juan-LARRAYA/TPP/firmware/demos/TPP STM/arduino VARIOS/demos/DuinoSTM32/BQ comands.png

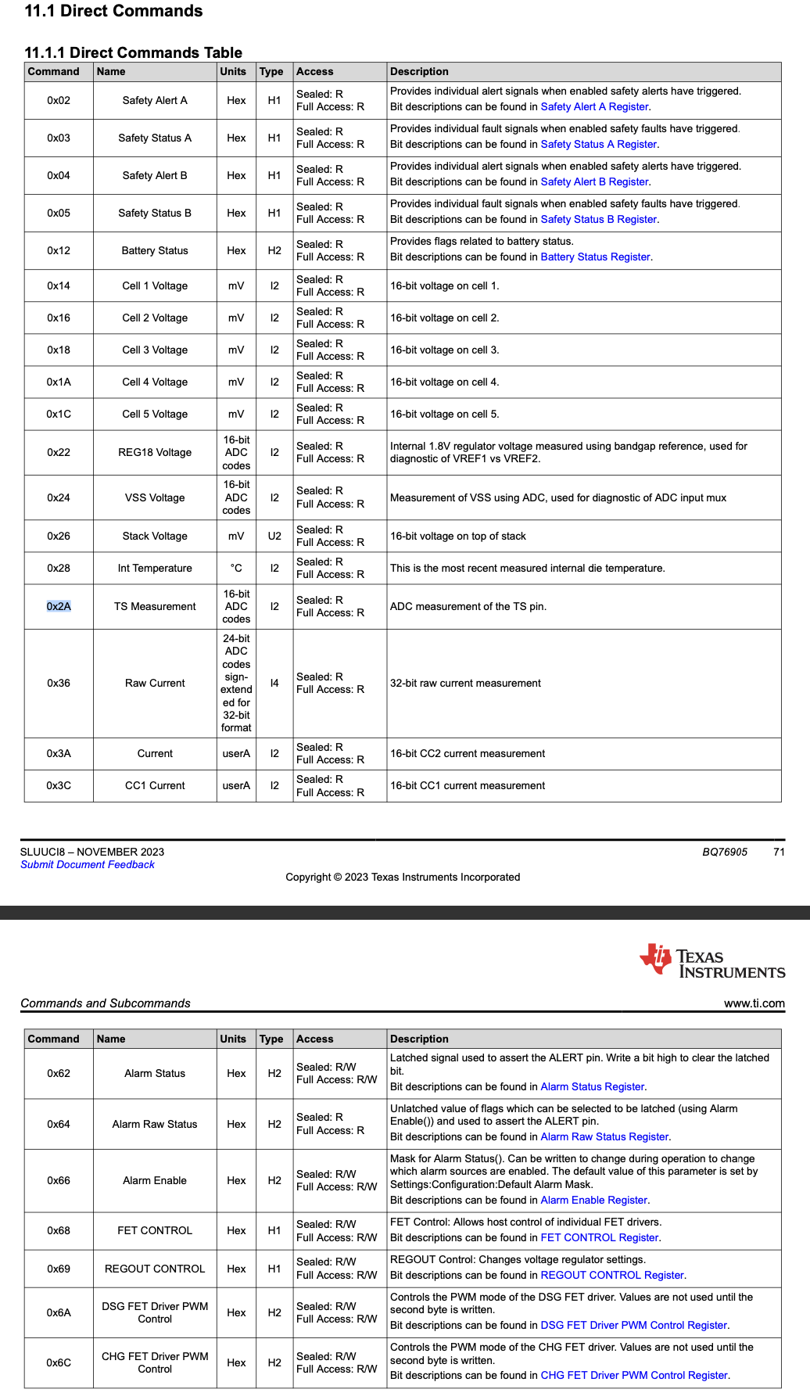
firmware/demos/TPP STM/arduino VARIOS/demos/DuinoSTM32/BQ comands.png
