juan-LARRAYA/TPP/firmware/demos/TPP STM/arduino VARIOS/demos/DuinoSTM32/la buena config.png

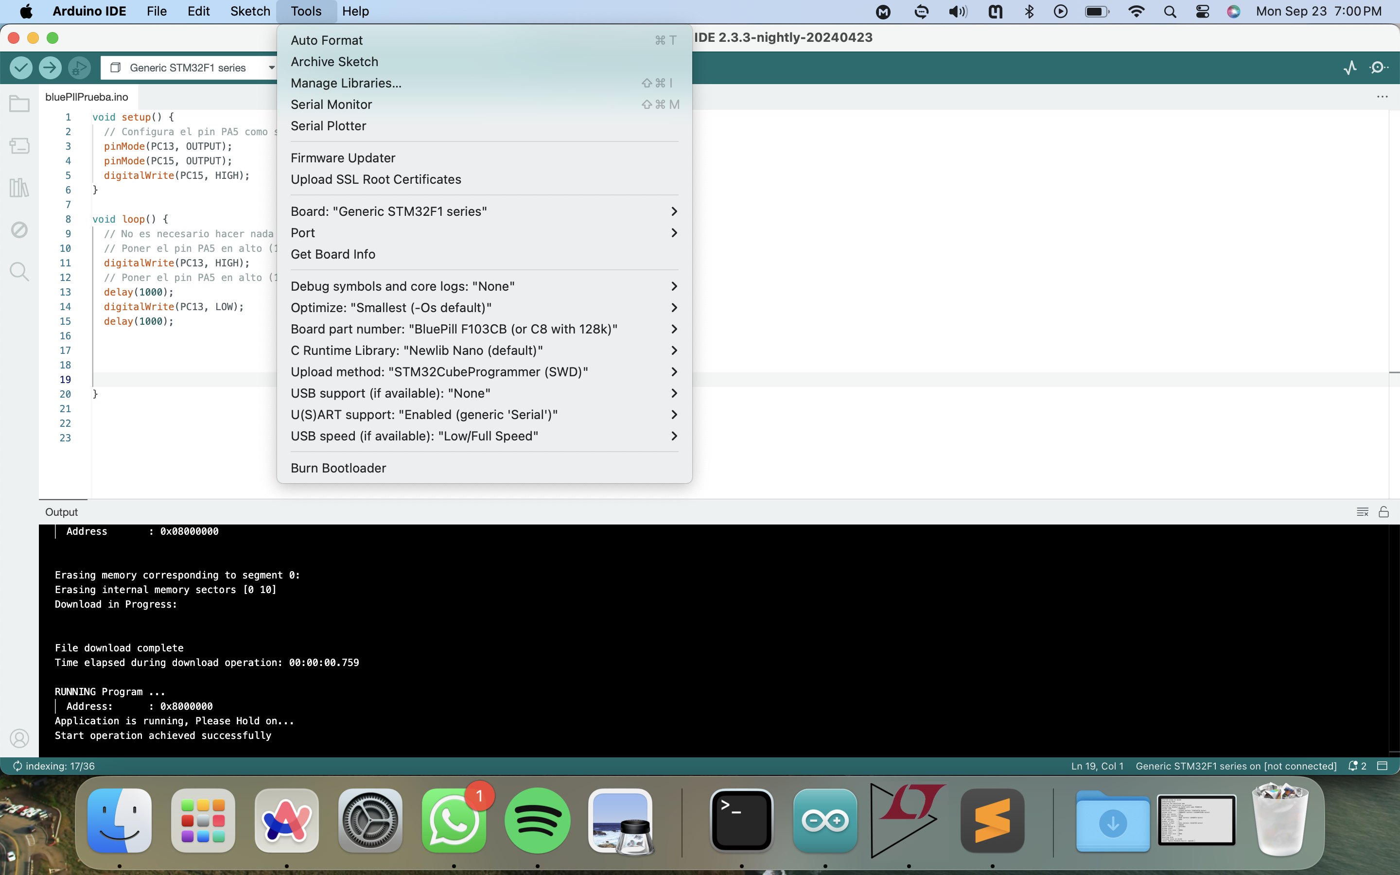
firmware/demos/TPP STM/arduino VARIOS/demos/DuinoSTM32/la buena config.png
