juan-LARRAYA/TPP/firmware/demos/TPP STM/arduino VARIOS/demos/DuinoSTM32/STM32 PINOUT.png

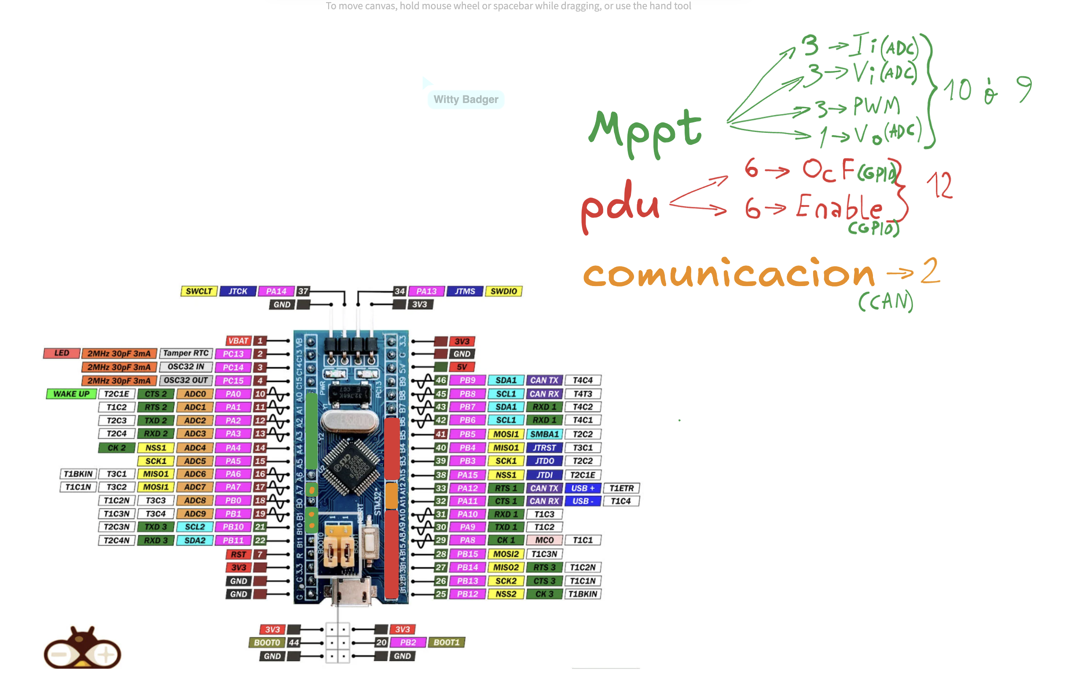
firmware/demos/TPP STM/arduino VARIOS/demos/DuinoSTM32/STM32 PINOUT.png
