juan-LARRAYA/TPP/firmware/demos/TPP STM/arduino VARIOS/demos/stm32 clocktree.jpg

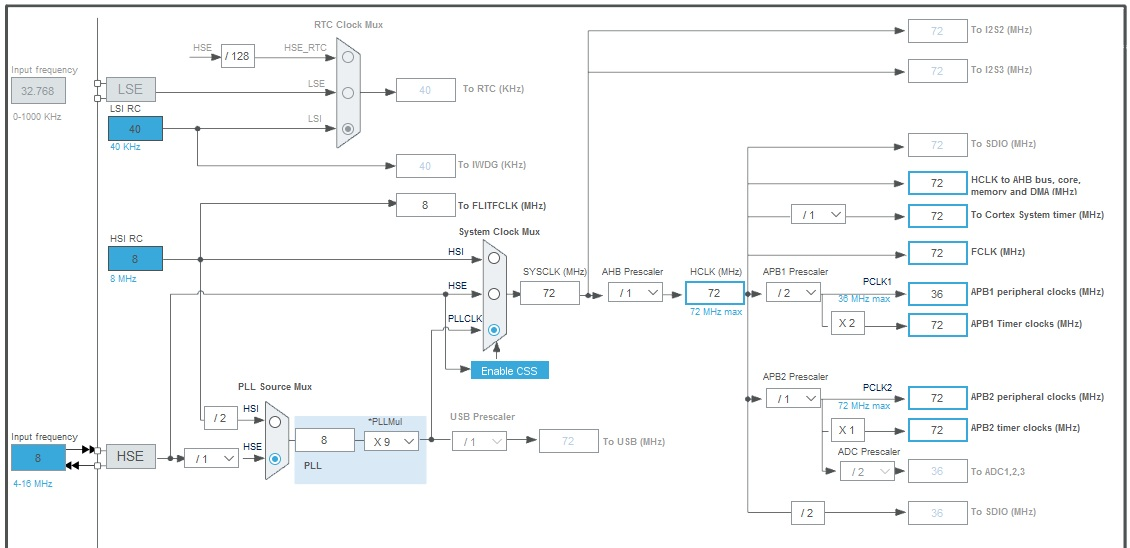
firmware/demos/TPP STM/arduino VARIOS/demos/stm32 clocktree.jpg
