juan-LARRAYA/TPP/firmware/demos/TPP STM/arduino VARIOS/piserial/graficos/carga 0,5 con errores/corrienteCarga0-5C.png

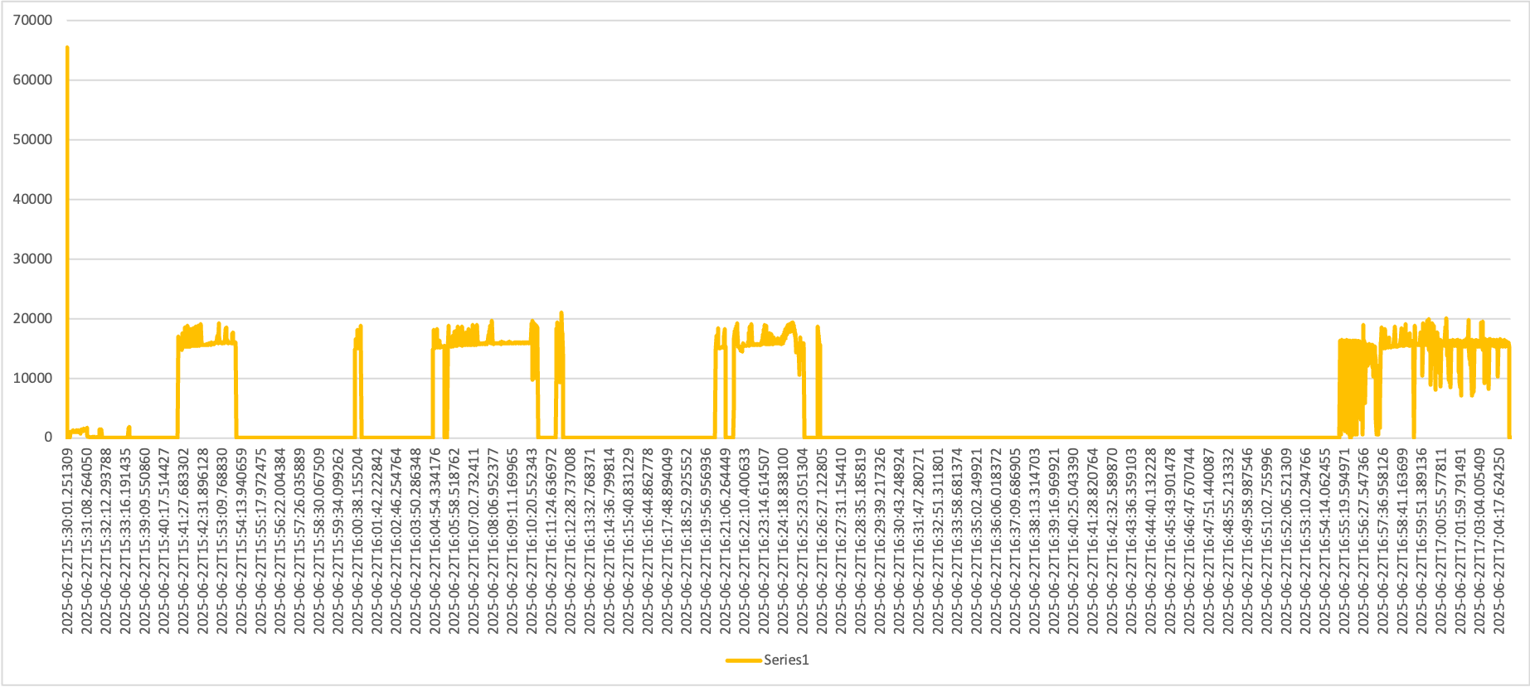
firmware/demos/TPP STM/arduino VARIOS/piserial/graficos/carga 0,5 con errores/corrienteCarga0-5C.png
