juan-LARRAYA/TPP/firmware/demos/TPP STM/arduino VARIOS/piserial/graficos/descarga 0,2 megalite/tension.png

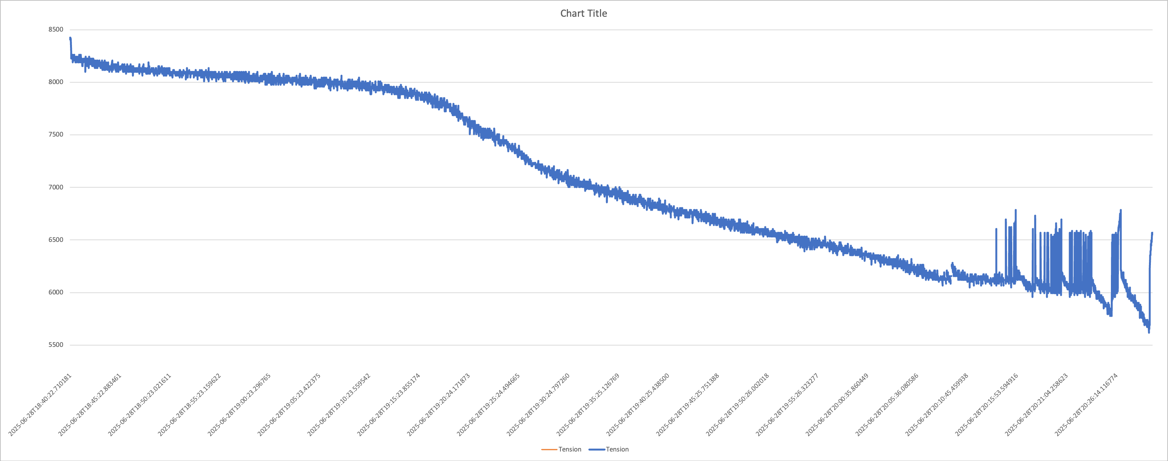
firmware/demos/TPP STM/arduino VARIOS/piserial/graficos/descarga 0,2 megalite/tension.png
