juan-LARRAYA/TPP/firmware/demos/TPP STM/STM/config ide.png

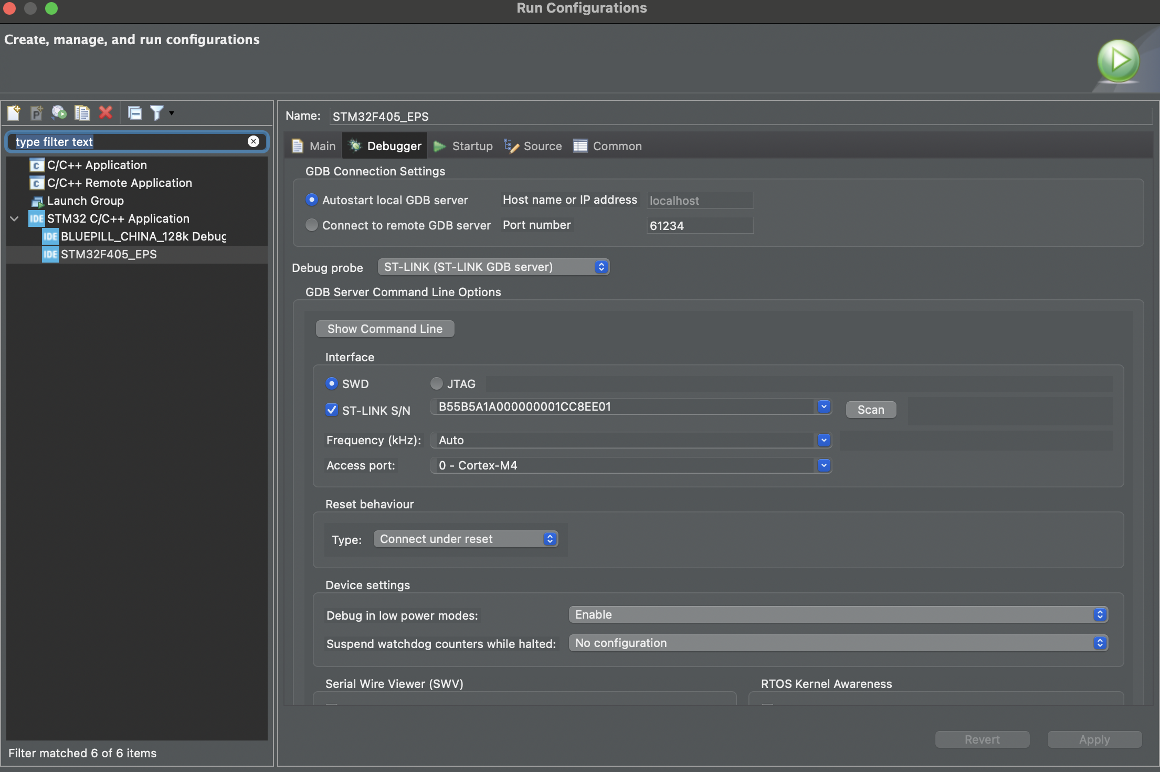
firmware/demos/TPP STM/STM/config ide.png
