juan-LARRAYA/TPP/utilidades/fotos/4.png

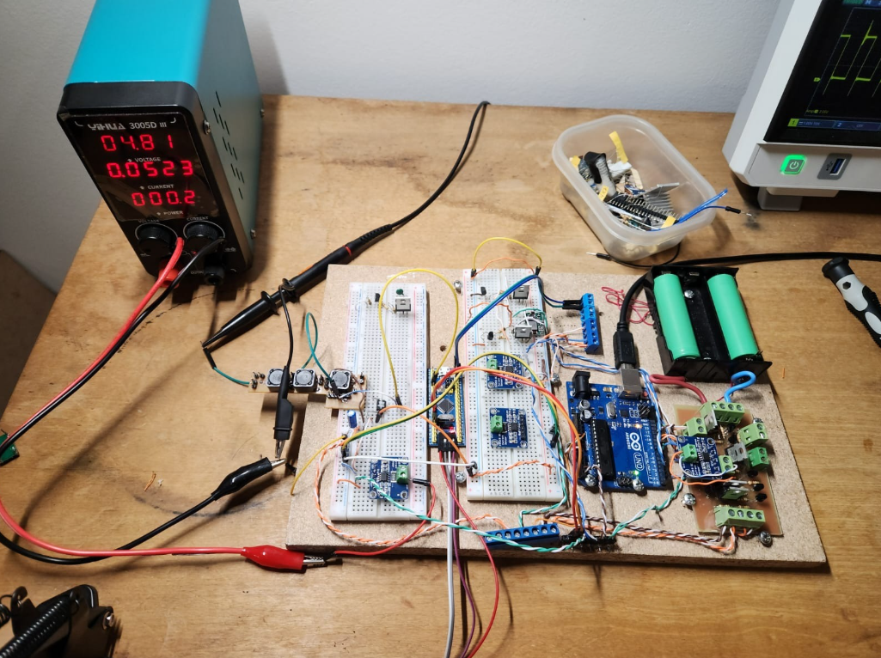
utilidades/fotos/4.png
