juan-LARRAYA/TPP/hardware/power sistem/superados/PowerSis-V4.4/Librerias/DW01A--3DModel-STEP-56544.STEP

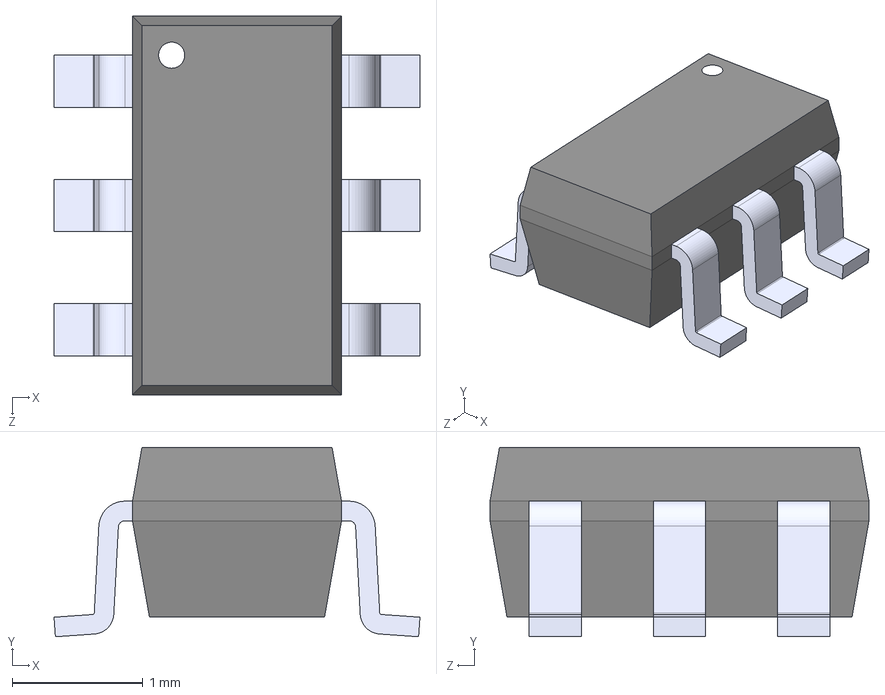
[picture p136: CAD file, 2024-11-17]
hardware/power sistem/superados/PowerSis-V4.4/Librerias/DW01A--3DModel-STEP-56544.STEP
2.80 x 1.45 x 2.90 mm
