juan-LARRAYA/TPP/hardware/power sistem/superados/PowerSis-V4.4/Librerias/BH24DW.step

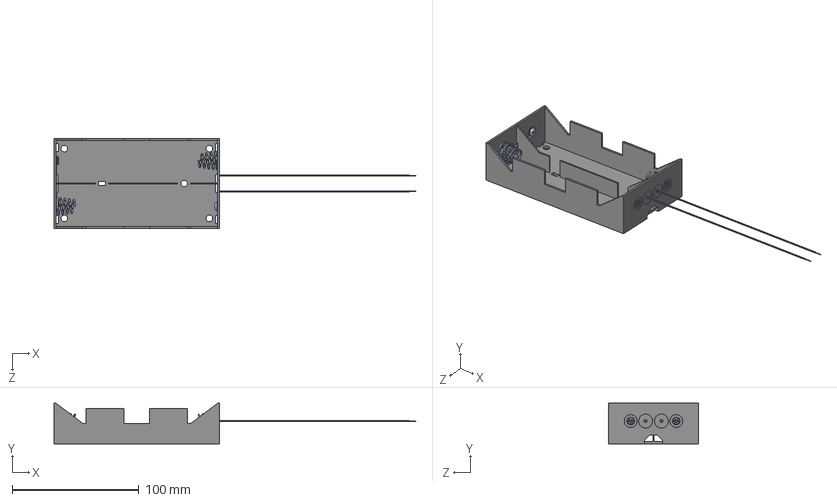
[picture p137: CAD file, 2024-11-17]
hardware/power sistem/superados/PowerSis-V4.4/Librerias/BH24DW.step
285.8 x 32.1 x 71.1 mm
