juan-LARRAYA/TPP/firmware/demos/TPP STM/final/Pruebas enrique.md

Pruebas enrique

- probar balanceos

- probar protecciones de tension, corriente y temperatura

- probar comunicaicones y plantear interfaz correctamentes.

- traer las celdas descargadas asi podemos probarlas ambas
