juan-LARRAYA/TPP/hardware/power sistem/superados/PowerSis-V4.4/TPP.pdf

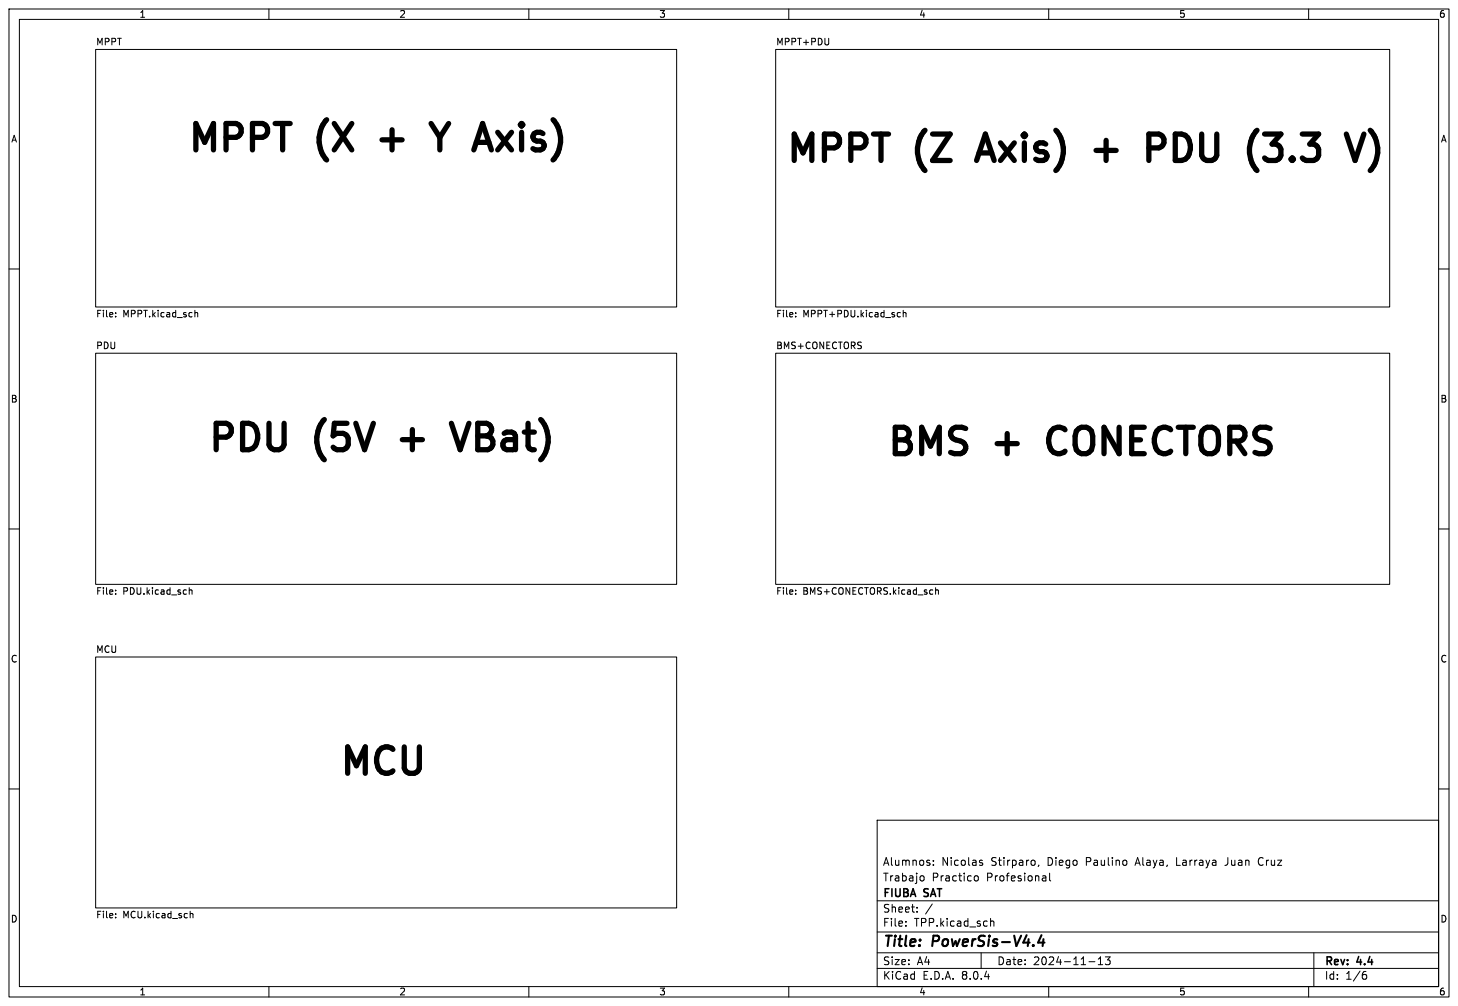
[picture p138: page 1]

File: MPPT+PDU.kicad_sch MPPT

File: TPP.kicad_sch Sheet: / FIUBA SAT

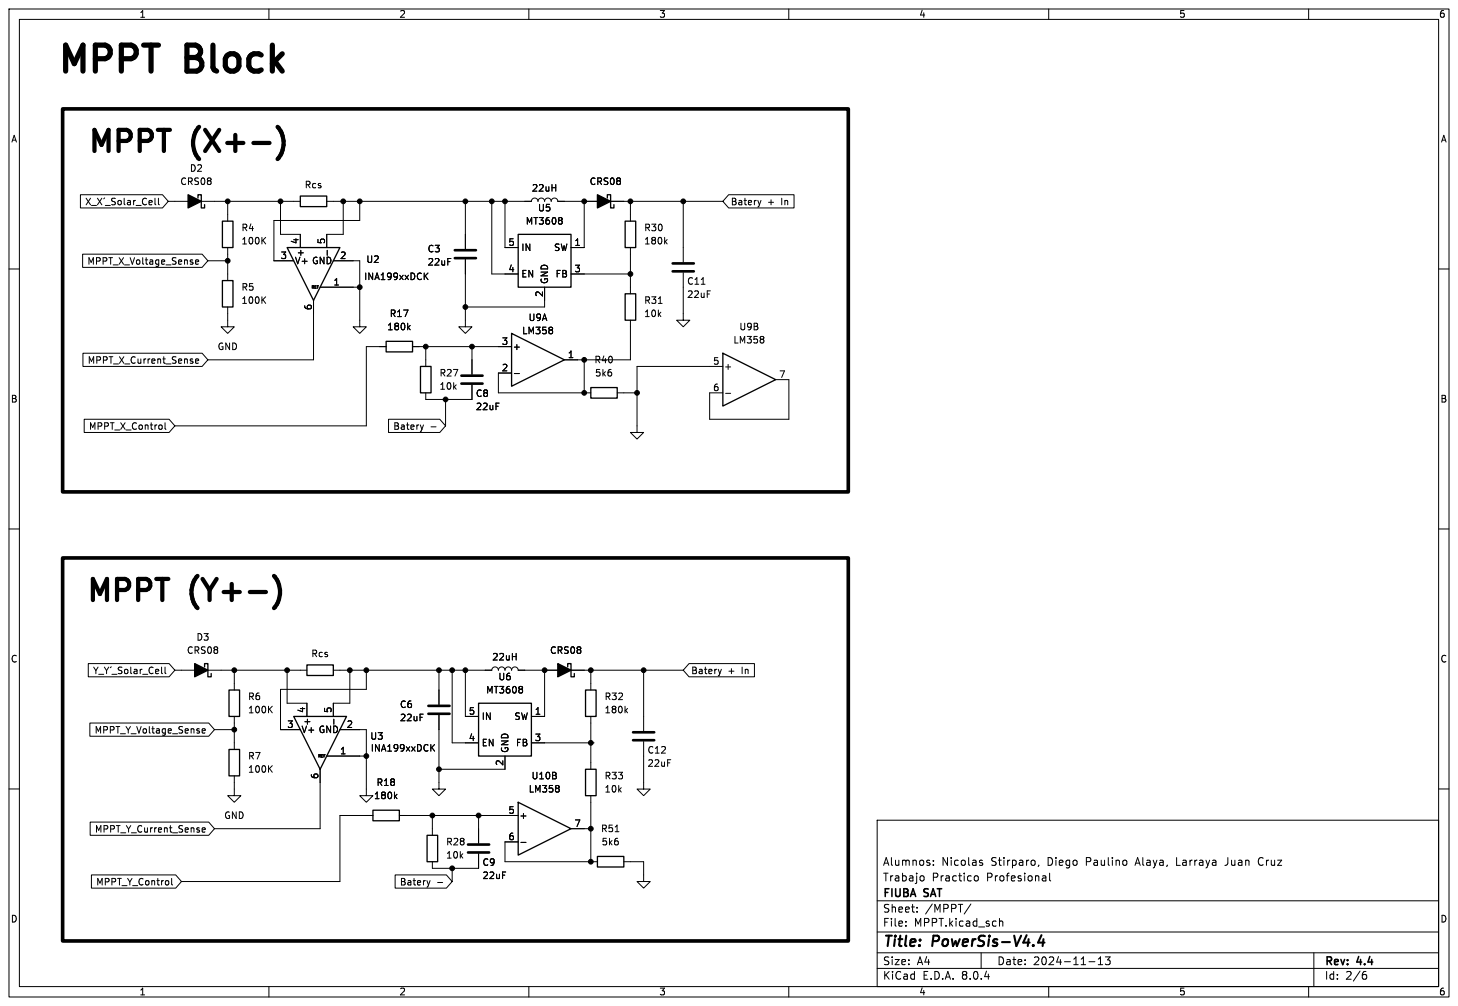
[picture p139: page 2]

File: MPPT.kicad_sch Sheet: /MPPT/ FIUBA SAT

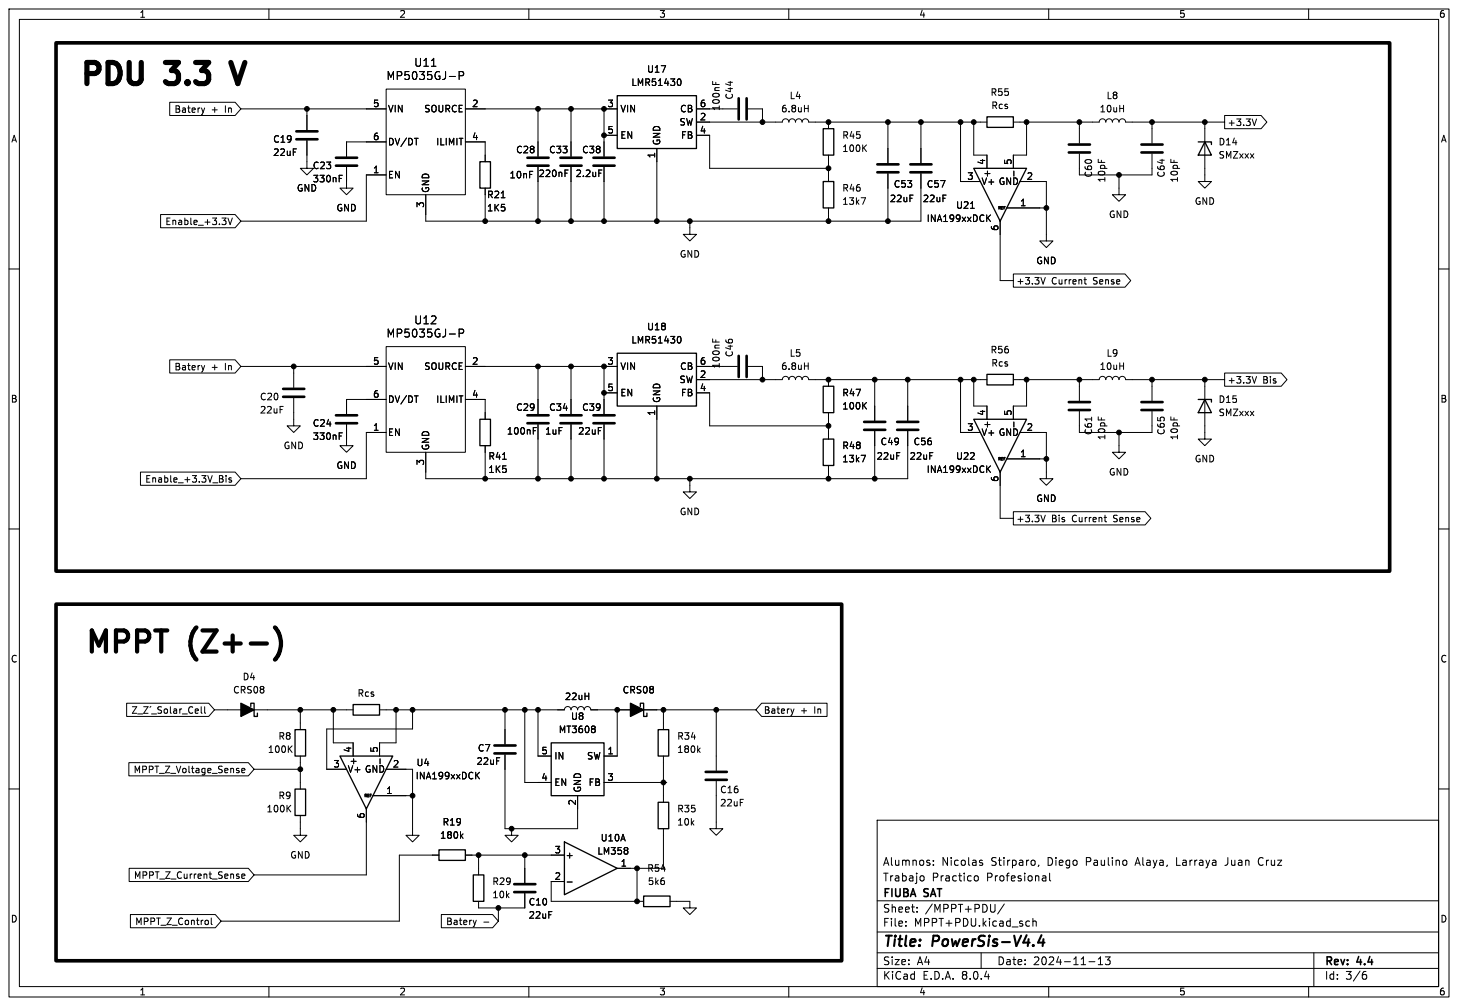
[picture p140: page 3]

Batery + In Batery + In MPPT (Z+-)

1 SW 2 VIN 3 FB 4 EN 5 CB 6 U17
LMR51430

1 SW 2 VIN 3 FB 4 EN 5 CB 6 U22

ILIMIT 4 VIN 5 DV/DT 6 C19
22uF GND

1 SW 2 VIN 3 FB 4 EN 5 CB 6 C28

1 SW 2 VIN 3 FB 4 EN 5 CB 6 U18
LMR51430 GND

File: MPPT+PDU.kicad_sch Sheet: /MPPT+PDU/ FIUBA SAT

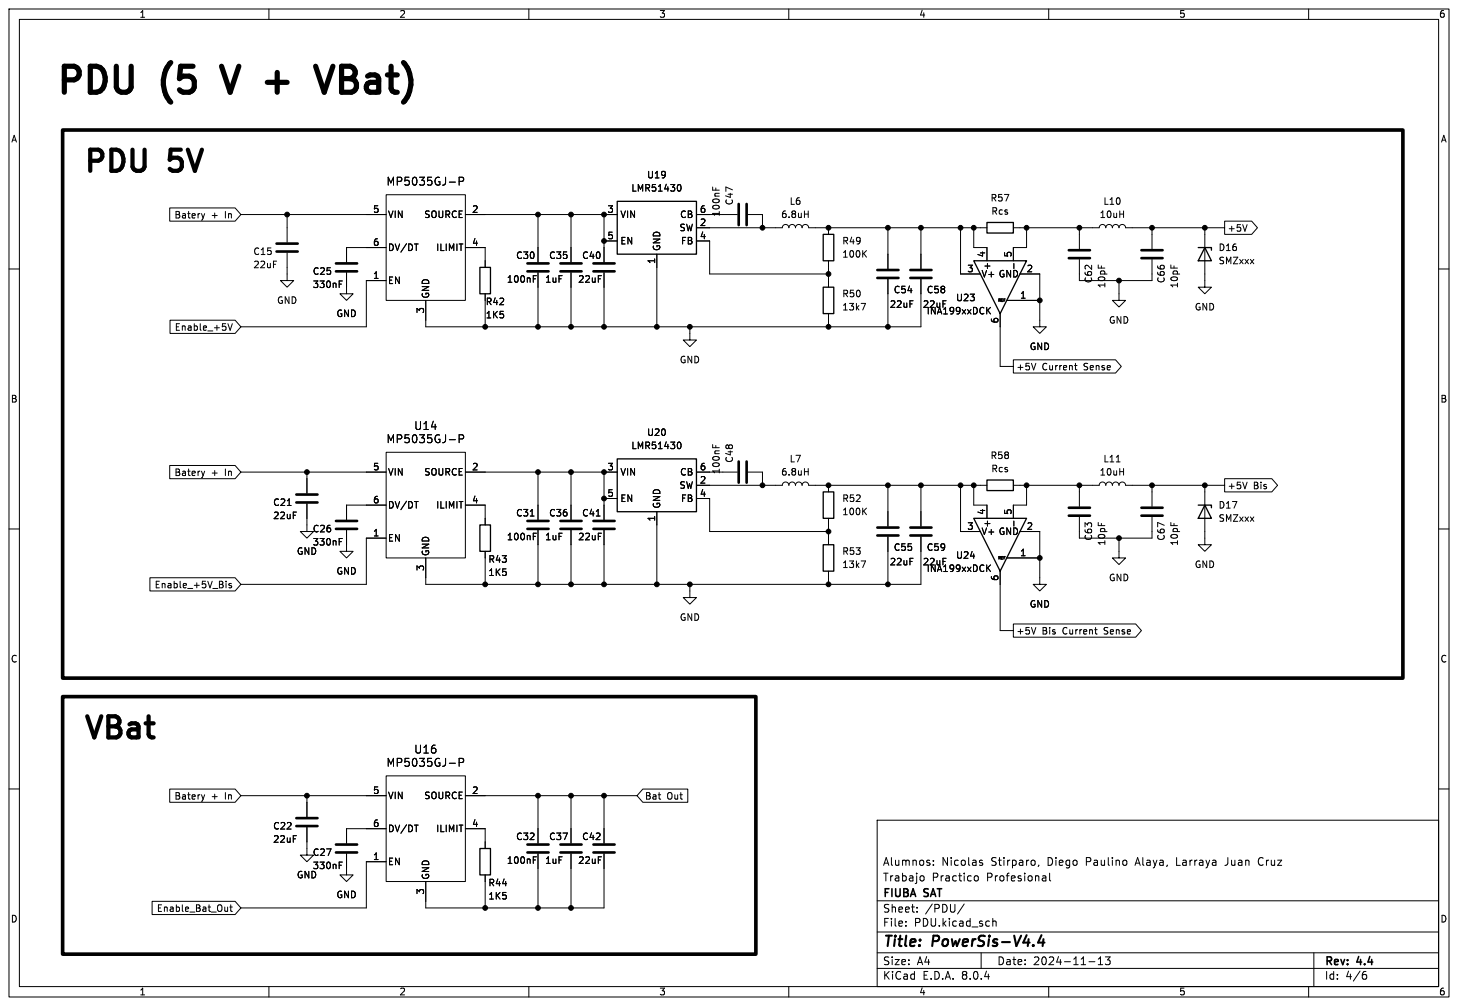
[picture p141: page 4]

1 SW 2 VIN 3 FB 4 EN 5 CB 6 U19
LMR51430 GND

1 SW 2 VIN 3 FB 4 EN 5 CB 6 C40

1 SW 2 VIN 3 FB 4 EN 5 CB 6 U20

ILIMIT 4 VIN 5 DV/DT 6 C26

+5V Bis Current Sense Batery + In VBat

File: PDU.kicad_sch Sheet: /PDU/ FIUBA SAT

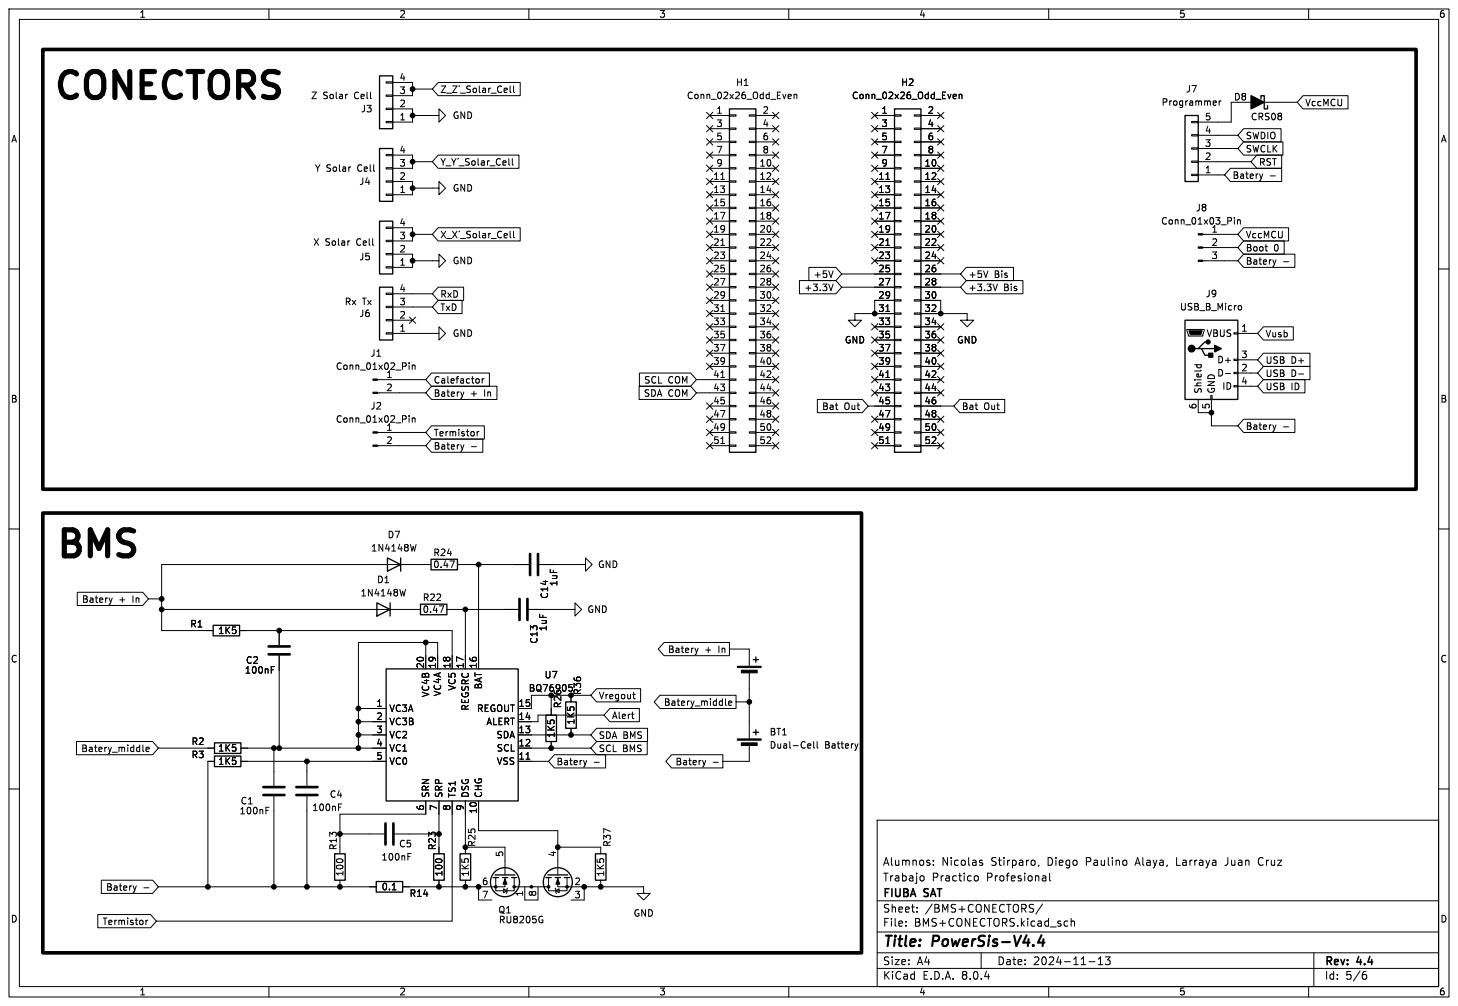
[picture p142: page 5]

Vusb Batery + In BMS

8 CHG 10 VSS 11 SCL 12 SDA 13 DSG

File: BMS+CONECTORS.kicad_sch Sheet: /BMS+CONECTORS/ FIUBA SAT

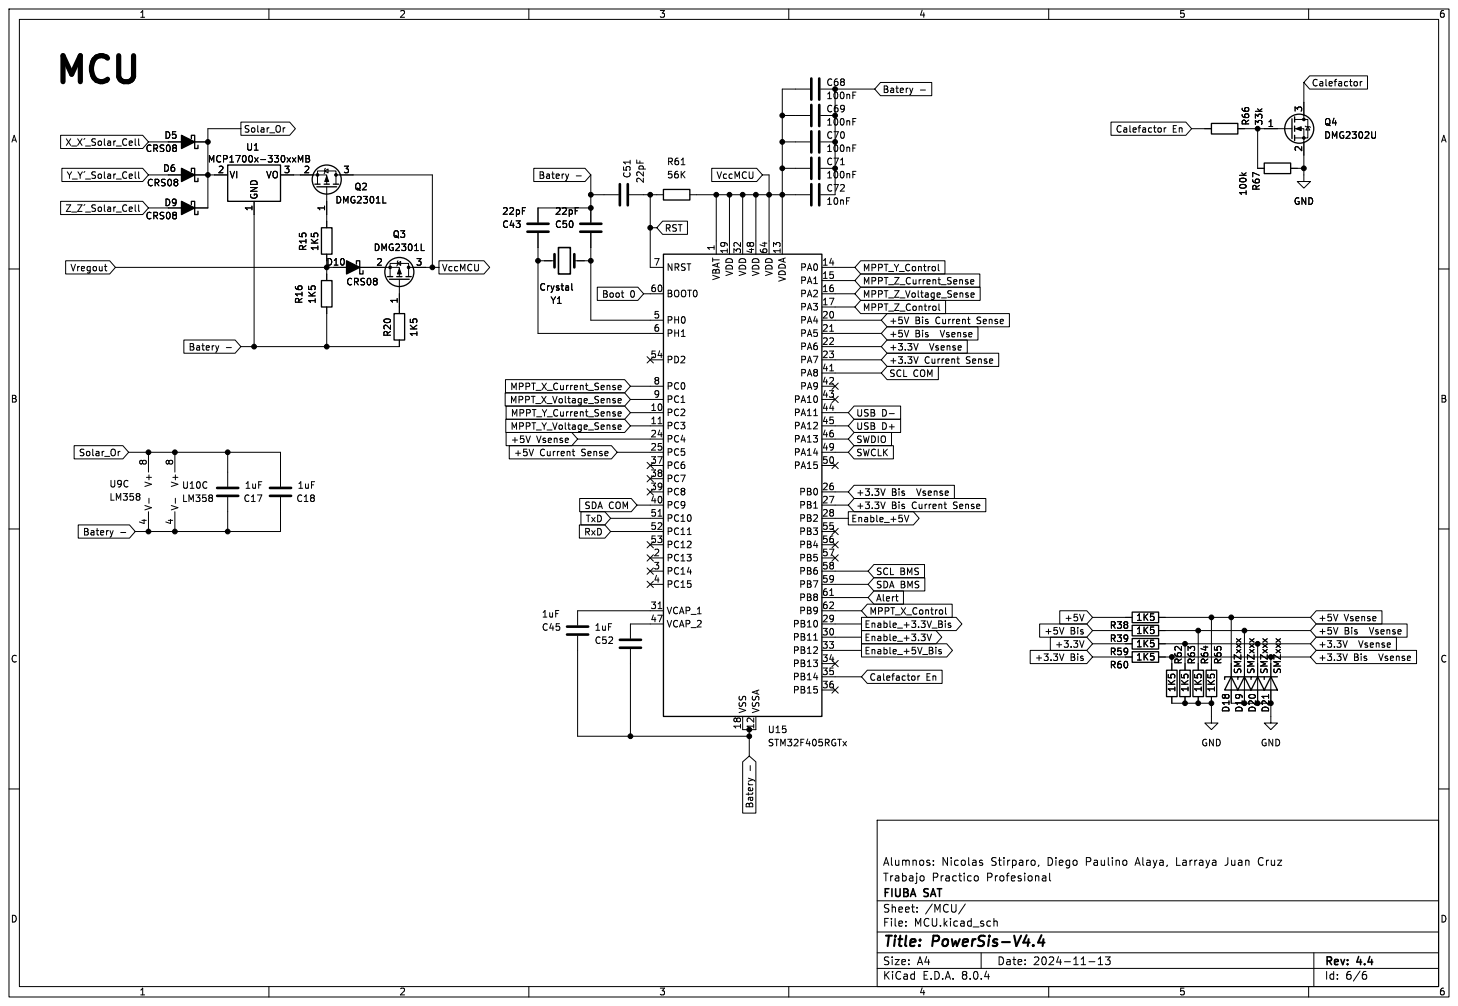
[picture p143: page 6]

Enable_+5V USB D- USB D+ SWDIO MCU

2 3 D20 SMZxxx D21 SMZxxx D19 SMZxxx D18 SMZxxx R65 1K5 R64 1K5 R62 1K5 R63 1K5

1 PC2 10 PC3 11 VSSA 12 VDDA 13 PA0 14 PA1 15 PA2 16 PA3 17 VSS 18 VDD 19 PC13 2 PA4 20 PA5 21 PA6 22 PA7 23 PC4 24 PC5 25 PB0 26 PB1 27 PB2 28 PB10 29 PC14 3 PB11 30 VCAP_1 31 VDD 32 PB12 33 PB13 34 PB14 35 PB15 36 PC6 37 PC7 38 PC8 39 PC15 4 PC9 40 PA8 41 PA9 42 PA10 43 PA11 44 PA12 45 PA13 46 VCAP_2 47 VDD 48 PA14 49 PH0 5 PA15 50 PC10 51 PC11 52 PC12 53 PD2 54 PB3 55 PB4 56 PB5 57 PB6 58 PB7 59 PH1 6 BOOT0 60 PB8 61 PB9 62 VDD 64 NRST 7 PC0 8 PC1 9 U15 STM32F405RGTx

File: MCU.kicad_sch Sheet: /MCU/ FIUBA SAT
