juan-LARRAYA/TPP/Info util CubeSat ENERGIA/Presentacion final indusrtias/Exposicion final Sistema de Energia CubeSat.pdf

# CubeSat

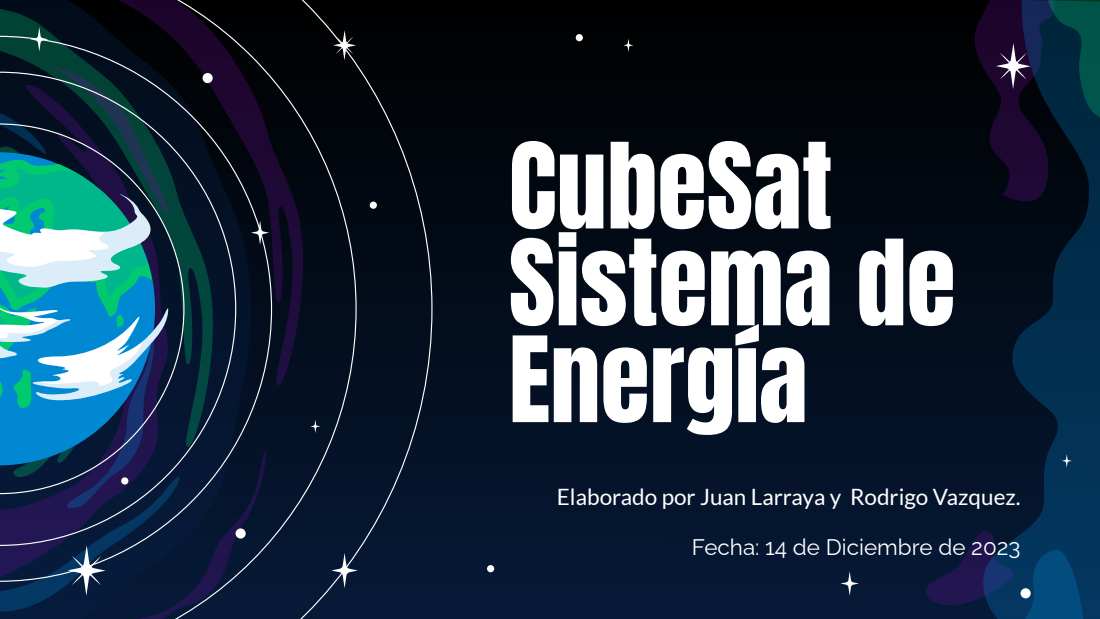
[picture p144: page 1]

Sistema de Energía

Elaborado por Juan Larraya y Rodrigo Vazquez.

Fecha: 14 de Diciembre de 2023

01

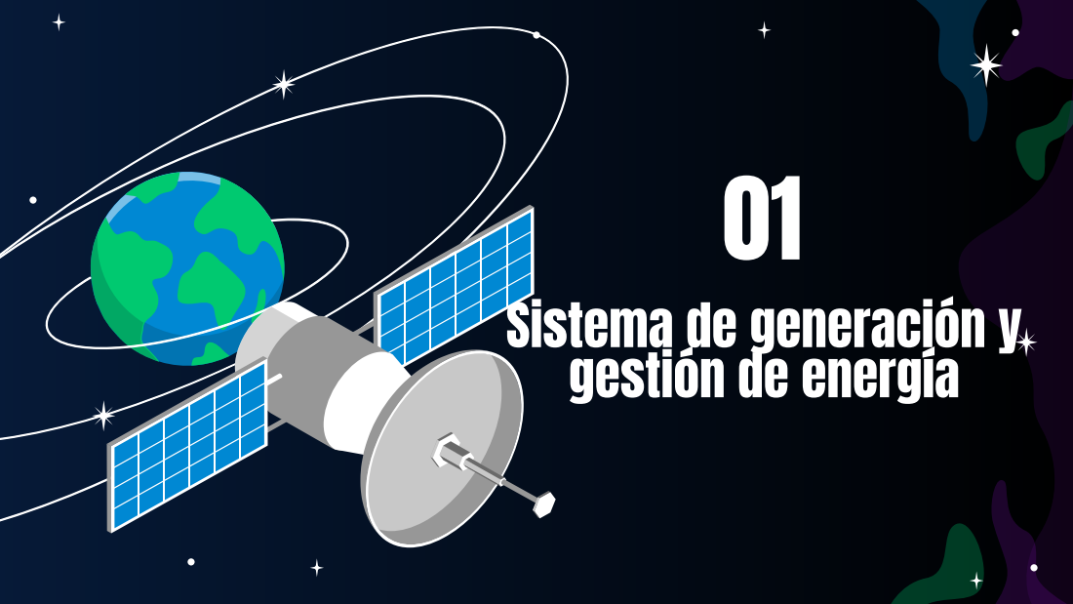
[picture p145: page 2]

Sistema de generación y gestión de energía

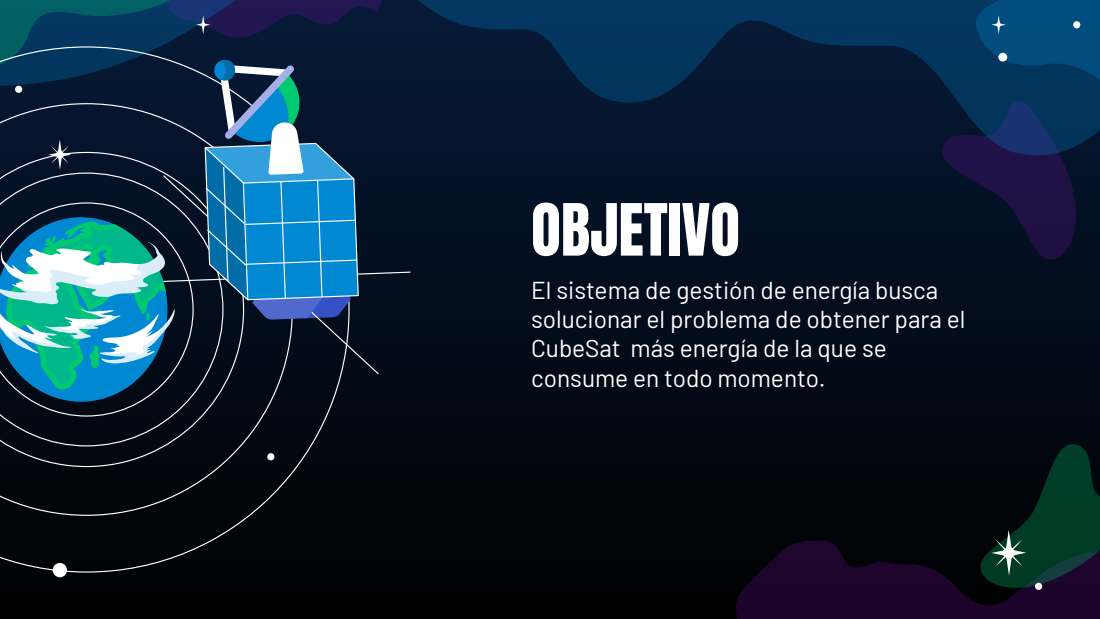
[picture p146: page 3]
OBJETIVO

El sistema de gestión de energía busca
solucionar el problema de obtener para el
CubeSat más energía de la que se
consume en todo momento.

# Componentes del sistema de generación

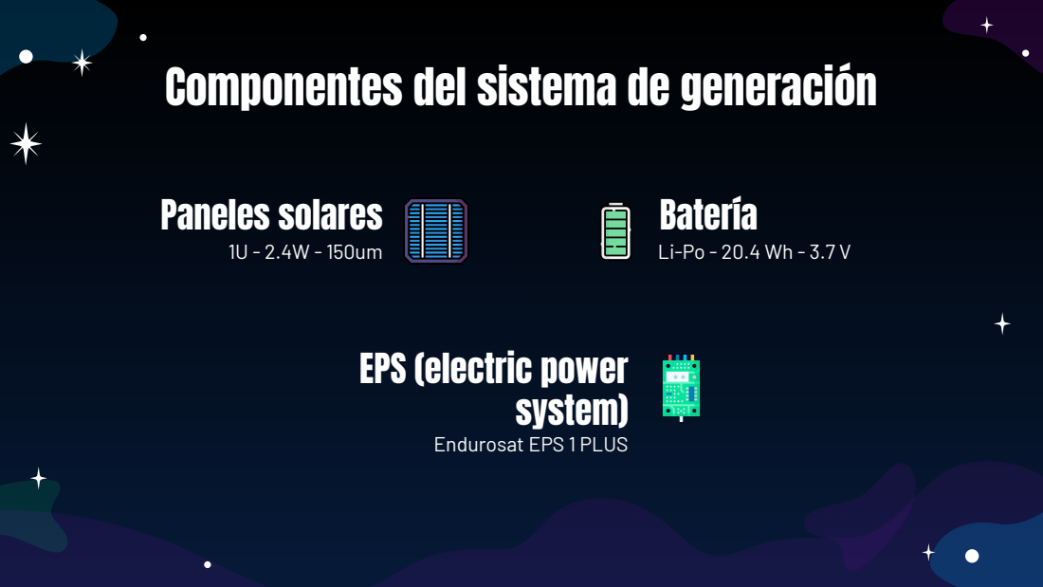
[picture p147: page 4]
Paneles solares; Batería

EPS (electric power
system)

Endurosat EPS 1 PLUS

# Cálculo de generacion de energia

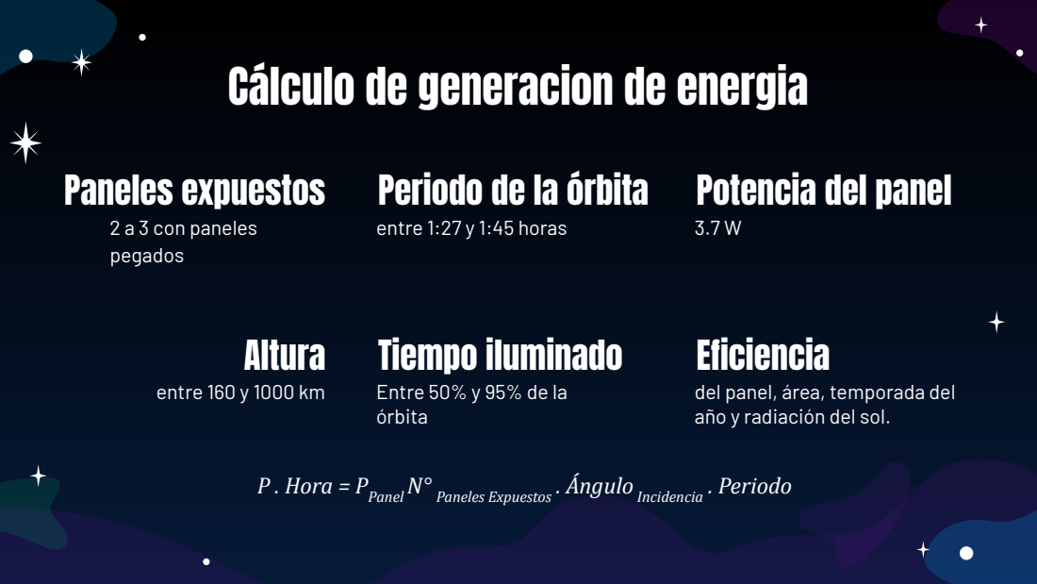
[picture p148: page 5]
Paneles expuestos; 2 a 3 con paneles pegados; entre 1:27 y 1:45 horas; Altura; entre 160 y 1000 km; Tiempo iluminado; Eficiencia

Periodo de la órbita

Potencia del panel

Entre 50% y 95% de la
órbita

del panel, área, temporada del
año y radiación del sol.

P . Hora = PPanel N° Paneles Expuestos . Ángulo Incidencia . Periodo

# Resultados

11.19 Wh

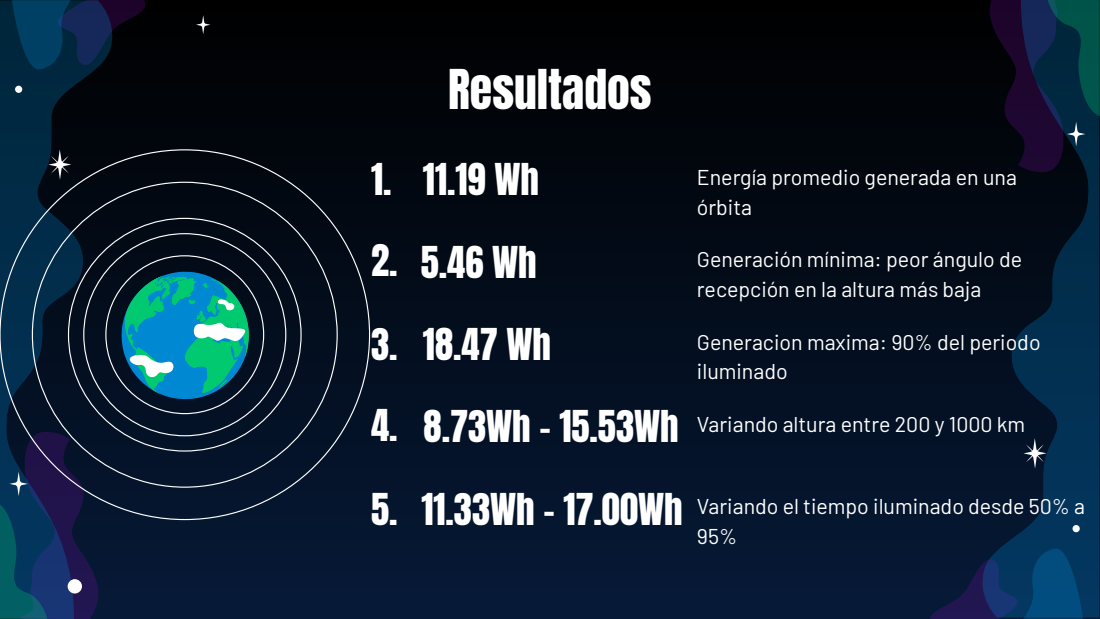
[picture p149: page 6]

Energía promedio generada en una
órbita

Generación mínima: peor ángulo de
recepción en la altura más baja

Generacion maxima: 90% del periodo
iluminado

4. | 8.73Wh - 15.53Wh
5.

Variando altura entre 200 y 1000 km

Variando el tiempo iluminado desde 50% a

# Ángulo de incidencia

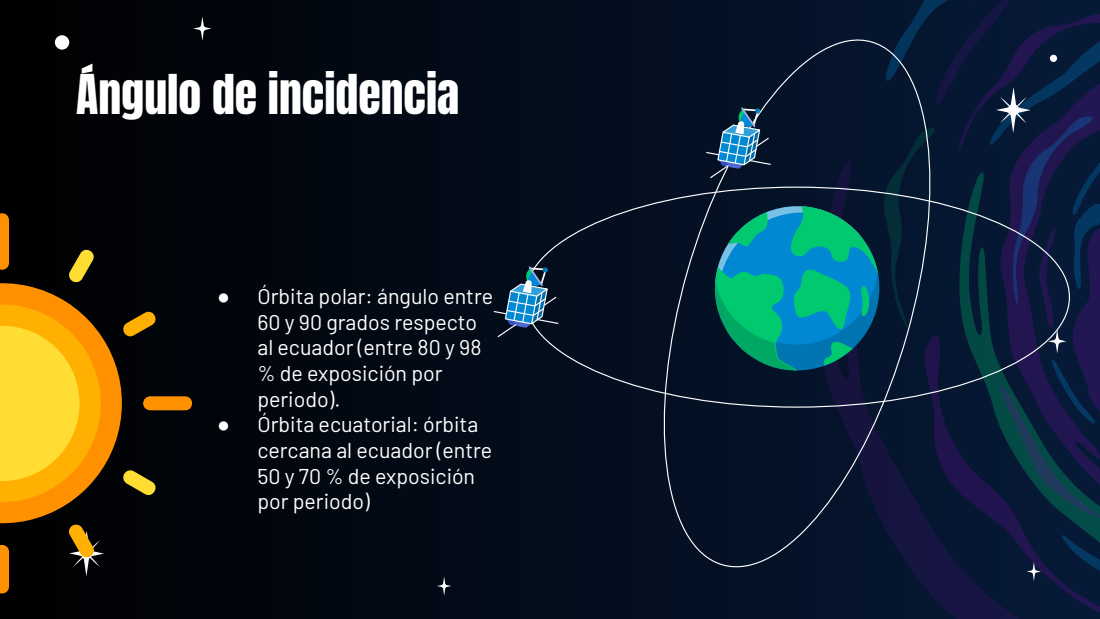
[picture p150: page 7]

● Órbita polar: ángulo entre
60 y 90 grados respecto
al ecuador (entre 80 y 98
% de exposición por
periodo).
● Órbita ecuatorial: órbita
cercana al ecuador (entre
50 y 70 % de exposición
por periodo)

# Potencia generada en función de la orientación del CubeSat

## órbita tangencial a la tierra

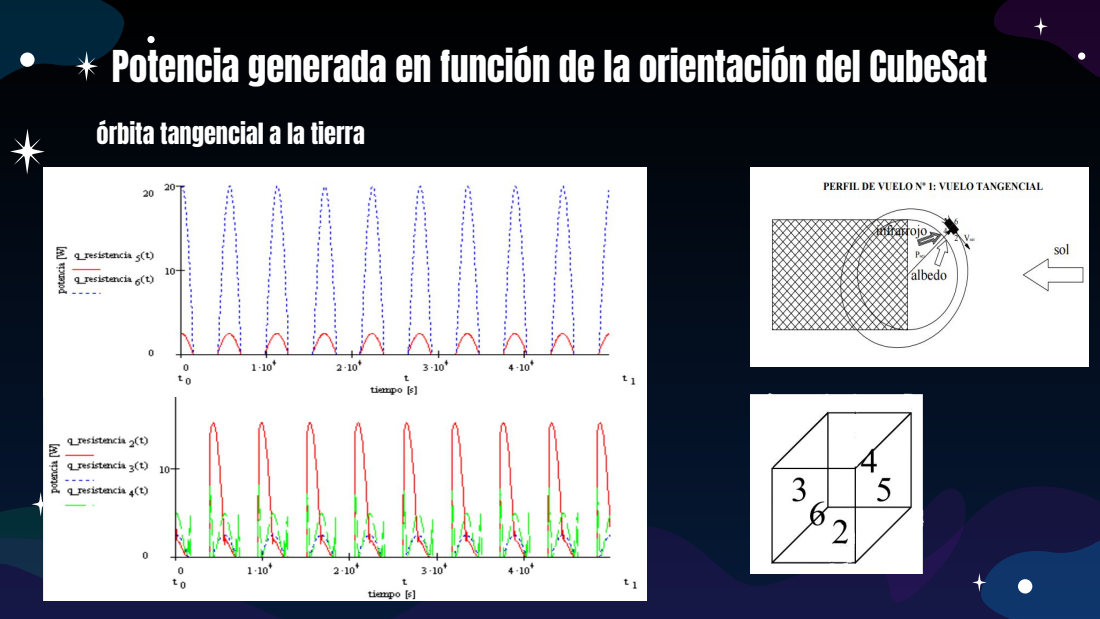
[picture p151: page 8]

# Potencia generada en función de la orientación del CubeSat

## cara apuntando al sol

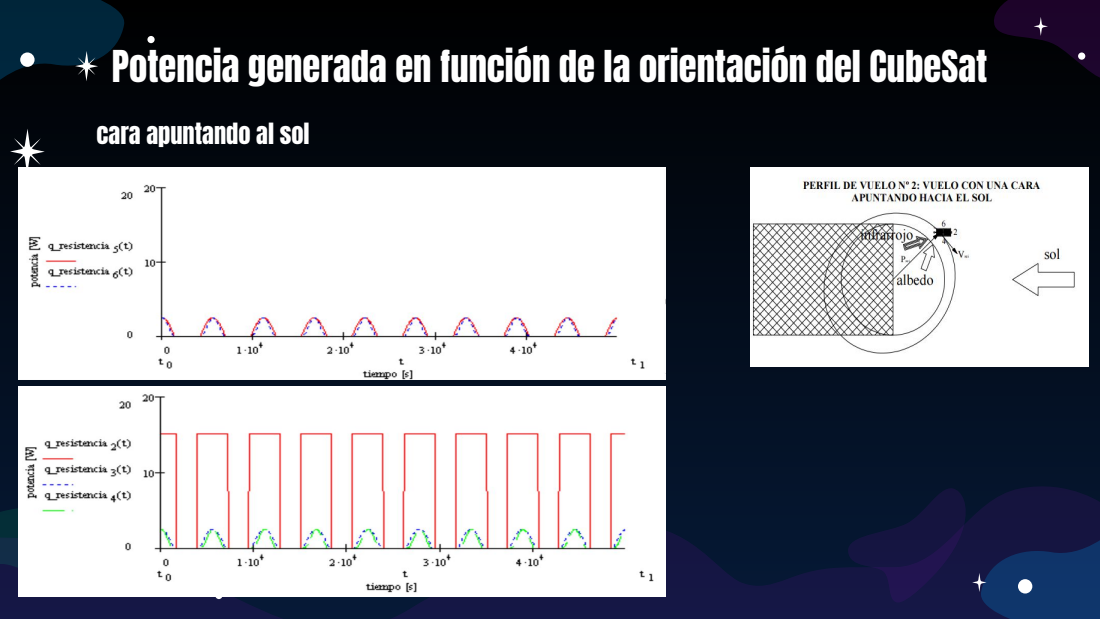
[picture p152: page 9]

# Potencia generada en función de la orientación del CubeSat

## aleatorio

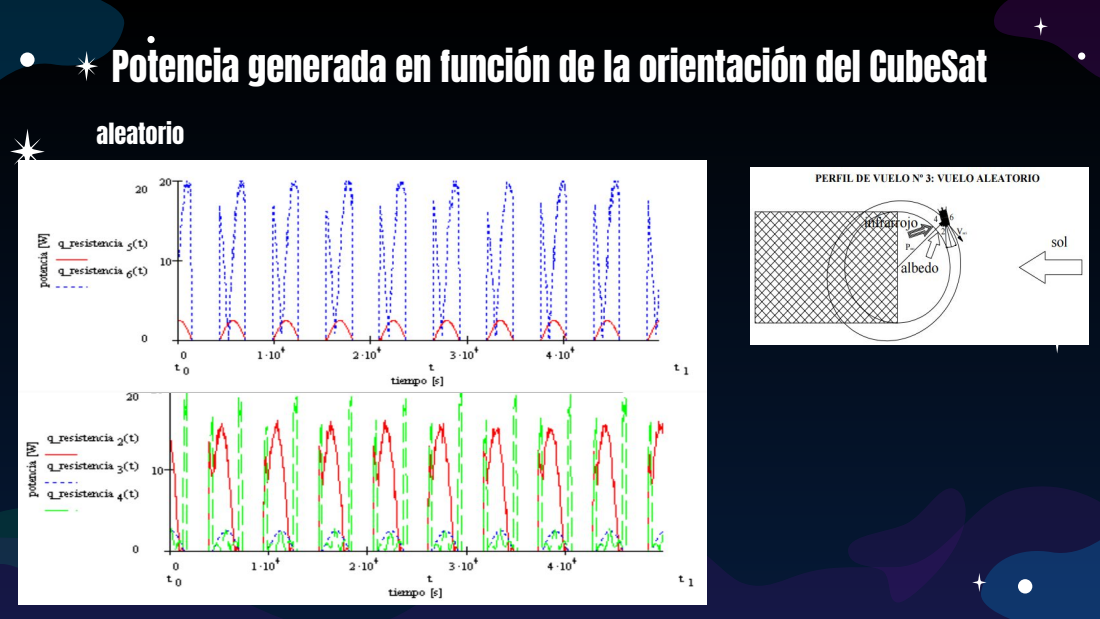
[picture p153: page 10]

# Potencia generada

# en función de la orientación del CubeSat

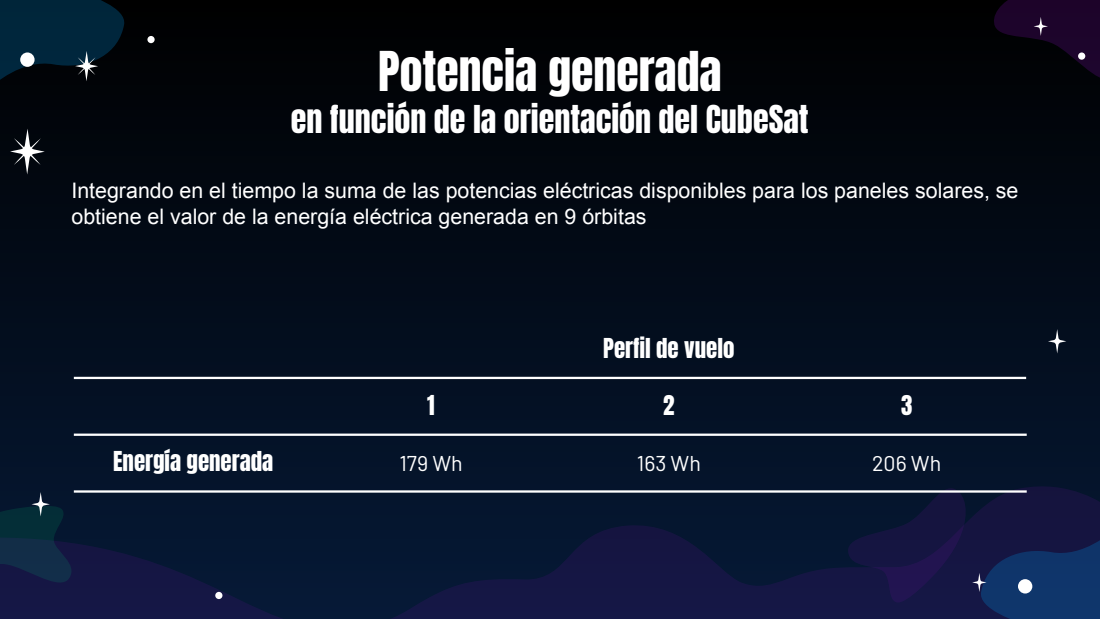
[picture p154: page 11]
Energía generada

Integrando en el tiempo la suma de las potencias eléctricas disponibles para los paneles solares, se
obtiene el valor de la energía eléctrica generada en 9 órbitas

Perfil de vuelo

02

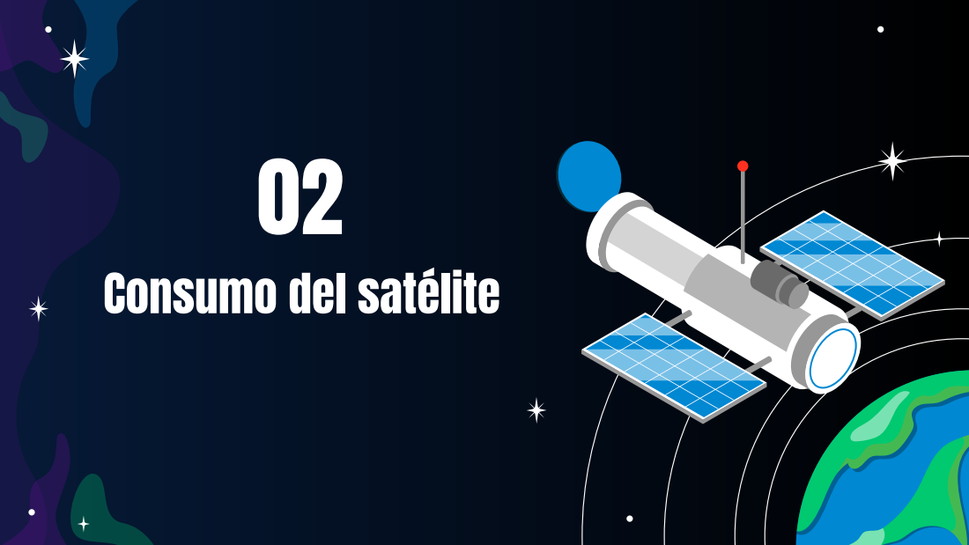
[picture p155: page 12]

Consumo del satélite

# sistemas internos del satélite

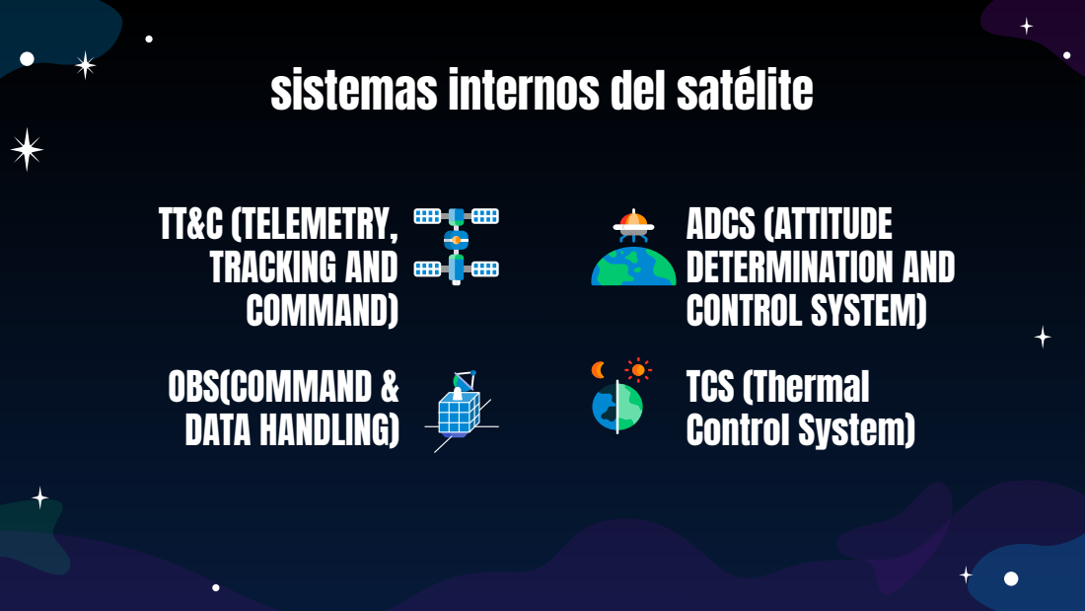
[picture p156: page 13]
TT&C (TELEMETRY, TRACKING AND COMMAND); ADCS (ATTITUDE DETERMINATION AND CONTROL SYSTEM); OBS(COMMAND & DATA HANDLING); TCS (Thermal Control System)

# Potencia consumida por día de cada sistema en función de su uso

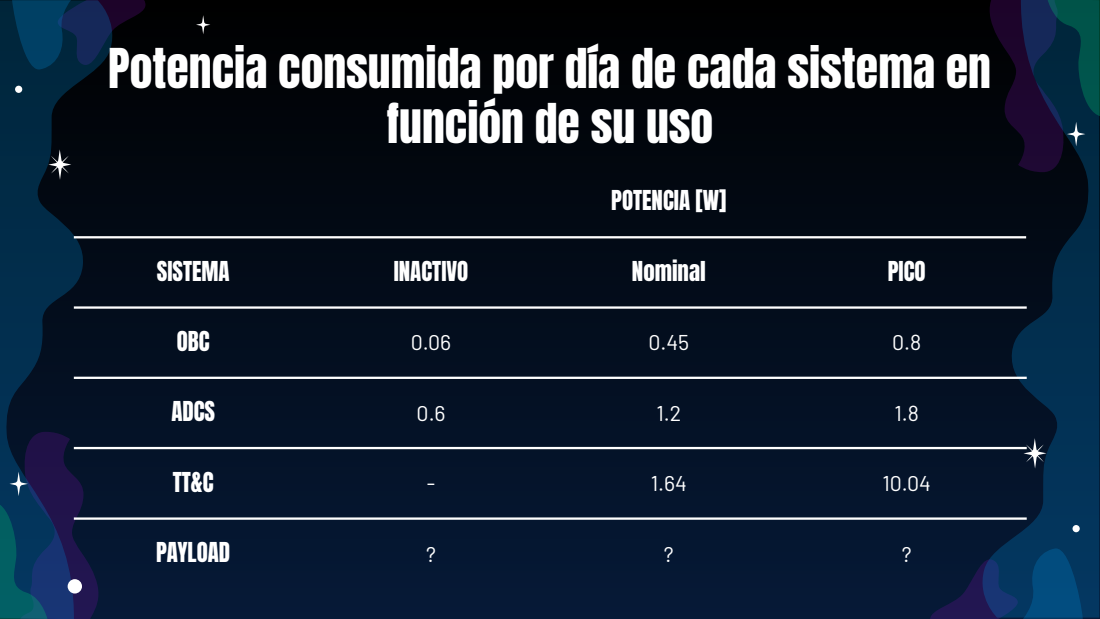
[picture p157: page 14]
POTENCIA [W]; SISTEMA; INACTIVO; Nominal; PICO; OBC; ADCS; PAYLOAD

03

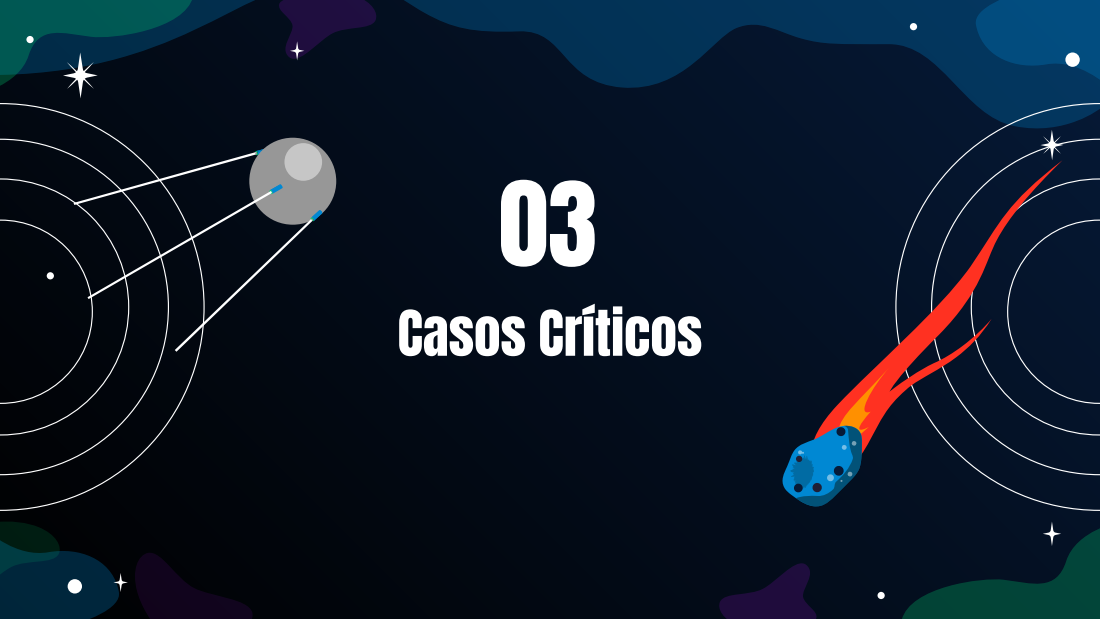
[picture p158: page 15]
Casos Críticos

# Momento de consumo para transmisión

## sobrevuelo del territorio argentino

Esto ocurre 4 veces por dia en total está aproximadamente 30 minutos transmitiendo que según los cálculos realizados por la investigación del subsistema de comunicaciones esto consume aproximadamente 10 W al dia es decir 2.5 W por pasada sobre la tierra

en esas pasadas hay picos de consumo que deben considerarse como el peor caso

# Potencia consumida por periodo

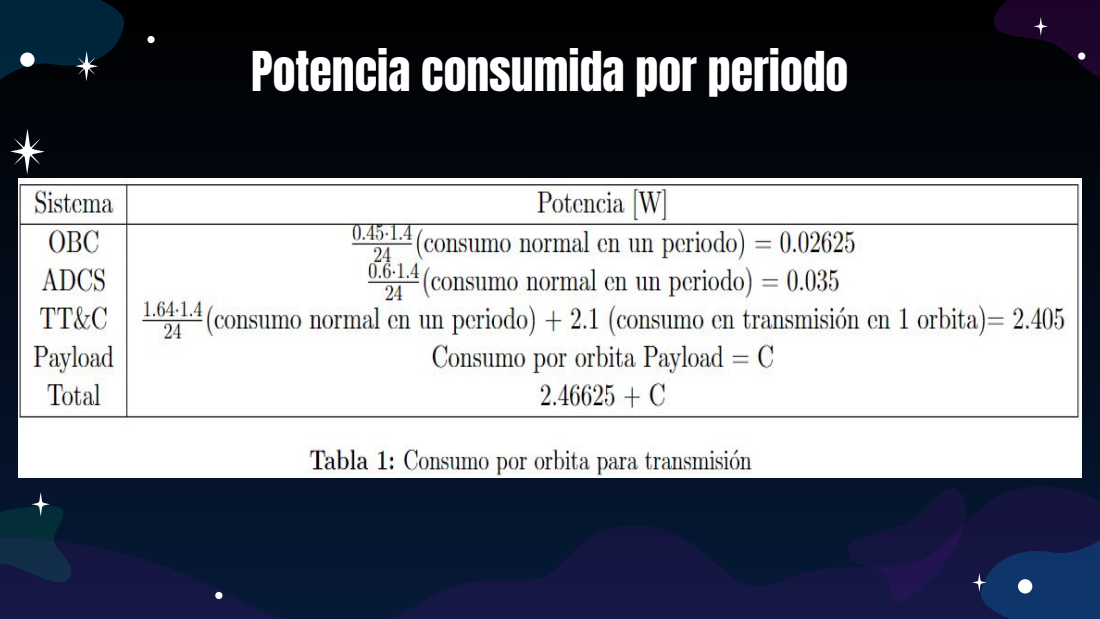
[picture p159: page 17]

# Potencia consumida por día de cada sistema en función de su uso

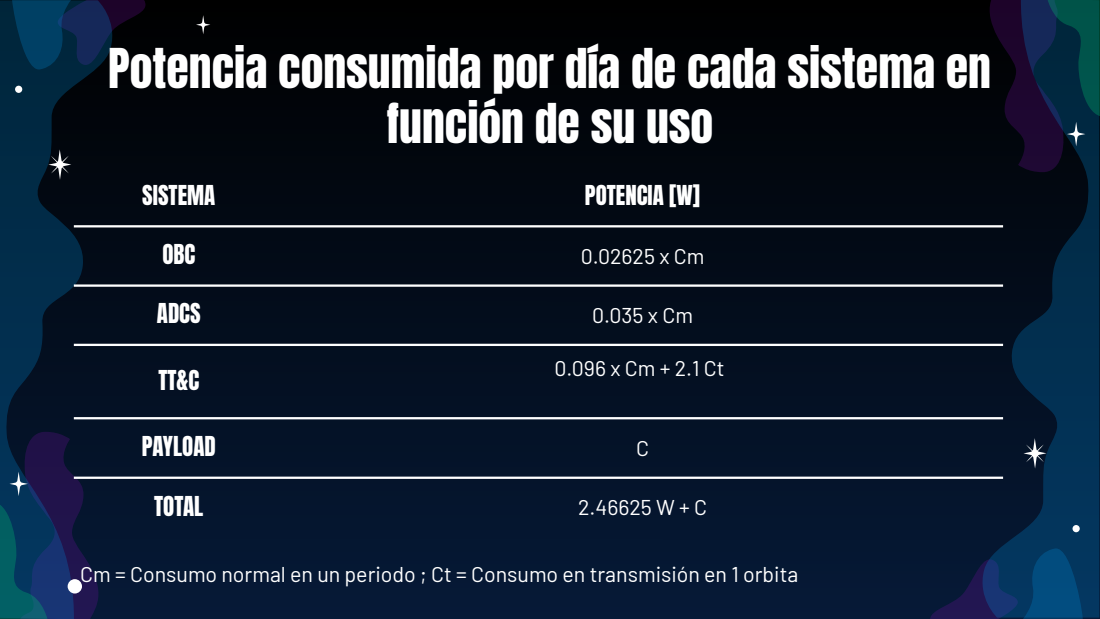
[picture p160: page 18]
SISTEMA; POTENCIA [W]; OBC; ADCS; PAYLOAD; TOTAL

Cm = Consumo normal en un periodo ; Ct = Consumo en transmisión en 1 orbita

# Potencia consumida por periodo

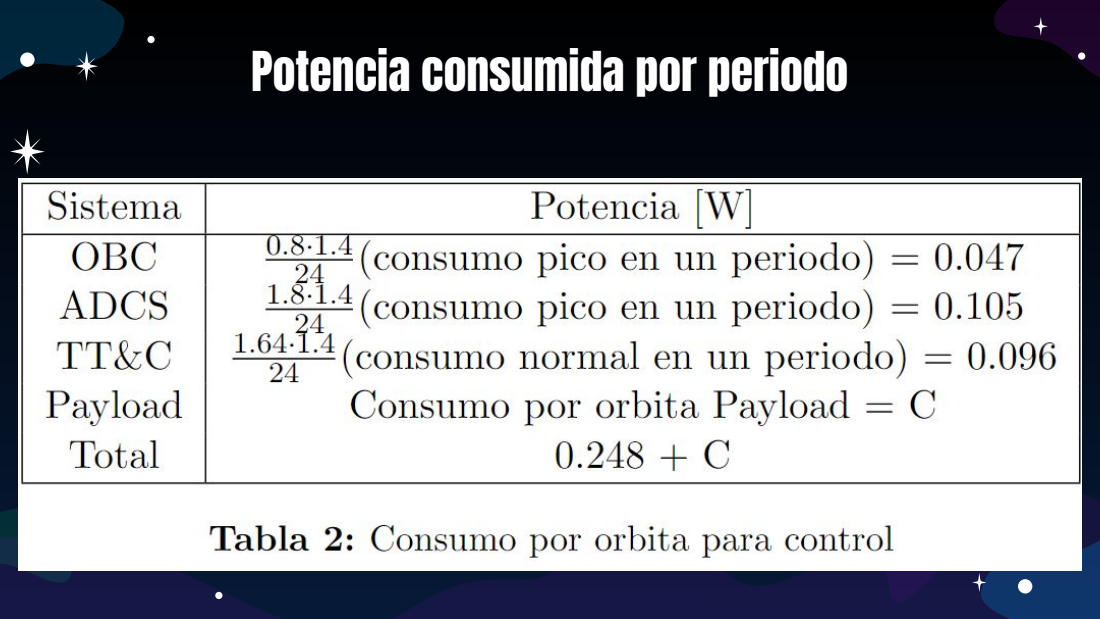
[picture p161: page 19]

# Potencia consumida por periodo

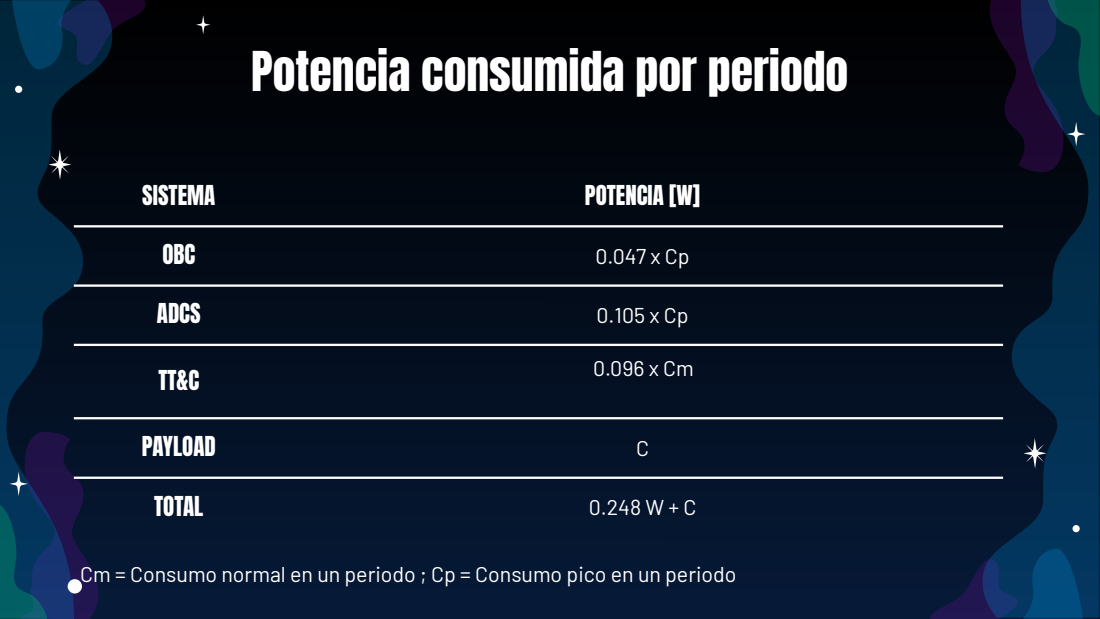
[picture p162: page 20]
SISTEMA; POTENCIA [W]; OBC; ADCS; PAYLOAD; TOTAL

Cm = Consumo normal en un periodo ; Cp = Consumo pico en un periodo

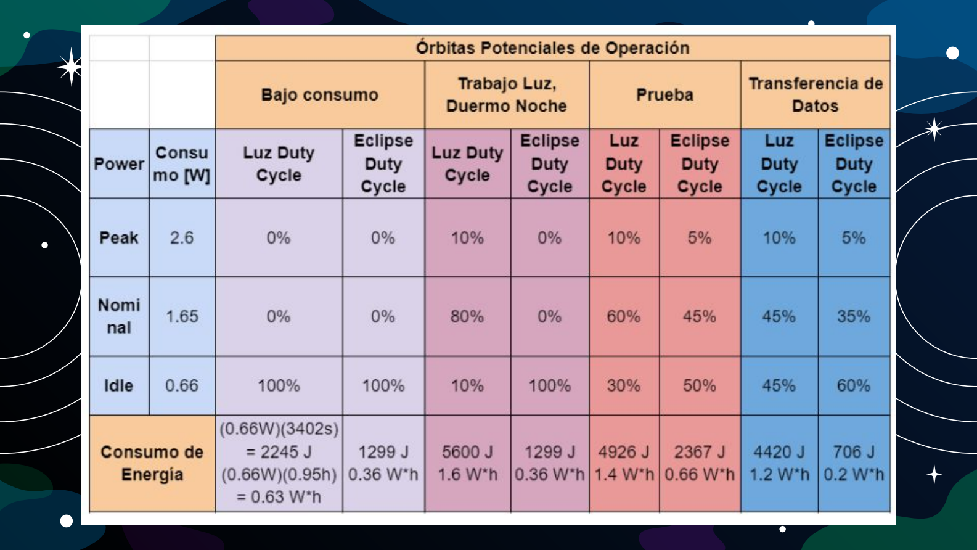
[picture p163: page 21]

# Peor ángulo de incidencia y mínima altura

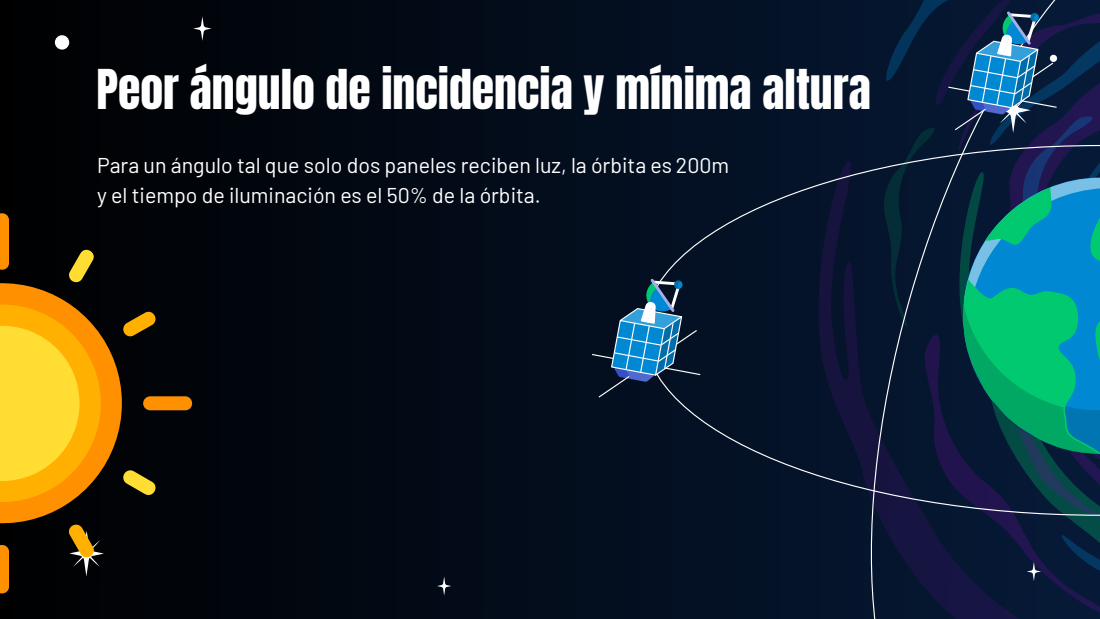
[picture p164: page 22]

Para un ángulo tal que solo dos paneles reciben luz, la órbita es 200m
y el tiempo de iluminación es el 50% de la órbita.

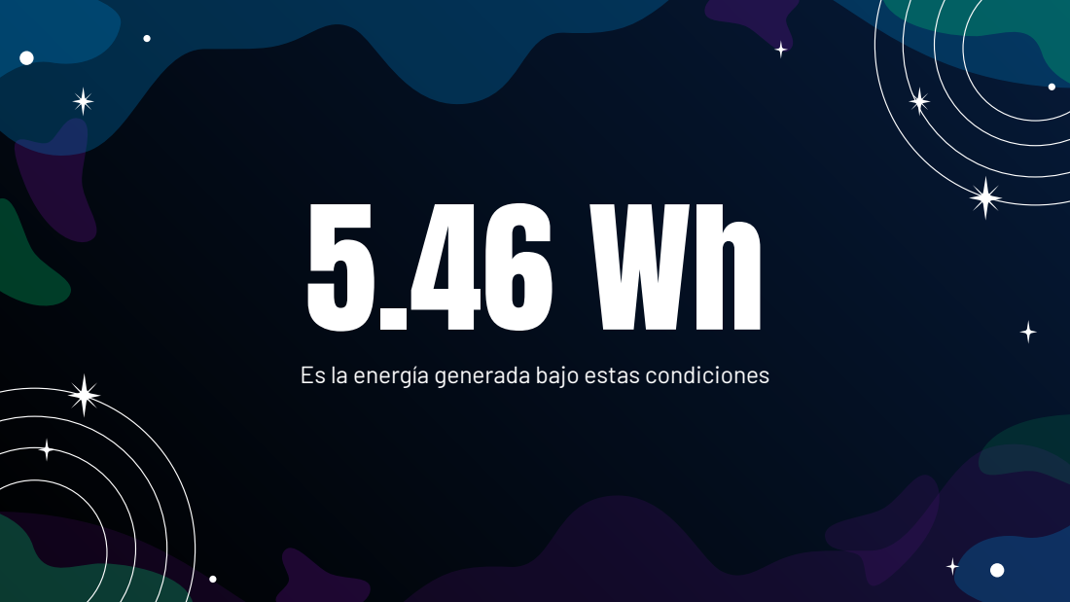
[picture p165: page 23]

Es la energía generada bajo estas condiciones

# Peor ángulo de incidencia y mínima altura

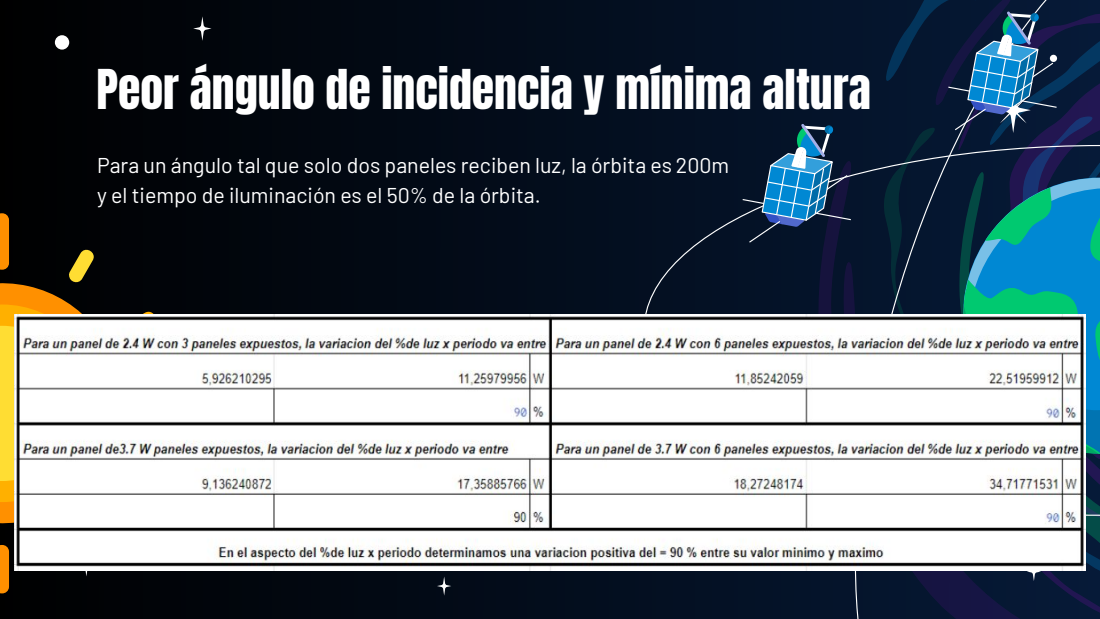
[picture p166: page 24]
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

# Tiempo de vida del sistema / satélite

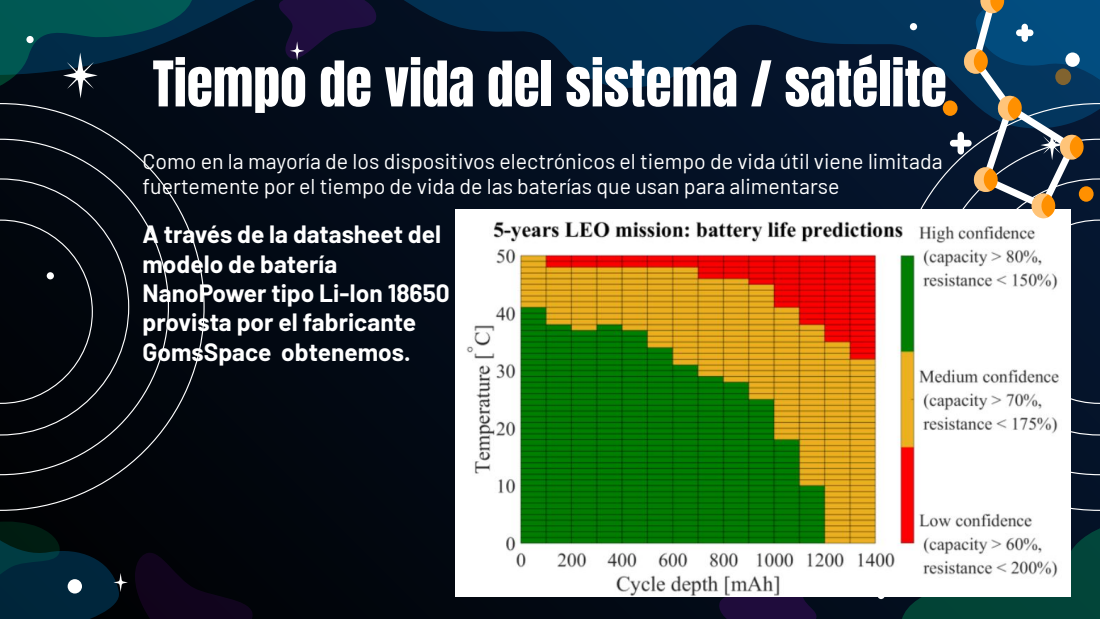
[picture p167: page 25]

Como en la mayoría de los dispositivos electrónicos el tiempo de vida útil viene limitada
fuertemente por el tiempo de vida de las baterías que usan para alimentarse
A través de la datasheet del
modelo de batería
NanoPower tipo Li-Ion 18650
provista por el fabricante
GomsSpace obtenemos.

# Tiempo de vida del sistema \ satélite

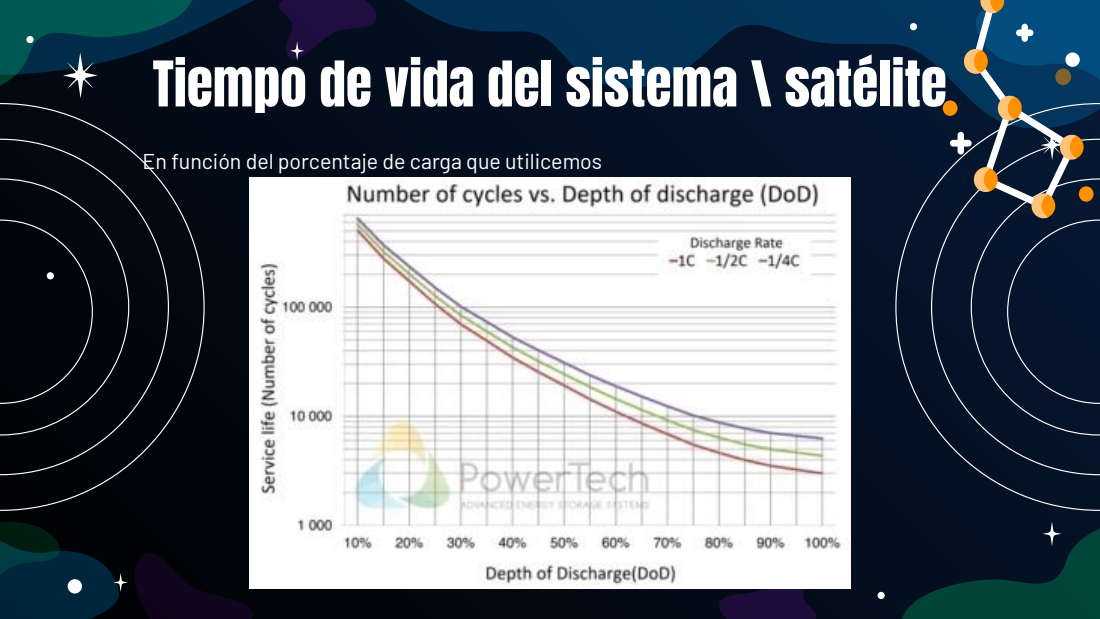
[picture p168: page 26]

En función del porcentaje de carga que utilicemos

# Gracias!

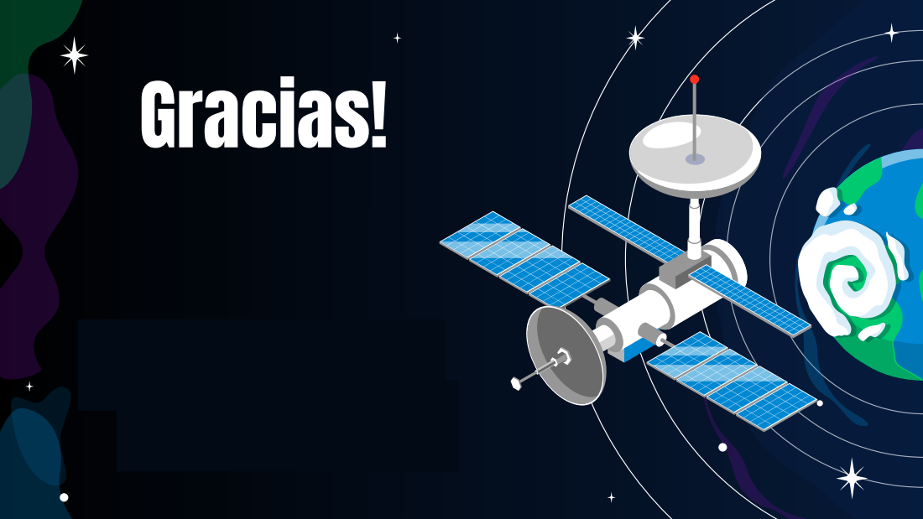
[picture p169: page 27]

CREDITS: This presentation template was created by
Slidesgo, (http://bit.ly/2Tynxth) including icons by Flaticon, (http://bit.ly/2TyoMsr) and infographics

& images by Freepik (http://bit.ly/2TtBDfr)

Please keep this slide for attribution

# SPACE FLAT ICON PACK

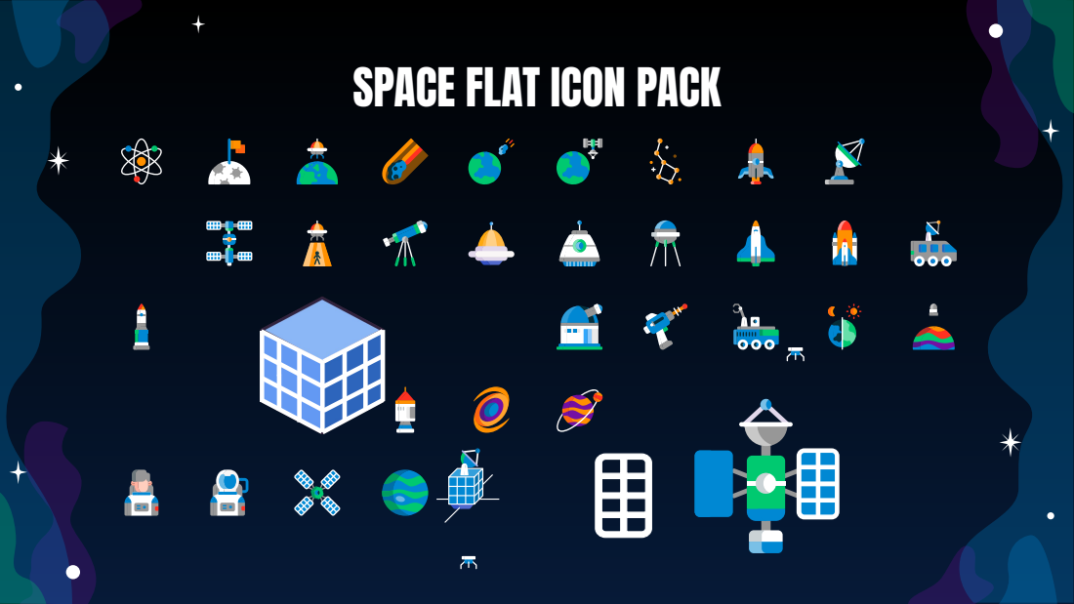
[picture p170: page 28]

04

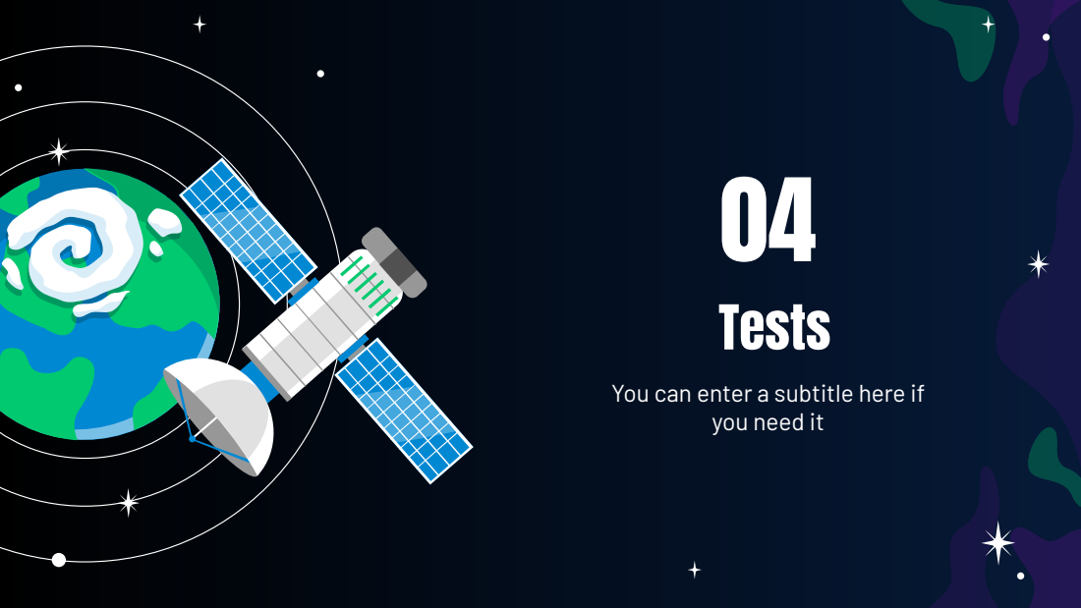
[picture p171: page 29]
Tests

You can enter a subtitle here if

you need it
