juan-LARRAYA/TPP/hardware/power sistem/superados/PowerSis-V1.0/TPP.pdf

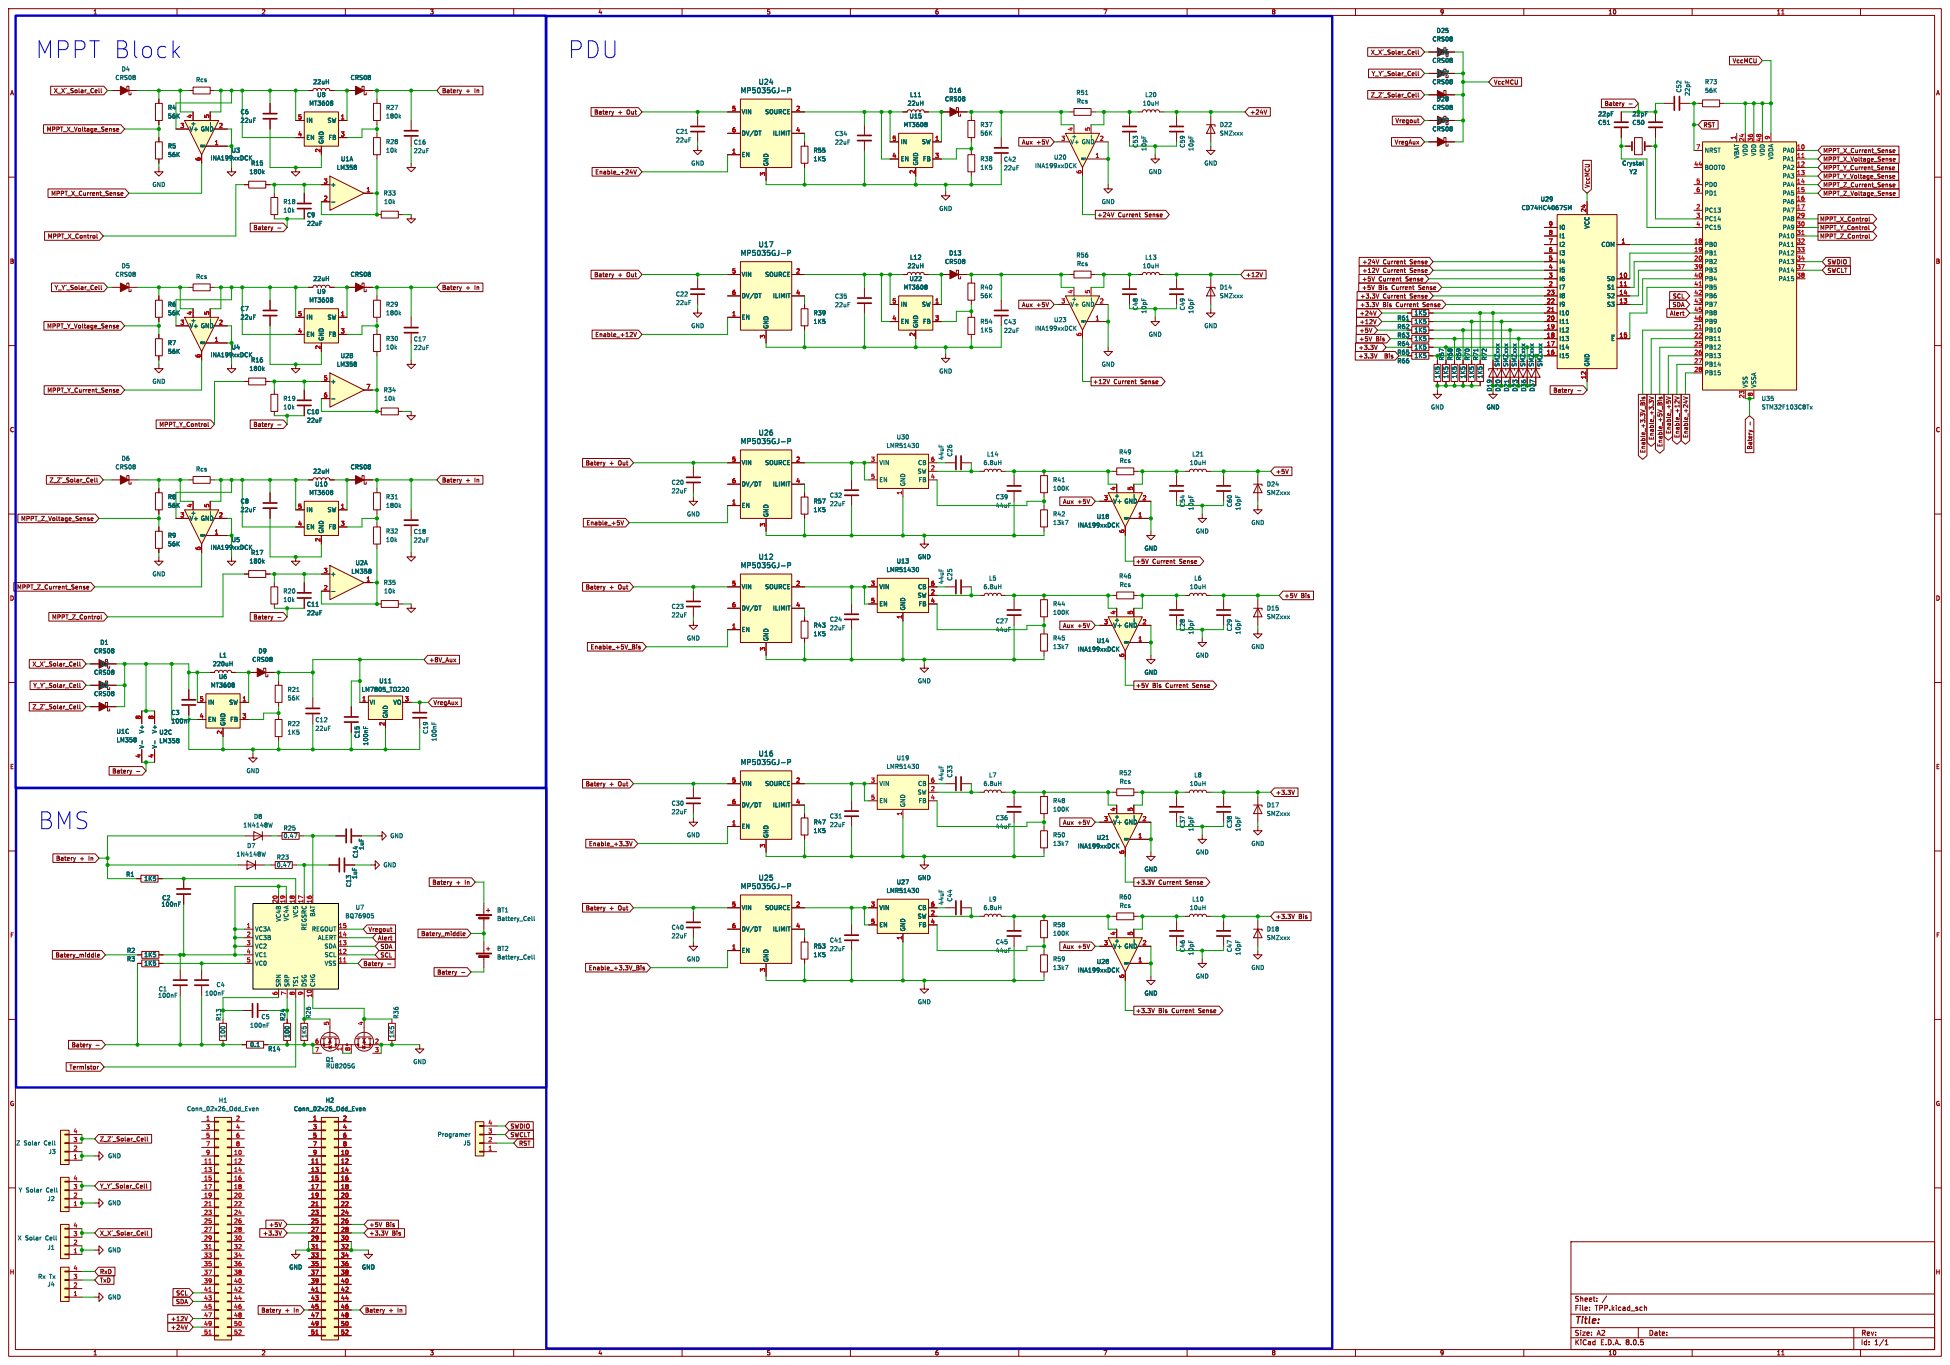
[picture p172: page 1]

ILIMIT 4 VIN 5 DV/DT 6 R15

1 SW 2 VIN 3 FB 4 EN 5 CB 6 U30
LMR51430

ILIMIT 4 VIN 5 DV/DT 6

1 SW 2 VIN 3 FB 4 EN 5 CB 6 U13
LMR51430 GND

1 SW 2 VIN 3 FB 4 EN 5 CB 6 R43

1 SW 2 VIN 3 FB 4 EN 5 CB 6 U19

1 SW 2 VIN 3 FB 4 EN 5 CB 6 GND

1 SW 2 VIN 3 FB 4 EN 5 CB 6 U27

8 CHG 10 VSS 11 SCL 12 SDA 13 DSG
