juan-LARRAYA/TPP/hardware/power sistem/superados/PowerSis-V1.1/TPP.kicad_pcb

## KiCad design hardware/power sistem/superados/PowerSis-V1.1/TPP.kicad_pcb (2024-11-17, an earlier design)

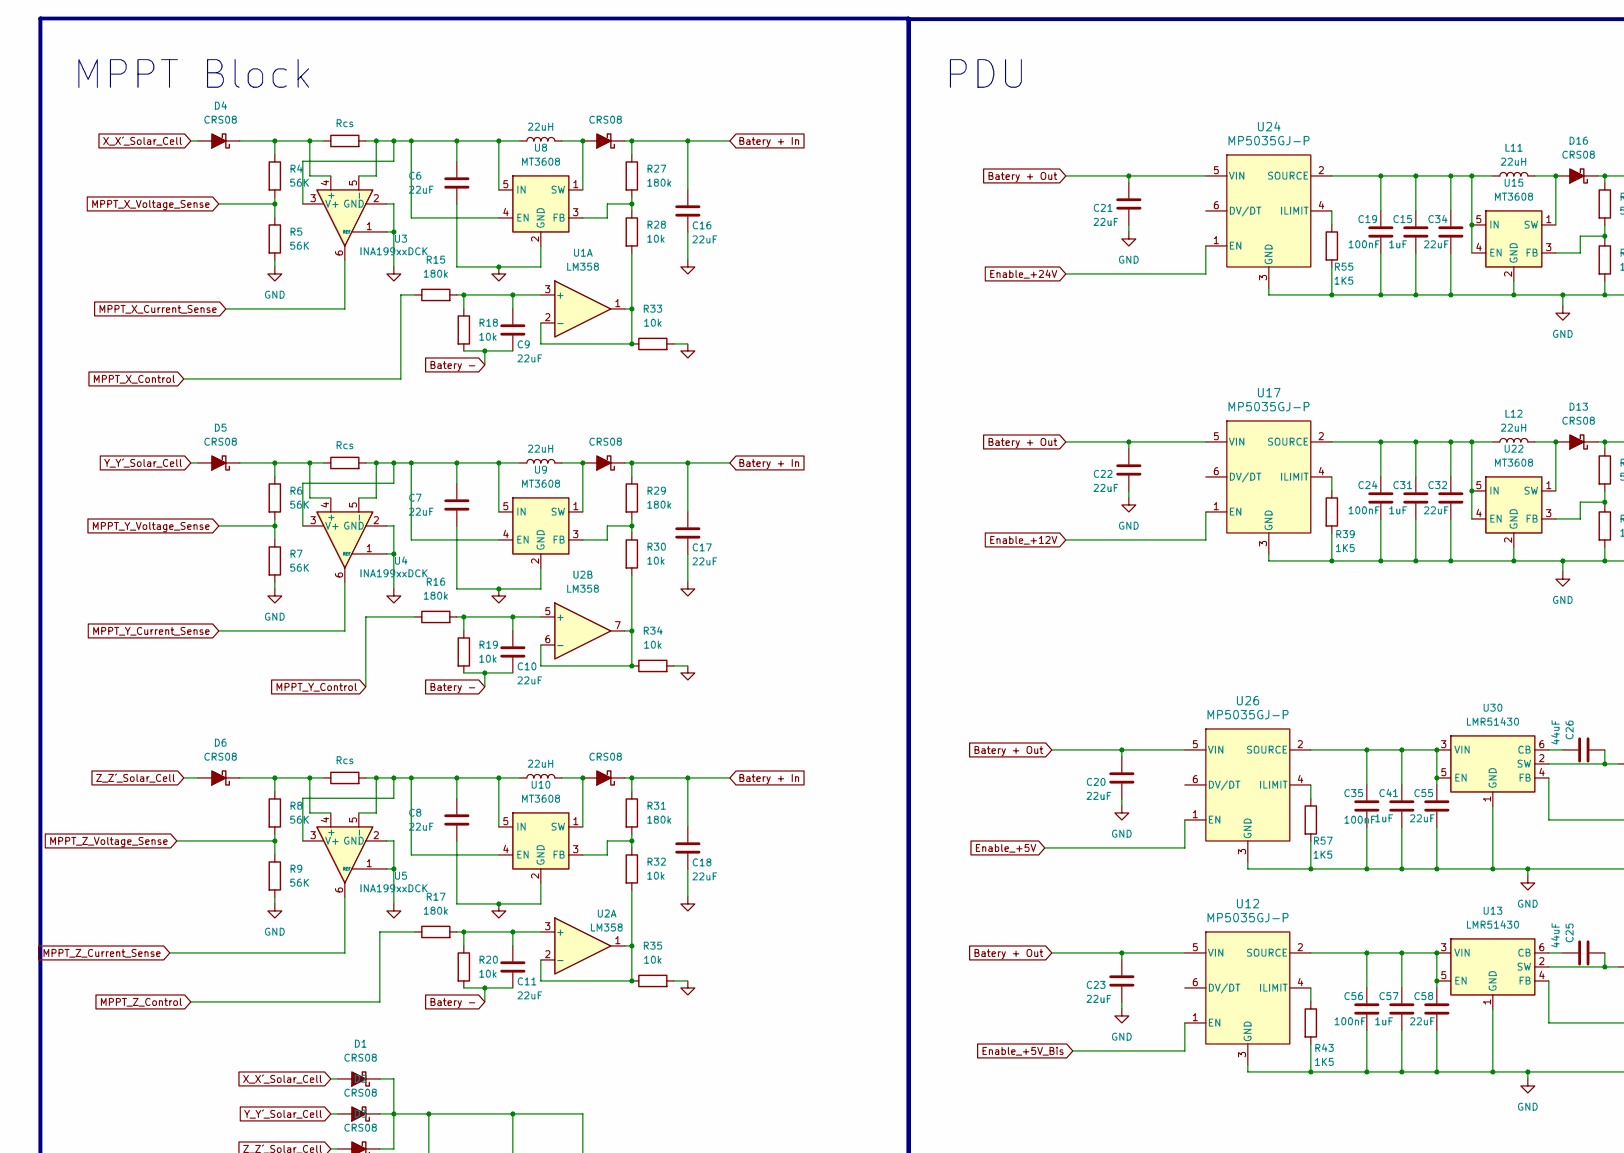
[picture p173: schematic TPP.kicad_sch, part in row 1, column 1]

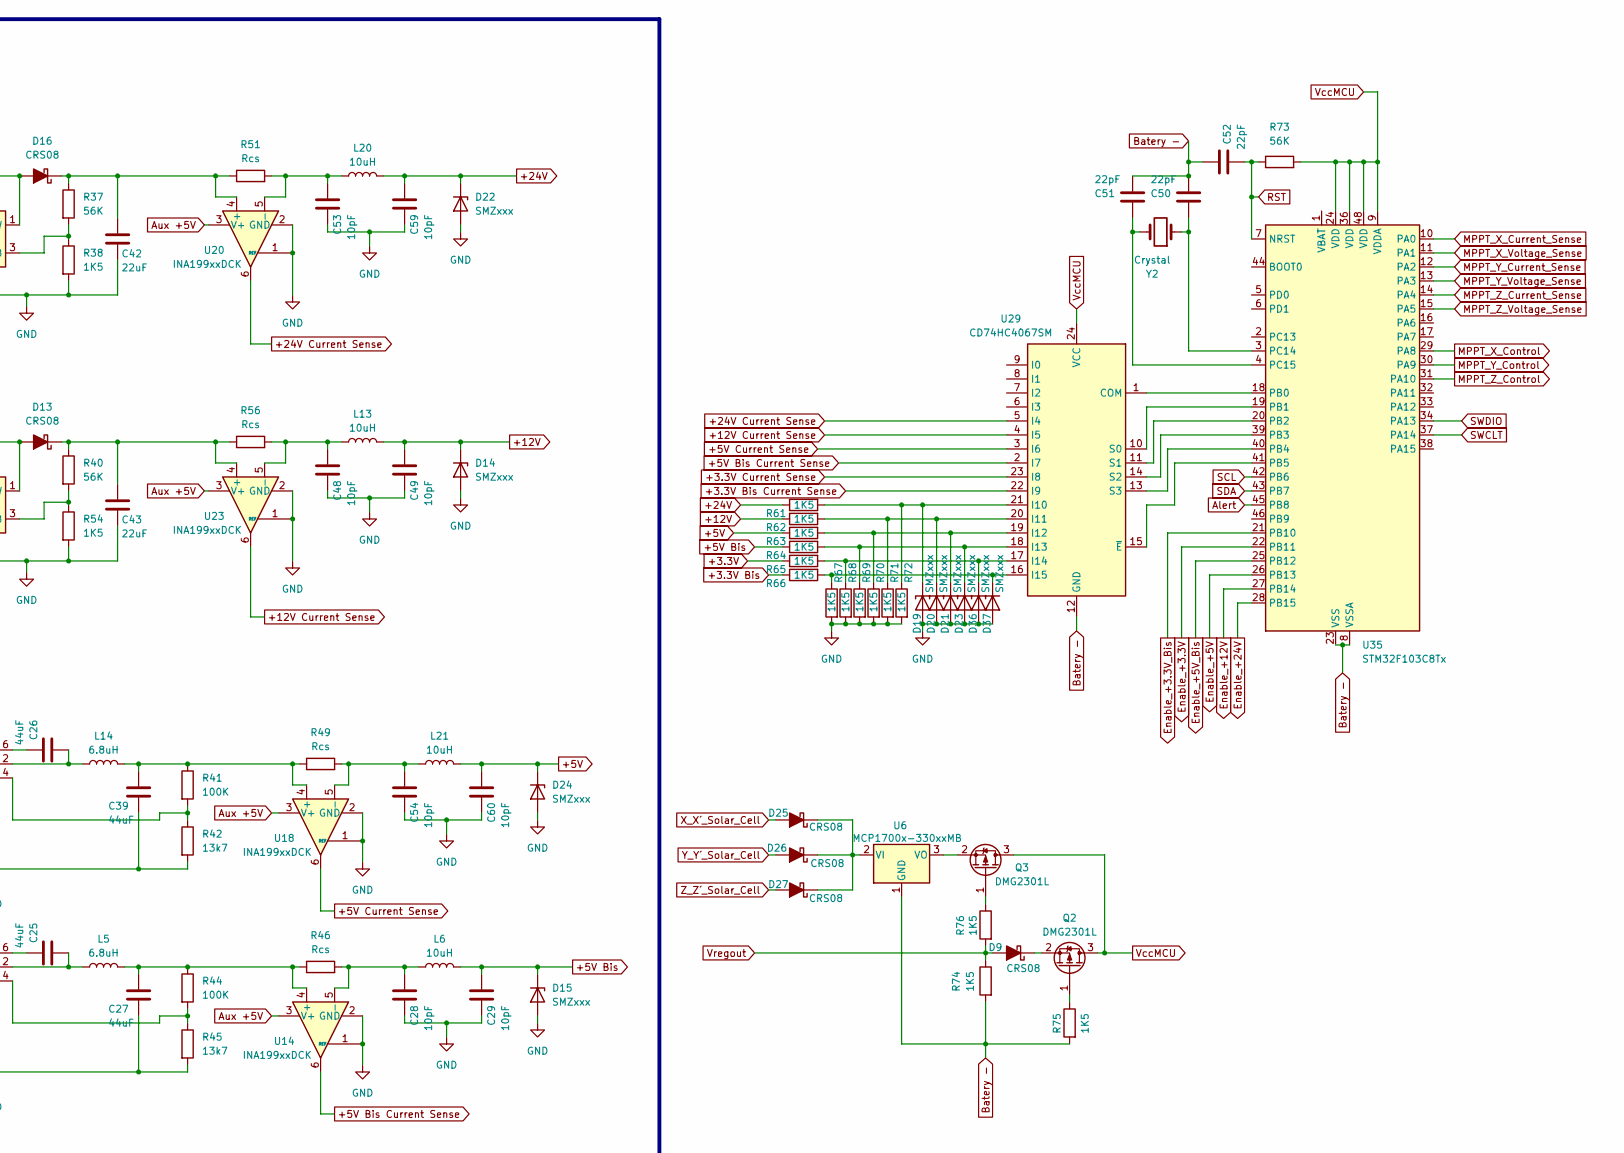
[picture p174: schematic TPP.kicad_sch, part in row 1, column 2]

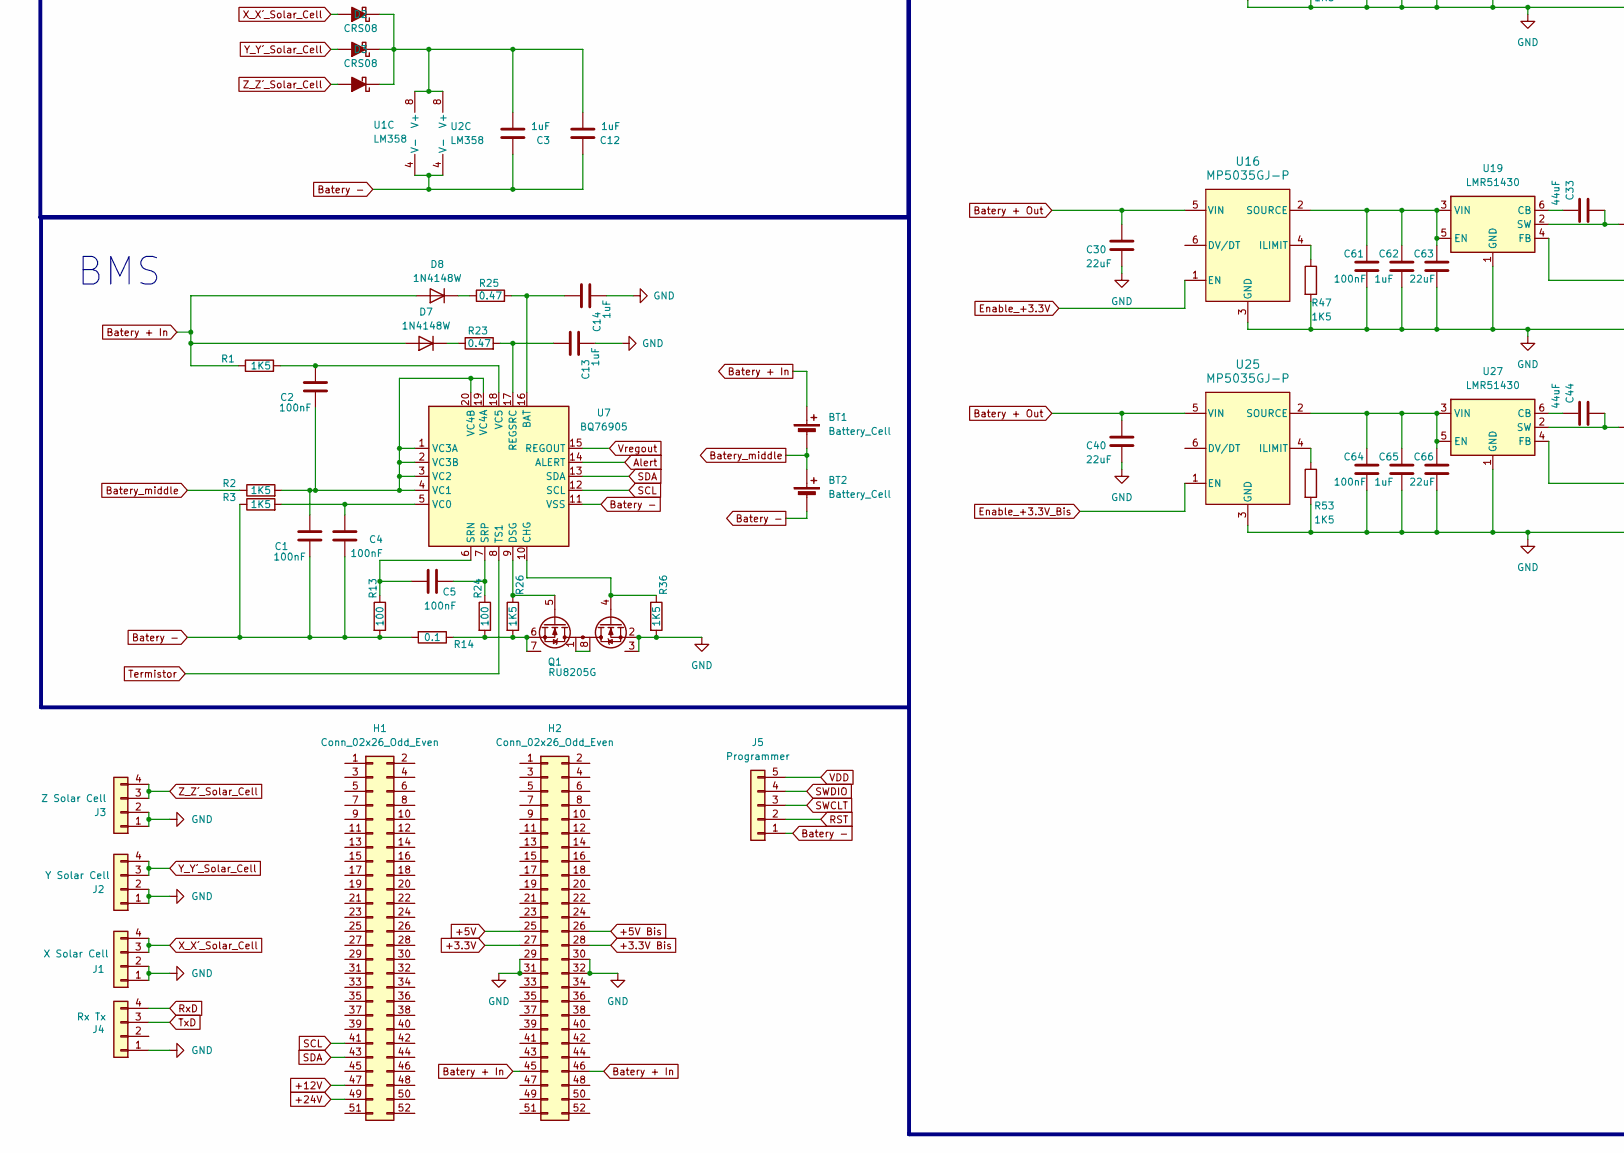
[picture p175: schematic TPP.kicad_sch, part in row 2, column 1]

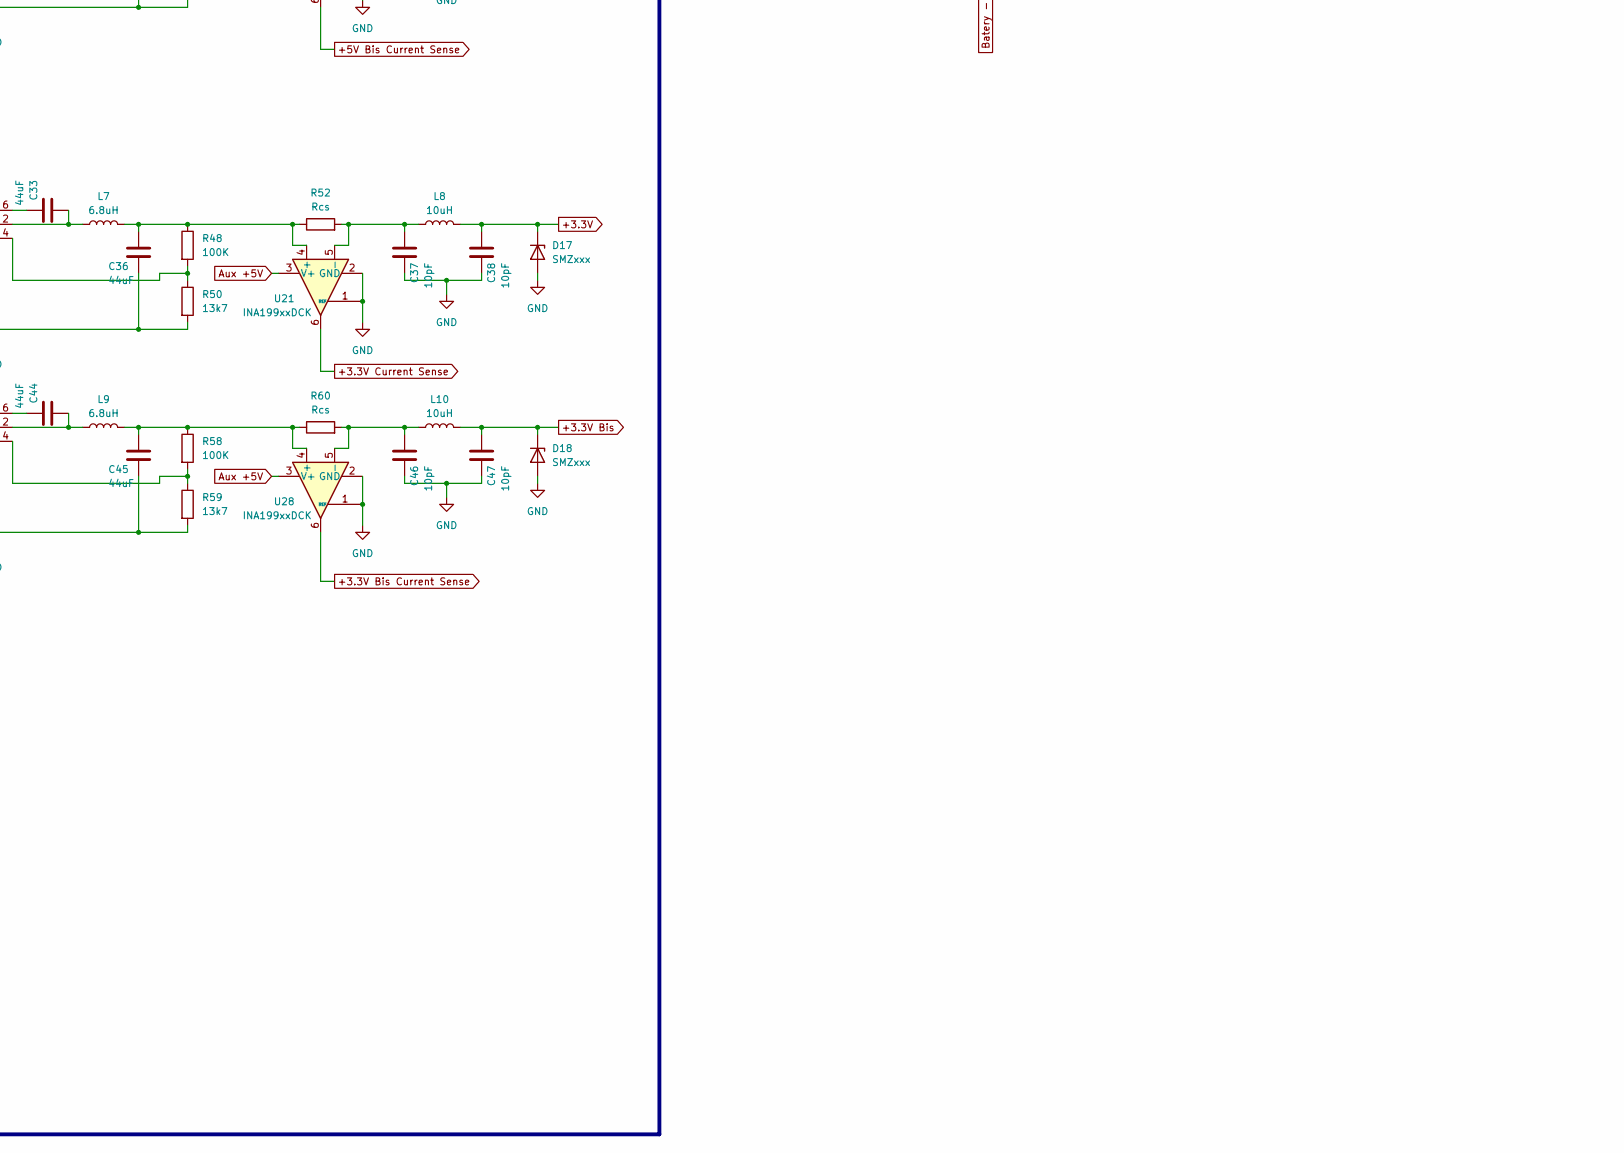
[picture p176: schematic TPP.kicad_sch, part in row 2, column 2]

Parts:
BT1, BT2: Battery_Cell; BatteryHolder_MPD_BH-18650-PC2
C1, C2, C4, C5, C19, C24, C35, C56, C61, C64: 100nF; C_0603_1608Metric_Pad1.08x0.95mm_HandSolder
C3, C12, C13, C14, C15, C31, C41, C57, C62, C65: 1uF; C_0603_1608Metric_Pad1.08x0.95mm_HandSolder
C6, C7, C8, C9, C10, C11, C16, C17, C18, C20, C21, C22, C23, C30, C32, C34, C40, C42, C43, C55, C58, C63, C66: 22uF; C_0603_1608Metric_Pad1.08x0.95mm_HandSolder
C25, C26, C27, C33, C36, C39, C44, C45: 44uF; C_0603_1608Metric_Pad1.08x0.95mm_HandSolder
C28, C29, C37, C38, C46, C47, C48, C49, C53, C54, C59, C60: 10pF; C_0603_1608Metric_Pad1.08x0.95mm_HandSolder
C50, C51, C52: 22pF; C_0603_1608Metric_Pad1.08x0.95mm_HandSolder
D1, D2, D3, D4, D5, D6, D9, D10, D11, D12, D13, D16, D25, D26, D27: CRS08; D_SMA
D7, D8: 1N4148W; D_SOD-123
D14, D15, D17, D18, D19, D20, D21, D22, D23, D24, D36, D37: SMZxxx; D_MELF
H1, H2: Conn_02x26_Odd_Even; PinSocket_2x26_P2.54mm_Vertical
J1: X Solar Cell; JST_XH_S4B-XH-A-1_1x04_P2.50mm_Horizontal
J2: Y Solar Cell; JST_XH_S4B-XH-A-1_1x04_P2.50mm_Horizontal
J3: Z Solar Cell; JST_XH_S4B-XH-A-1_1x04_P2.50mm_Horizontal
J4: Rx Tx; JST_XH_S4B-XH-A-1_1x04_P2.50mm_Horizontal
J5: Programmer; PinHeader_1x05_P2.54mm_Vertical
L2, L3, L4, L11, L12: 22uH; L_Abracon_ASPI-0630LR
L5, L7, L9, L14: 6.8uH; L_Abracon_ASPI-0630LR
L6, L8, L10, L13, L20, L21: 10uH; L_Abracon_ASPI-0630LR
Q1: RU8205G; TSSOP-8_4.4x3mm_P0.65mm
Q2, Q3: DMG2301L; SOT-23
R1, R2, R3, R26, R36, R38, R39, R43, R47, R53, R54, R55, R57, R61, R62, R63, R64, R65, R66, R67, R68, R69, R70, R71, R72, R74, R75, R76: 1K5; R_0805_2012Metric_Pad1.20x1.40mm_HandSolder
R4, R5, R6, R7, R8, R9, R37, R40, R73: 56K; R_0805_2012Metric_Pad1.20x1.40mm_HandSolder
R10, R11, R12, R46, R49, R51, R52, R56, R60: Rcs; R_0805_2012Metric_Pad1.20x1.40mm_HandSolder
R13, R24: 100; R_0805_2012Metric_Pad1.20x1.40mm_HandSolder
R14: 0.1; R_0805_2012Metric_Pad1.20x1.40mm_HandSolder
R15, R16, R17, R27, R29, R31: 180k; R_0805_2012Metric_Pad1.20x1.40mm_HandSolder
R18, R19, R20, R28, R30, R32, R33, R34, R35: 10k; R_0805_2012Metric_Pad1.20x1.40mm_HandSolder
R23, R25: 0.47; R_0805_2012Metric_Pad1.20x1.40mm_HandSolder
R41, R44, R48, R58: 100K; R_0805_2012Metric_Pad1.20x1.40mm_HandSolder
R42, R45, R50, R59: 13k7; R_0805_2012Metric_Pad1.20x1.40mm_HandSolder
U1: LM358; SOIC-8_3.9x4.9mm_P1.27mm
U2: LM358
U3, U4, U5, U14, U18, U20, U21, U23, U28: INA199xxDCK; SOT-363_SC-70-6
U6: MCP1700x-330xxMB; SOT-89-3
U7: BQ76905; QFN-20-1EP_3x3mm_P0.4mm_EP1.65x1.65mm_ThermalVias
U8, U9, U10, U15, U22: MT3608; SOT-23-6
U12, U16, U17, U24, U25, U26: MP5035GJ-P; TSOT-23-6_HandSoldering
U13, U19, U27, U30: LMR51430; SOT-23-6
U29: CD74HC4067SM; SSOP-24_5.3x8.2mm_P0.65mm
U35: STM32F103C8Tx; LQFP-48_7x7mm_P0.5mm
Y2: Crystal; Crystal_HC49-U_Vertical

Connections:
+3.3V: C38.2, D17.1 (K), H2.27, L8.2
+3.3V: R65.1
+3.3V Bis: R66.1
+3.3V Bis: C47.2, D18.1 (K), H2.28, L10.2
+3.3V Bis Current Sense: U28.6, U29.22 (I9)
+3.3V Current Sense: U21.6, U29.23 (I8)
+5V: C60.2, D24.1 (K), H2.25, L21.2, R63.1
+5V Bis: C29.2, D15.1 (K), H2.26, L6.2, R64.1
+5V Bis Current Sense: U14.6, U29.2 (I7)
+5V Current Sense: U18.6, U29.3 (I6)
+12V: C49.2, D14.1 (K), H1.47, L13.2, R62.1
+12V Current Sense: U23.6, U29.4 (I5)
+24V: C59.2, D22.1 (K), H1.49, L20.2, R61.1
+24V Current Sense: U20.6, U29.5 (I4)
Alert: U7.14 (ALERT), U35.45 (PB8)
Aux +5V: U14.3 (V+), U18.3 (V+), U20.3 (V+), U21.3 (V+), U23.3 (V+), U28.3 (V+)
Batery + In: BT1.1 (+), C16.1, C17.1, C18.1, D7.2 (A), D8.2 (A), D10.1 (K), D11.1 (K), D12.1 (K), H2.45, H2.46, R1.1, R27.1, R29.1, R31.1
Batery + Out: C20.1, C21.1, C22.1, C23.1, C30.1, C40.1, U12.5 (VIN), U16.5 (VIN), U17.5 (VIN), U24.5 (VIN), U25.5 (VIN), U26.5 (VIN)
Batery -: BT2.2 (-), C1.1, C3.1, C4.1, C9.2, C10.2, C11.2, C12.1, C50.1, C51.1, C52.2, J5.1, R3.1, R13.2, R14.2, R18.2, R19.2, R20.2, R74.2, R75.2, U1.4 (V-), U2.4 (V-), U6.1 (GND), U7.11 (VSS), U29.12 (GND), U35.8 (VSSA), U35.23 (VSS), U35.35 (VSS), U35.47 (VSS)
Batery_middle: BT1.2 (-), BT2.1 (+), R2.1
Enable_+3.3V: U16.1 (EN), U35.22 (PB11)
Enable_+3.3V_Bis: U25.1 (EN), U35.21 (PB10)
Enable_+5V: U26.1 (EN), U35.26 (PB13)
Enable_+5V_Bis: U12.1 (EN), U35.25 (PB12)
Enable_+12V: U17.1 (EN), U35.27 (PB14)
Enable_+24V: U24.1 (EN), U35.28 (PB15)
GND: C6.2, C7.2, C8.2, C13.1, C14.1, C15.2, C16.2, C17.2, C18.2, C19.2, C20.2, C21.2, C22.2, C23.2, C24.2, C27.2, C28.1, C29.1, C30.2, C31.2, C32.2, C34.2, C35.2, C36.2, C37.1, C38.1, C39.2, C40.2, C41.2, C42.2, C43.2, C45.2, C46.1, C47.1, C48.1, C49.1, C53.1, C54.1, C55.2, C56.2, C57.2, C58.2, C59.1, C60.1, C61.2, C62.2, C63.2, C64.2, C65.2, C66.2, D14.2 (A), D15.2 (A), D17.2 (A), D18.2 (A), D19.2 (A), D20.2 (A), D21.2 (A), D22.2 (A), D23.2 (A), D24.2 (A), D36.2 (A), D37.2 (A), H2.29, H2.30, H2.31, H2.32, J1.1, J1.2, J2.1, J2.2, J3.1, J3.2, J4.1, Q1.2 (D1), Q1.3 (D1), R5.2, R7.2, R9.2, R33.2, R34.2, R35.2, R36.2, R38.2, R39.2, R42.2, R43.2, R45.2, R47.2, R50.2, R53.2, R54.2, R55.2, R57.2, R59.2, R67.2, R68.2, R69.2, R70.2, R71.2, R72.2, U3.1 (REF), U3.2 (GND), U4.1 (REF), U4.2 (GND), U5.1 (REF), U5.2 (GND), U8.2 (GND), U9.2 (GND), U10.2 (GND), U12.3 (GND), U13.1 (GND), U14.1 (REF), U14.2 (GND), U15.2 (GND), U16.3 (GND), U17.3 (GND), U18.1 (REF), U18.2 (GND), U19.1 (GND), U20.1 (REF), U20.2 (GND), U21.1 (REF), U21.2 (GND), U22.2 (GND), U23.1 (REF), U23.2 (GND), U24.3 (GND), U25.3 (GND), U26.3 (GND), U27.1 (GND), U28.1 (REF), U28.2 (GND), U30.1 (GND)
MPPT_X_Control: R15.1, U35.29 (PA8)
MPPT_X_Current_Sense: U3.6, U35.10 (PA0)
MPPT_X_Voltage_Sense: R4.2, R5.1, U35.11 (PA1)
MPPT_Y_Control: R16.1, U35.30 (PA9)
MPPT_Y_Current_Sense: U4.6, U35.12 (PA2)
MPPT_Y_Voltage_Sense: R6.2, R7.1, U35.13 (PA3)
MPPT_Z_Control: R17.1, U35.31 (PA10)
MPPT_Z_Current_Sense: U5.6, U35.14 (PA4)
MPPT_Z_Voltage_Sense: R8.2, R9.1, U35.15 (PA5)
unnamed: C3.2, C12.2, D1.1 (K), D2.1 (K), D3.1 (K), U1.8 (V+), U2.8 (V+)
unnamed: D4.1 (K), R4.1, R10.1, U3.4 (+)
unnamed: D5.1 (K), R6.1, R11.1, U4.4 (+)
unnamed: D6.1 (K), R8.1, R12.1, U5.4 (+)
unnamed: D7.1 (K), R23.1
unnamed: D8.1 (K), R25.1
unnamed: D9.1 (K), Q2.2 (S)
unnamed: D10.2 (A), L2.2, U8.1 (SW)
unnamed: D11.2 (A), L3.2, U9.1 (SW)
unnamed: D12.2 (A), L4.2, U10.1 (SW)
unnamed: D13.2 (A), L12.2, U22.1 (SW)
unnamed: C43.1, D13.1 (K), R40.1, R56.1, U23.4 (+)
unnamed: D16.2 (A), L11.2, U15.1 (SW)
unnamed: C42.1, D16.1 (K), R37.1, R51.1, U20.4 (+)
unnamed: D19.1 (K), R61.2, R72.1, U29.21 (I10)
unnamed: D20.1 (K), R62.2, R71.1, U29.20 (I11)
unnamed: D21.1 (K), R63.2, R70.1, U29.19 (I12)
unnamed: D23.1 (K), R64.2, R69.1, U29.18 (I13)
unnamed: D25.1 (K), D26.1 (K), D27.1 (K), U6.2 (VI)
unnamed: D36.1 (K), R65.2, R68.1, U29.17 (I14)
unnamed: D37.1 (K), R66.2, R67.1, U29.16 (I15)
unnamed: Q1.4 (G1), R36.1, U7.10 (CHG)
unnamed: Q1.5 (G2), R26.1, U7.9 (DSG)
unnamed: Q1.1 (S1/D2), Q1.8 (S1/D2)
unnamed: Q1.6 (S2), Q1.7 (S2), R14.1, R24.2, R26.2
unnamed: Q2.1 (G), R75.1
unnamed: Q3.1 (G), R76.1
unnamed: Q3.2 (S), U6.3 (VO)
unnamed: C9.1, R15.2, R18.1, U1.3 (+)
unnamed: R28.2, R33.1, U1.1, U1.2 (-)
unnamed: C11.1, R17.2, R20.1, U2.3 (+)
unnamed: R32.2, R35.1, U2.1, U2.2 (-)
unnamed: C10.1, R16.2, R19.1, U2.5 (+)
unnamed: R30.2, R34.1, U2.6 (-), U2.7
unnamed: C6.1, L2.1, R10.2, U3.3 (V+), U3.5 (-), U8.4 (EN), U8.5 (IN)
unnamed: C7.1, L3.1, R11.2, U4.3 (V+), U4.5 (-), U9.4 (EN), U9.5 (IN)
unnamed: C14.2, R25.2, U7.16 (BAT)
unnamed: C13.2, R23.2, U7.17 (REGSRC)
unnamed: C5.1, R13.1, U7.6 (SRN)
unnamed: C5.2, R24.1, U7.7 (SRP)
unnamed: C4.2, R3.2, U7.5 (VC0)
unnamed: C1.2, C2.1, R2.2, U7.1 (VC3A), U7.2 (VC3B), U7.3 (VC2), U7.4 (VC1), U7.19 (VC4A), U7.20 (VC4B)
unnamed: C2.2, R1.2, U7.18 (VC5)
unnamed: R27.2, R28.1, U8.3 (FB)
unnamed: R29.2, R30.1, U9.3 (FB)
unnamed: C8.1, L4.1, R12.2, U5.3 (V+), U5.5 (-), U10.4 (EN), U10.5 (IN)
unnamed: R31.2, R32.1, U10.3 (FB)
unnamed: R43.1, U12.4 (ILIMIT)
unnamed: C56.1, C57.1, C58.1, U12.2 (SOURCE), U13.3 (VIN), U13.5 (EN)
unnamed: C25.2, U13.6 (CB)
unnamed: R44.2, R45.1, U13.4 (FB)
unnamed: C25.1, L5.1, U13.2 (SW)
unnamed: C27.1, L5.2, R44.1, R46.1, U14.4 (+)
unnamed: C28.2, L6.1, R46.2, U14.5 (-)
unnamed: C15.1, C19.1, C34.1, L11.1, U15.4 (EN), U15.5 (IN), U24.2 (SOURCE)
unnamed: R37.2, R38.1, U15.3 (FB)
unnamed: R47.1, U16.4 (ILIMIT)
unnamed: C61.1, C62.1, C63.1, U16.2 (SOURCE), U19.3 (VIN), U19.5 (EN)
unnamed: R39.1, U17.4 (ILIMIT)
unnamed: C24.1, C31.1, C32.1, L12.1, U17.2 (SOURCE), U22.4 (EN), U22.5 (IN)
unnamed: C39.1, L14.2, R41.1, R49.1, U18.4 (+)
unnamed: C54.2, L21.1, R49.2, U18.5 (-)
unnamed: C33.2, U19.6 (CB)
unnamed: R48.2, R50.1, U19.4 (FB)
unnamed: C33.1, L7.1, U19.2 (SW)
unnamed: C53.2, L20.1, R51.2, U20.5 (-)
unnamed: C36.1, L7.2, R48.1, R52.1, U21.4 (+)
unnamed: C37.2, L8.1, R52.2, U21.5 (-)
unnamed: R40.2, R54.1, U22.3 (FB)
unnamed: C48.2, L13.1, R56.2, U23.5 (-)
unnamed: R55.1, U24.4 (ILIMIT)
unnamed: R53.1, U25.4 (ILIMIT)
unnamed: C64.1, C65.1, C66.1, U25.2 (SOURCE), U27.3 (VIN), U27.5 (EN)
unnamed: R57.1, U26.4 (ILIMIT)
unnamed: C35.1, C41.1, C55.1, U26.2 (SOURCE), U30.3 (VIN), U30.5 (EN)
unnamed: C44.2, U27.6 (CB)
unnamed: R58.2, R59.1, U27.4 (FB)
unnamed: C44.1, L9.1, U27.2 (SW)
unnamed: C45.1, L9.2, R58.1, R60.1, U28.4 (+)
unnamed: C46.2, L10.1, R60.2, U28.5 (-)
unnamed: U29.1 (COM), U35.18 (PB0)
unnamed: U29.10 (S0), U35.19 (PB1)
unnamed: U29.11 (S1), U35.20 (PB2)
unnamed: U29.14 (S2), U35.39 (PB3)
unnamed: U29.13 (S3), U35.40 (PB4)
unnamed: U29.15 (~E), U35.41 (PB5)
unnamed: C26.2, U30.6 (CB)
unnamed: R41.2, R42.1, U30.4 (FB)
unnamed: C26.1, L14.1, U30.2 (SW)
unnamed: C50.2, U35.3 (PC14), Y2.1
unnamed: C51.2, U35.4 (PC15), Y2.2
RST: C52.1, J5.2, R73.1, U35.7 (NRST)
RxD: J4.4
SCL: H1.41, U7.12 (SCL), U35.42 (PB6)
SDA: H1.43, U7.13 (SDA), U35.43 (PB7)
SWCLT: J5.3, U35.37 (PA14)
SWDIO: J5.4, U35.34 (PA13)
Termistor: U7.8 (TS1)
TxD: J4.3
VDD: J5.5
VccMCU: Q2.3 (D), Q3.3 (D), R73.2, U29.24 (VCC), U35.9 (VDDA), U35.24 (VDD), U35.36 (VDD), U35.48 (VDD)
Vregout: D9.2 (A), R74.1, R76.2, U7.15 (REGOUT)
X_X´_Solar_Cell: D1.2 (A), D4.2 (A), D25.2 (A), J1.3, J1.4
Y_Y´_Solar_Cell: D2.2 (A), D5.2 (A), D26.2 (A), J2.3, J2.4
Z_Z´_Solar_Cell: D3.2 (A), D6.2 (A), D27.2 (A), J3.3, J3.4

Notes on the sheet:
BMS
PDU
MPPT Block

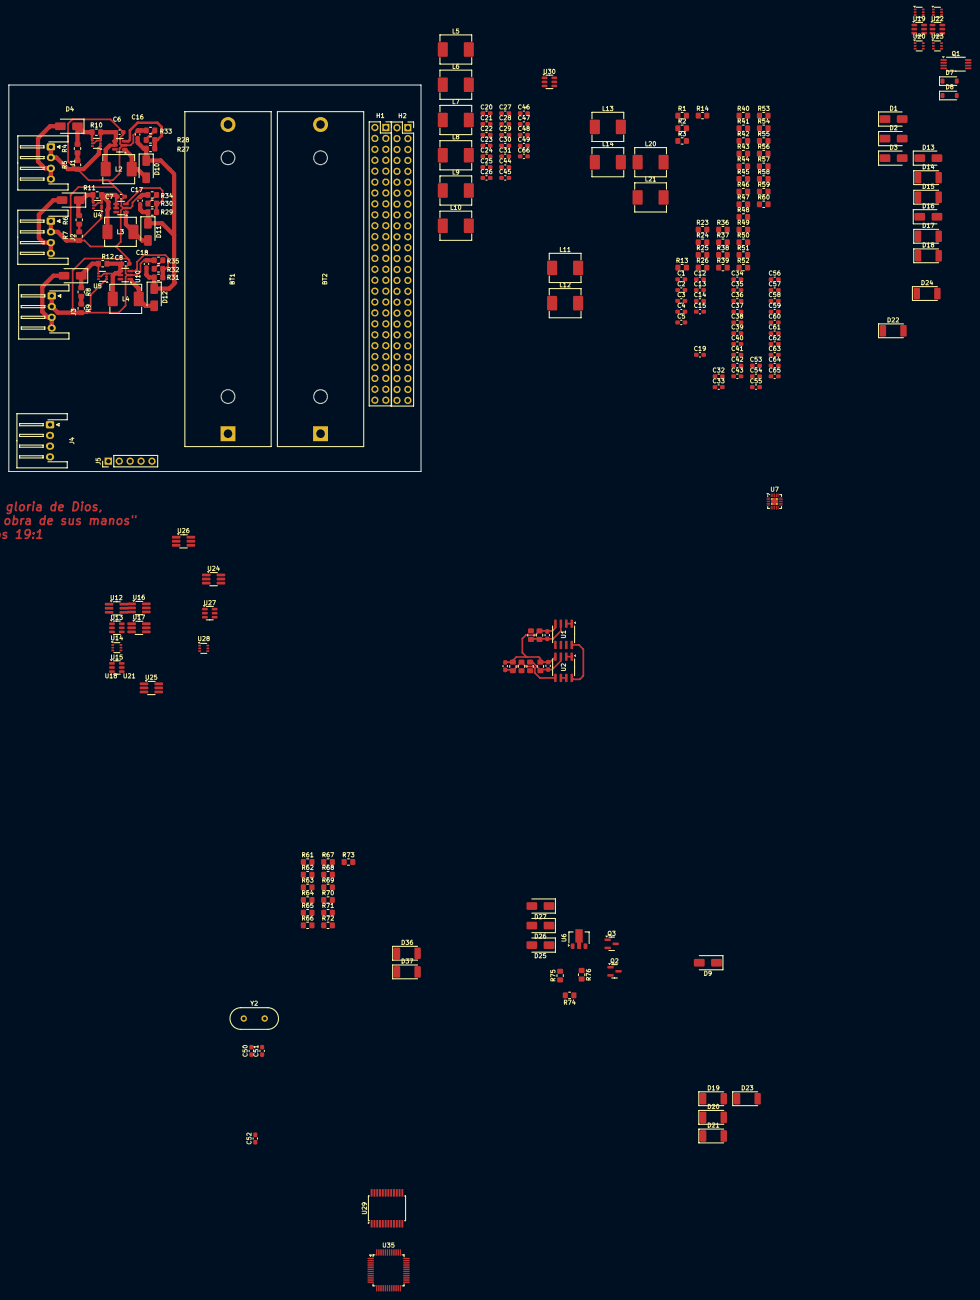
[picture p177: board hardware/power sistem/superados/PowerSis-V1.1/TPP.kicad_pcb from above]

Board: 2 copper layers, 96.0 x 90.0 mm, 227 parts (0 on the bottom side), 135 nets.
