juan-LARRAYA/TPP/hardware/power sistem/superados/PowerSis-V0.0/TPP.kicad_pcb

## KiCad design hardware/power sistem/superados/PowerSis-V0.0/TPP.kicad_pcb (2024-11-17, an earlier design)

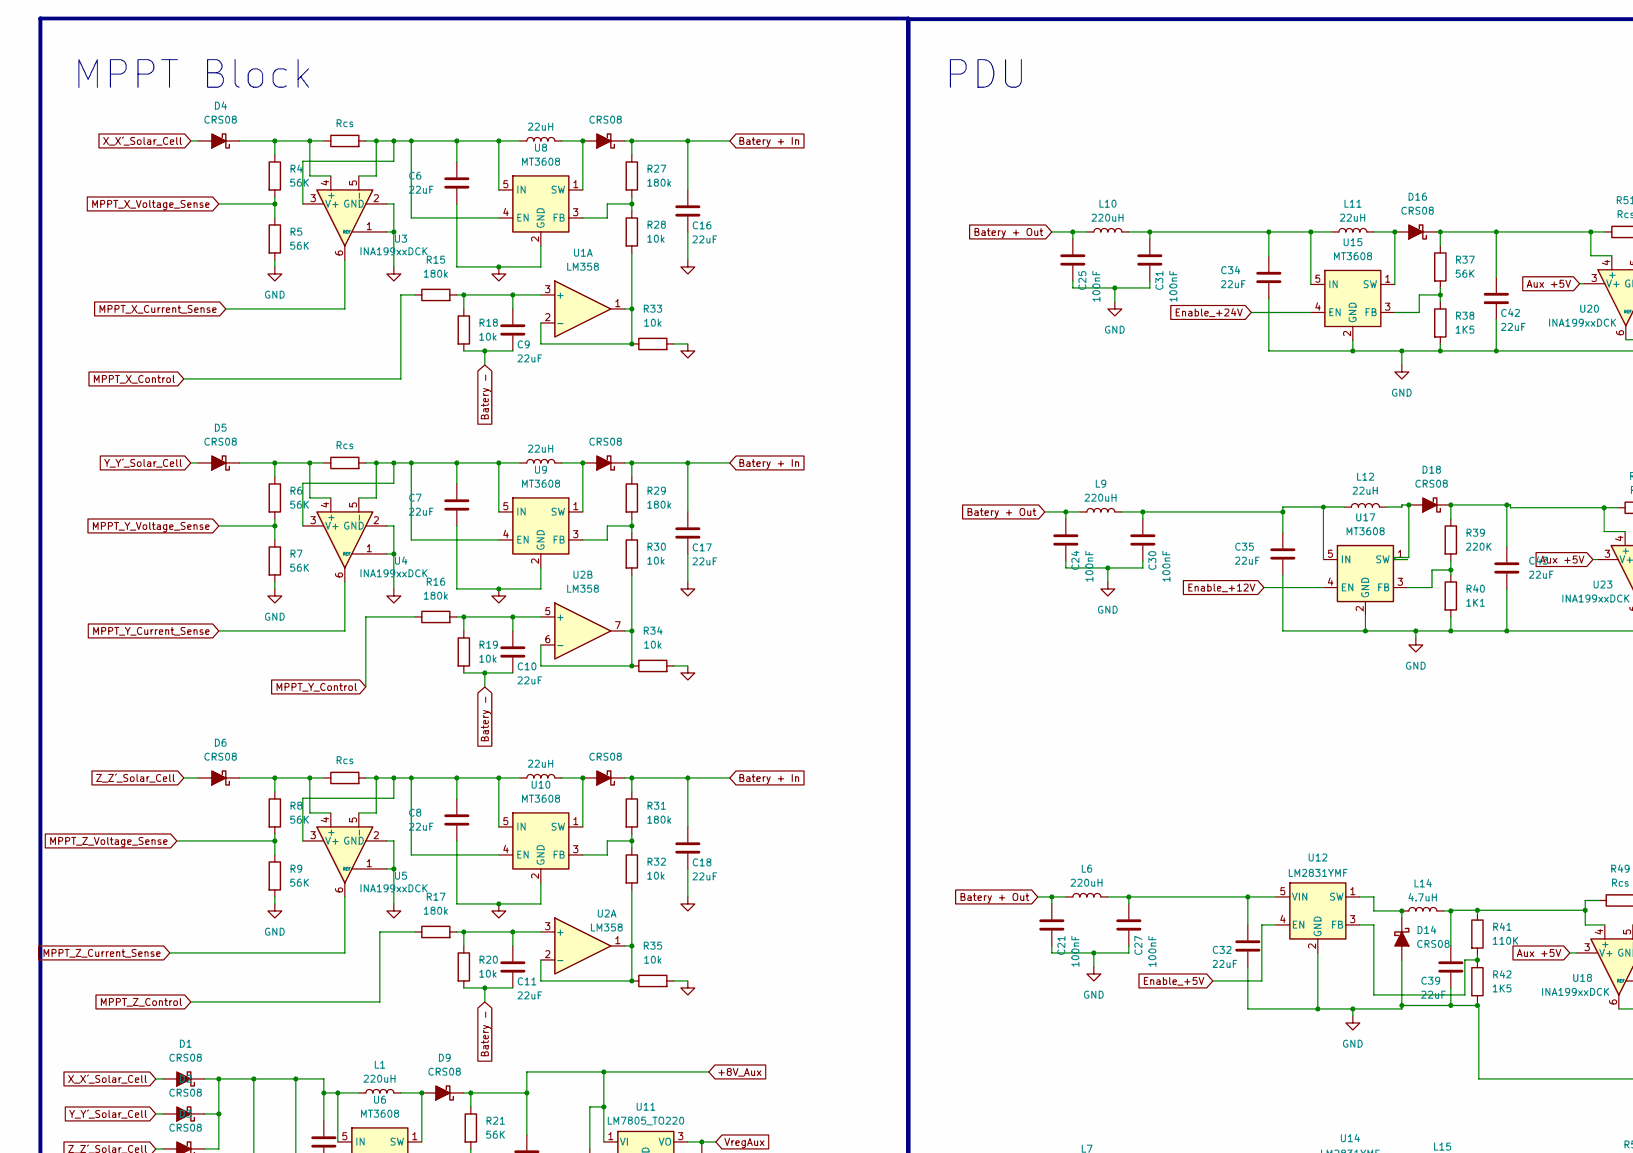
[picture p178: schematic TPP.kicad_sch, part in row 1, column 1]

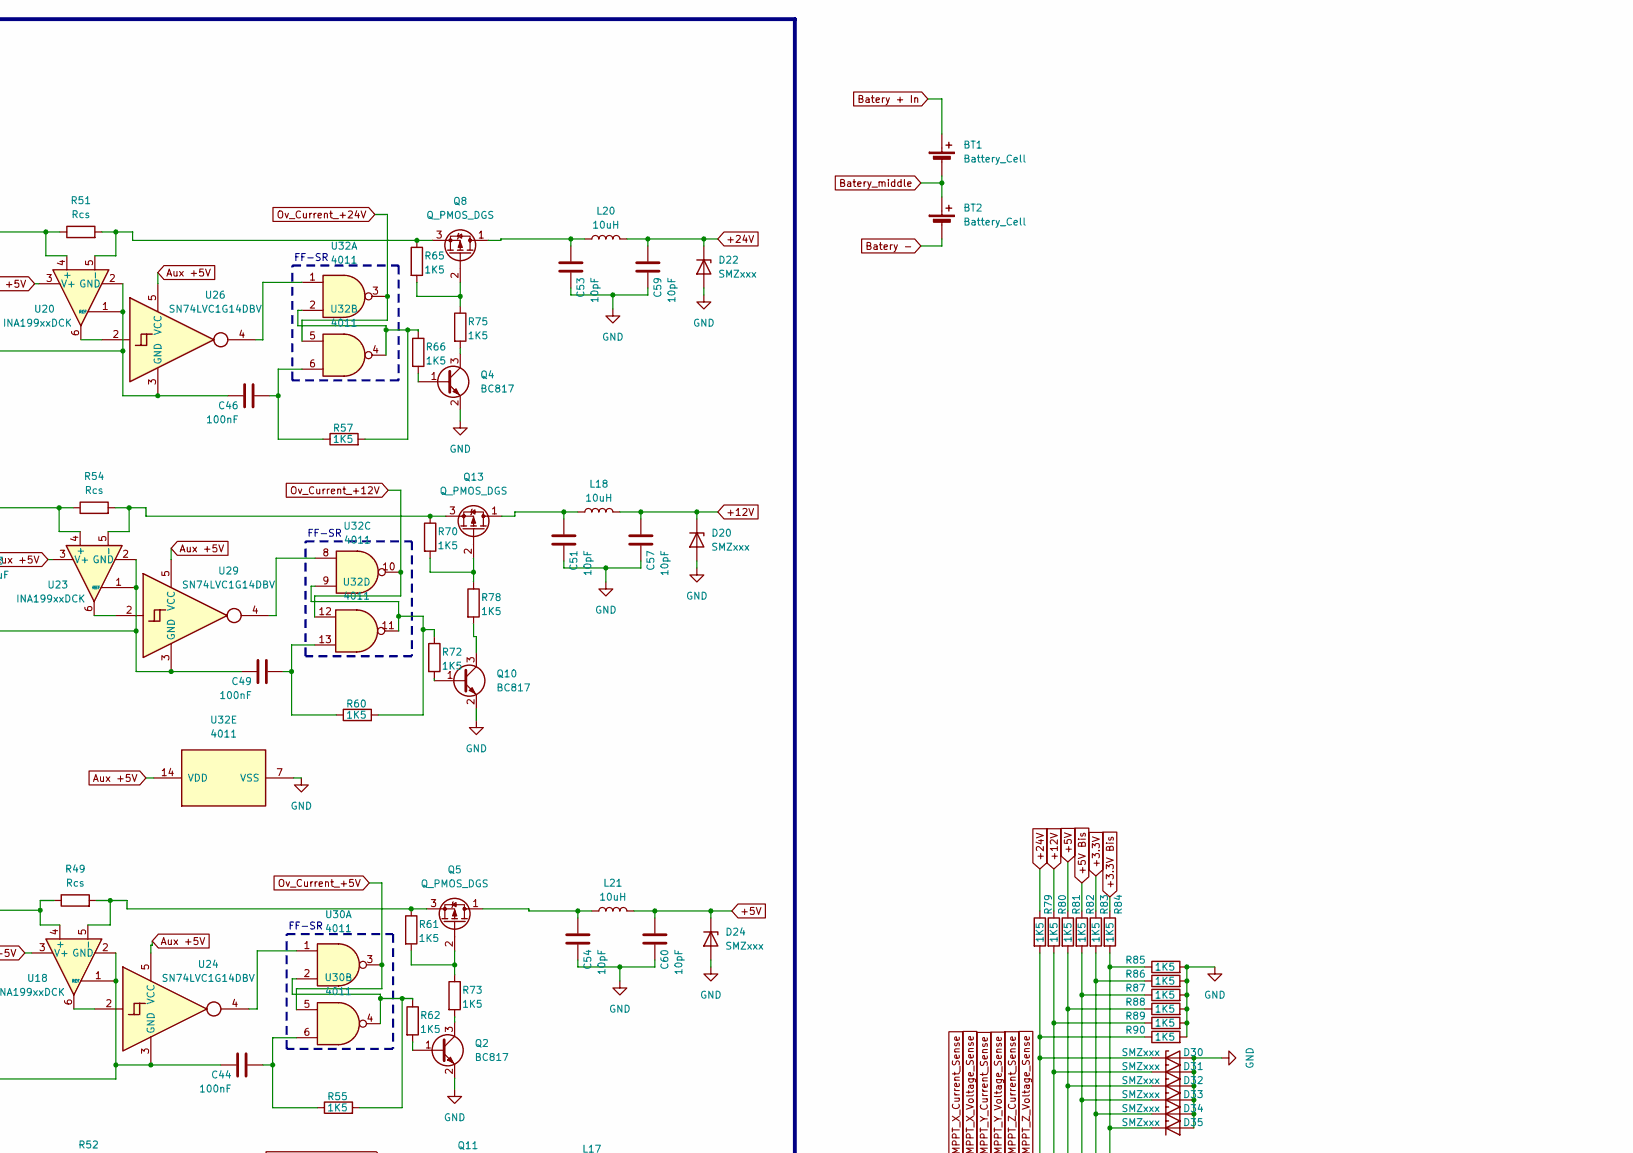
[picture p179: schematic TPP.kicad_sch, part in row 1, column 2]

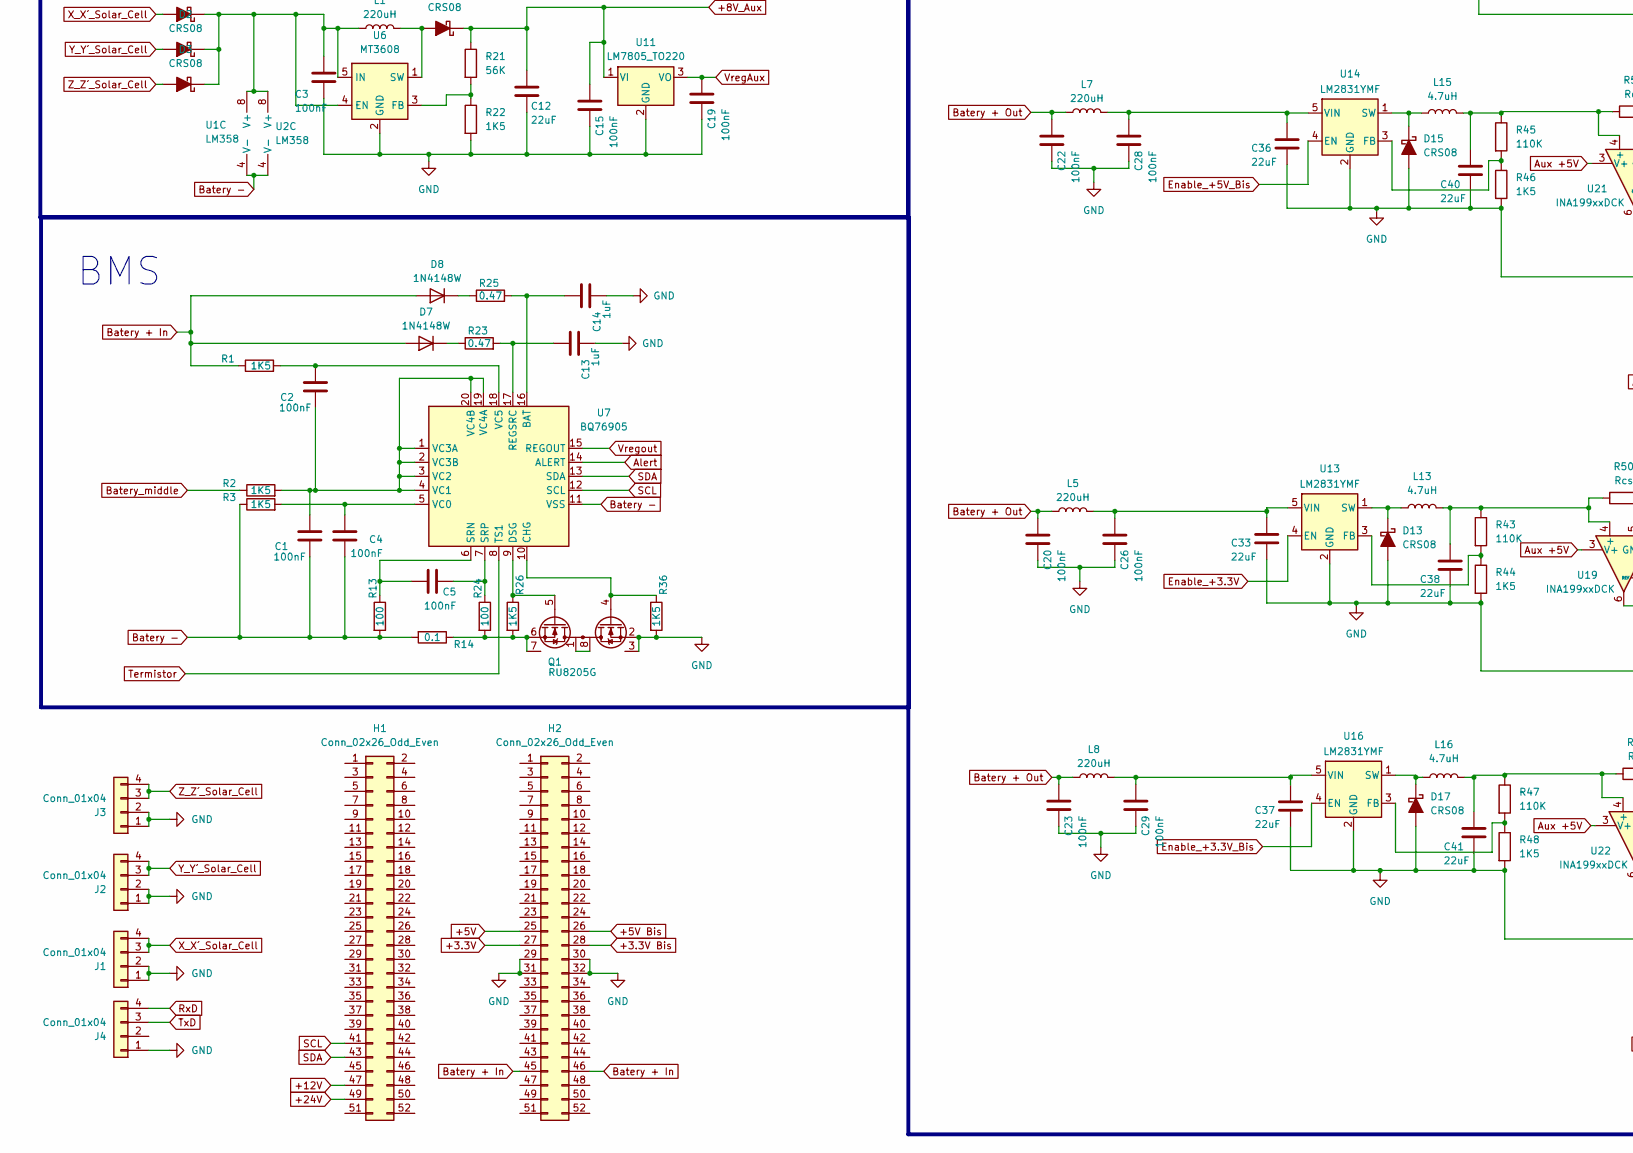
[picture p180: schematic TPP.kicad_sch, part in row 2, column 1]

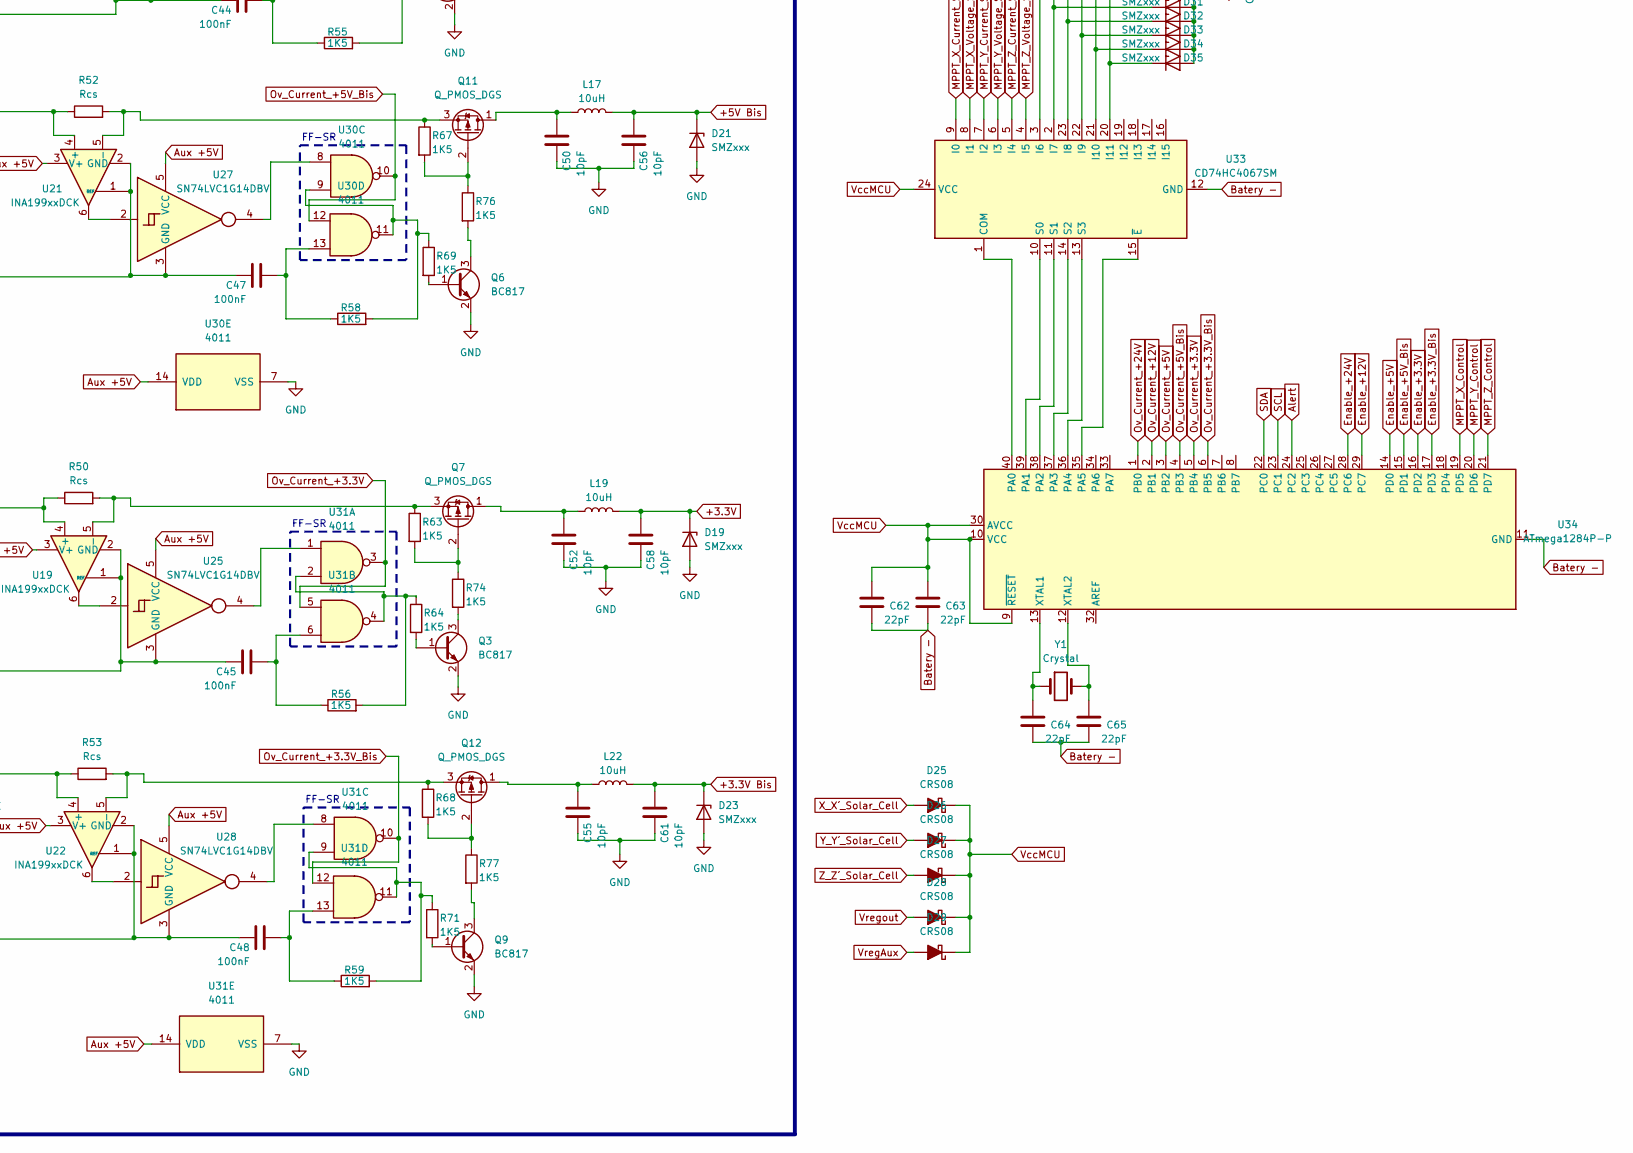
[picture p181: schematic TPP.kicad_sch, part in row 2, column 2]

Parts:
BT1, BT2: Battery_Cell; BatteryHolder_MPD_BH-18650-PC2
C1, C2, C3, C4, C5, C15, C19, C20, C21, C22, C23, C24, C25, C26, C27, C28, C29, C30, C31, C44, C45, C46, C47, C48, C49: 100nF; C_0603_1608Metric_Pad1.08x0.95mm_HandSolder
C6, C7, C8, C9, C10, C11, C12, C16, C17, C18, C32, C33, C34, C35, C36, C37, C38, C39, C40, C41, C42, C43: 22uF; C_0603_1608Metric_Pad1.08x0.95mm_HandSolder
C13, C14: 1uF; C_0603_1608Metric_Pad1.08x0.95mm_HandSolder
C50, C51, C52, C53, C54, C55, C56, C57, C58, C59, C60, C61: 10pF; C_0603_1608Metric_Pad1.08x0.95mm_HandSolder
C62, C63, C64, C65: 22pF; C_0603_1608Metric_Pad1.08x0.95mm_HandSolder
D1, D2, D3, D4, D5, D6, D9, D10, D11, D12, D13, D14, D15, D16, D17, D18, D25, D26, D27, D28, D29: CRS08; D_SMA
D7, D8: 1N4148W; D_SOD-123
D19, D20, D21, D22, D23, D24, D30, D31, D32, D33, D34, D35: SMZxxx; D_MELF
H1, H2: Conn_02x26_Odd_Even; PinSocket_2x26_P2.54mm_Vertical
J1, J2, J3, J4: Conn_01x04; JST_XH_S4B-XH-A-1_1x04_P2.50mm_Horizontal
L1, L5, L6, L7, L8, L9, L10: 220uH; L_Abracon_ASPI-0630LR
L2, L3, L4, L11, L12: 22uH; L_Abracon_ASPI-0630LR
L13, L14, L15, L16: 4.7uH; L_Abracon_ASPI-0630LR
L17, L18, L19, L20, L21, L22: 10uH; L_Abracon_ASPI-0630LR
Q1: RU8205G; TSSOP-8_4.4x3mm_P0.65mm
Q2, Q3, Q4, Q6, Q9, Q10: BC817; SOT-23
Q5, Q7, Q8, Q11, Q12, Q13: Q_PMOS_DGS; TO-220-3_Vertical
R1, R2, R3, R22, R26, R36, R38, R42, R44, R46, R48, R55, R56, R57, R58, R59, R60, R61, R62, R63, R64, R65, R66, R67, R68, R69, R70, R71, R72, R73, R74, R75, R76, R77, R78, R79, R80, R81, R82, R83, R84, R85, R86, R87, R88, R89, R90: 1K5; R_0805_2012Metric_Pad1.20x1.40mm_HandSolder
R4, R5, R6, R7, R8, R9, R21, R37: 56K; R_0805_2012Metric_Pad1.20x1.40mm_HandSolder
R10, R11, R12, R49, R50, R51, R52, R53, R54: Rcs; R_0805_2012Metric_Pad1.20x1.40mm_HandSolder
R13, R24: 100; R_0805_2012Metric_Pad1.20x1.40mm_HandSolder
R14: 0.1; R_0805_2012Metric_Pad1.20x1.40mm_HandSolder
R15, R16, R17, R27, R29, R31: 180k; R_0805_2012Metric_Pad1.20x1.40mm_HandSolder
R18, R19, R20, R28, R30, R32, R33, R34, R35: 10k; R_0805_2012Metric_Pad1.20x1.40mm_HandSolder
R23, R25: 0.47; R_0805_2012Metric_Pad1.20x1.40mm_HandSolder
R39: 220K; R_0805_2012Metric_Pad1.20x1.40mm_HandSolder
R40: 1K1; R_0805_2012Metric_Pad1.20x1.40mm_HandSolder
R41, R43, R45, R47: 110K; R_0805_2012Metric_Pad1.20x1.40mm_HandSolder
U1: LM358; SOIC-8_3.9x4.9mm_P1.27mm
U2: LM358
U3, U4, U5, U18, U19, U20, U21, U22, U23: INA199xxDCK; SOT-363_SC-70-6
U6, U8, U9, U10, U15, U17: MT3608; SOT-23-6
U7: BQ76905; QFN-20-1EP_3x3mm_P0.4mm_EP1.65x1.65mm_ThermalVias
U11: LM7805_TO220; TO-220-3_Vertical
U12, U13, U14, U16: LM2831YMF; SOT-23-5
U24, U25, U26, U27, U28, U29: SN74LVC1G14DBV; SOT-23-5
U30, U31, U32: 4011; SOIC-14_3.9x8.7mm_P1.27mm
U33: CD74HC4067SM; SSOP-24_5.3x8.2mm_P0.65mm
U34: ATmega1284P-P; TQFP-44_10x10mm_P0.8mm
Y1: Crystal; Crystal_HC49-U_Vertical

Connections:
+3.3V: C58.2, D19.1 (K), H2.27, L19.2
+3.3V: R83.1
+3.3V Bis: R84.1
+3.3V Bis: C61.2, D23.1 (K), H2.28, L22.2
+5V: C60.2, D24.1 (K), H2.25, L21.2, R81.1
+5V Bis: C56.2, D21.1 (K), H2.26, L17.2, R82.1
+8V_Aux: C12.1, C15.2, D9.1 (K), R21.1, U11.1 (VI)
+12V: C57.2, D20.1 (K), H1.47, L18.2, R80.1
+24V: C59.2, D22.1 (K), H1.49, L20.2, R79.1
Alert: U7.14 (ALERT), U34.24 (PC2)
Aux +5V: U18.3 (V+), U19.3 (V+), U20.3 (V+), U21.3 (V+), U22.3 (V+), U23.3 (V+), U24.5 (VCC), U25.5 (VCC), U26.5 (VCC), U27.5 (VCC), U28.5 (VCC), U29.5 (VCC), U30.14 (VDD), U31.14 (VDD), U32.14 (VDD)
Batery + In: BT1.1 (+), C16.1, C17.1, C18.1, D7.2 (A), D8.2 (A), D10.1 (K), D11.1 (K), D12.1 (K), H2.45, H2.46, R1.1, R27.1, R29.1, R31.1
Batery + Out: C20.2, C21.2, C22.2, C23.2, C24.2, C25.2, L5.1, L6.1, L7.1, L8.1, L9.1, L10.1
Batery -: BT2.2 (-), C1.1, C4.1, C9.2, C10.2, C11.2, C62.1, C63.1, C64.1, C65.1, R3.1, R13.2, R14.2, R18.2, R19.2, R20.2, U1.4 (V-), U2.4 (V-), U7.11 (VSS), U33.12 (GND), U34.11 (GND), U34.31 (GND)
Batery_middle: BT1.2 (-), BT2.1 (+), R2.1
Enable_+3.3V: U13.4 (EN), U34.16 (PD2)
Enable_+3.3V_Bis: U16.4 (EN), U34.17 (PD3)
Enable_+5V: U12.4 (EN), U34.14 (PD0)
Enable_+5V_Bis: U14.4 (EN), U34.15 (PD1)
Enable_+12V: U17.4 (EN), U34.29 (PC7)
Enable_+24V: U15.4 (EN), U34.28 (PC6)
GND: C3.2, C6.2, C7.2, C8.2, C12.2, C13.1, C14.1, C15.1, C16.2, C17.2, C18.2, C19.1, C20.1, C21.1, C22.1, C23.1, C24.1, C25.1, C26.1, C27.1, C28.1, C29.1, C30.1, C31.1, C32.2, C33.2, C34.2, C35.2, C36.2, C37.2, C38.2, C39.2, C40.2, C41.2, C42.2, C43.2, C44.1, C45.1, C46.1, C47.1, C48.1, C49.1, C50.1, C51.1, C52.1, C53.1, C54.1, C55.1, C56.1, C57.1, C58.1, C59.1, C60.1, C61.1, D13.2 (A), D14.2 (A), D15.2 (A), D17.2 (A), D19.2 (A), D20.2 (A), D21.2 (A), D22.2 (A), D23.2 (A), D24.2 (A), D30.2 (A), D31.2 (A), D32.2 (A), D33.2 (A), D34.2 (A), D35.2 (A), H2.29, H2.30, H2.31, H2.32, J1.1, J1.2, J2.1, J2.2, J3.1, J3.2, J4.1, Q1.2 (D1), Q1.3 (D1), Q2.2 (E), Q3.2 (E), Q4.2 (E), Q6.2 (E), Q9.2 (E), Q10.2 (E), R5.2, R7.2, R9.2, R22.2, R33.2, R34.2, R35.2, R36.2, R38.2, R40.2, R42.2, R44.2, R46.2, R48.2, R85.2, R86.2, R87.2, R88.2, R89.2, R90.2, U3.1 (REF), U3.2 (GND), U4.1 (REF), U4.2 (GND), U5.1 (REF), U5.2 (GND), U6.2 (GND), U8.2 (GND), U9.2 (GND), U10.2 (GND), U11.2 (GND), U12.2 (GND), U13.2 (GND), U14.2 (GND), U15.2 (GND), U16.2 (GND), U17.2 (GND), U18.1 (REF), U18.2 (GND), U19.1 (REF), U19.2 (GND), U20.1 (REF), U20.2 (GND), U21.1 (REF), U21.2 (GND), U22.1 (REF), U22.2 (GND), U23.1 (REF), U23.2 (GND), U24.3 (GND), U25.3 (GND), U26.3 (GND), U27.3 (GND), U28.3 (GND), U29.3 (GND), U30.7 (VSS), U31.7 (VSS), U32.7 (VSS)
MPPT_X_Control: R15.1, U34.19 (PD5)
MPPT_X_Current_Sense: U3.6, U33.9 (I0)
MPPT_X_Voltage_Sense: R4.2, R5.1, U33.8 (I1)
MPPT_Y_Control: R16.1, U34.20 (PD6)
MPPT_Y_Current_Sense: U4.6, U33.7 (I2)
MPPT_Y_Voltage_Sense: R6.2, R7.1, U33.6 (I3)
MPPT_Z_Control: R17.1, U34.21 (PD7)
MPPT_Z_Current_Sense: U5.6, U33.5 (I4)
MPPT_Z_Voltage_Sense: R8.2, R9.1, U33.4 (I5)
unnamed: C44.2, R55.1, U30.6
unnamed: C45.2, R56.1, U31.6
unnamed: C46.2, R57.1, U32.6
unnamed: C47.2, R58.1, U30.13
unnamed: C48.2, R59.1, U31.13
unnamed: C49.2, R60.1, U32.13
unnamed: C3.1, D1.1 (K), D2.1 (K), D3.1 (K), L1.1, U1.8 (V+), U2.8 (V+), U6.4 (EN), U6.5 (IN)
unnamed: D4.1 (K), R4.1, R10.1, U3.4 (+)
unnamed: D5.1 (K), R6.1, R11.1, U4.4 (+)
unnamed: D6.1 (K), R8.1, R12.1, U5.4 (+)
unnamed: D7.1 (K), R23.1
unnamed: D8.1 (K), R25.1
unnamed: D9.2 (A), L1.2, U6.1 (SW)
unnamed: D10.2 (A), L2.2, U8.1 (SW)
unnamed: D11.2 (A), L3.2, U9.1 (SW)
unnamed: D12.2 (A), L4.2, U10.1 (SW)
unnamed: D13.1 (K), L13.1, U13.1 (SW)
unnamed: D14.1 (K), L14.1, U12.1 (SW)
unnamed: D15.1 (K), L15.1, U14.1 (SW)
unnamed: D16.2 (A), L11.2, U15.1 (SW)
unnamed: C42.1, D16.1 (K), R37.1, R51.1, U20.4 (+)
unnamed: D17.1 (K), L16.1, U16.1 (SW)
unnamed: D18.2 (A), L12.2, U17.1 (SW)
unnamed: C43.1, D18.1 (K), R39.1, R54.1, U23.4 (+)
unnamed: D30.1 (K), R79.2, R90.1, U33.3 (I6)
unnamed: D31.1 (K), R80.2, R89.1, U33.2 (I7)
unnamed: D32.1 (K), R81.2, R88.1, U33.23 (I8)
unnamed: D33.1 (K), R82.2, R87.1, U33.22 (I9)
unnamed: D34.1 (K), R83.2, R86.1, U33.21 (I10)
unnamed: D35.1 (K), R84.2, R85.1, U33.20 (I11)
unnamed: Q1.4 (G1), R36.1, U7.10 (CHG)
unnamed: Q1.5 (G2), R26.1, U7.9 (DSG)
unnamed: Q1.1 (S1/D2), Q1.8 (S1/D2)
unnamed: Q1.6 (S2), Q1.7 (S2), R14.1, R24.2, R26.2
unnamed: Q2.1 (B), R62.2
unnamed: Q2.3 (C), R73.2
unnamed: Q3.1 (B), R64.2
unnamed: Q3.3 (C), R74.2
unnamed: Q4.1 (B), R66.2
unnamed: Q4.3 (C), R75.2
unnamed: C54.2, L21.1, Q5.1 (D)
unnamed: Q5.2 (G), R61.2, R73.1
unnamed: Q5.3 (S), R49.2, R61.1, U18.5 (-)
unnamed: Q6.1 (B), R69.2
unnamed: Q6.3 (C), R76.2
unnamed: C52.2, L19.1, Q7.1 (D)
unnamed: Q7.2 (G), R63.2, R74.1
unnamed: Q7.3 (S), R50.2, R63.1, U19.5 (-)
unnamed: C53.2, L20.1, Q8.1 (D)
unnamed: Q8.2 (G), R65.2, R75.1
unnamed: Q8.3 (S), R51.2, R65.1, U20.5 (-)
unnamed: Q9.1 (B), R71.2
unnamed: Q9.3 (C), R77.2
unnamed: Q10.1 (B), R72.2
unnamed: Q10.3 (C), R78.2
unnamed: C50.2, L17.1, Q11.1 (D)
unnamed: Q11.2 (G), R67.2, R76.1
unnamed: Q11.3 (S), R52.2, R67.1, U21.5 (-)
unnamed: C55.2, L22.1, Q12.1 (D)
unnamed: Q12.2 (G), R68.2, R77.1
unnamed: Q12.3 (S), R53.2, R68.1, U22.5 (-)
unnamed: C51.2, L18.1, Q13.1 (D)
unnamed: Q13.2 (G), R70.2, R78.1
unnamed: Q13.3 (S), R54.2, R70.1, U23.5 (-)
unnamed: R55.2, R62.1, U30.2, U30.4
unnamed: R56.2, R64.1, U31.2, U31.4
unnamed: R57.2, R66.1, U32.2, U32.4
unnamed: R58.2, R69.1, U30.9, U30.11
unnamed: R59.2, R71.1, U31.9, U31.11
unnamed: R60.2, R72.1, U32.9, U32.11
unnamed: C9.1, R15.2, R18.1, U1.3 (+)
unnamed: R28.2, R33.1, U1.1, U1.2 (-)
unnamed: C11.1, R17.2, R20.1, U2.3 (+)
unnamed: R32.2, R35.1, U2.1, U2.2 (-)
unnamed: C10.1, R16.2, R19.1, U2.5 (+)
unnamed: R30.2, R34.1, U2.6 (-), U2.7
unnamed: C6.1, L2.1, R10.2, U3.3 (V+), U3.5 (-), U8.4 (EN), U8.5 (IN)
unnamed: C7.1, L3.1, R11.2, U4.3 (V+), U4.5 (-), U9.4 (EN), U9.5 (IN)
unnamed: R21.2, R22.1, U6.3 (FB)
unnamed: C14.2, R25.2, U7.16 (BAT)
unnamed: C13.2, R23.2, U7.17 (REGSRC)
unnamed: C5.1, R13.1, U7.6 (SRN)
unnamed: C5.2, R24.1, U7.7 (SRP)
unnamed: C4.2, R3.2, U7.5 (VC0)
unnamed: C1.2, C2.1, R2.2, U7.1 (VC3A), U7.2 (VC3B), U7.3 (VC2), U7.4 (VC1), U7.19 (VC4A), U7.20 (VC4B)
unnamed: C2.2, R1.2, U7.18 (VC5)
unnamed: R27.2, R28.1, U8.3 (FB)
unnamed: R29.2, R30.1, U9.3 (FB)
unnamed: C8.1, L4.1, R12.2, U5.3 (V+), U5.5 (-), U10.4 (EN), U10.5 (IN)
unnamed: R31.2, R32.1, U10.3 (FB)
unnamed: R41.2, R42.1, U12.3 (FB)
unnamed: C27.2, C32.1, L6.2, U12.5 (VIN)
unnamed: R43.2, R44.1, U13.3 (FB)
unnamed: C26.2, C33.1, L5.2, U13.5 (VIN)
unnamed: R45.2, R46.1, U14.3 (FB)
unnamed: C28.2, C36.1, L7.2, U14.5 (VIN)
unnamed: R37.2, R38.1, U15.3 (FB)
unnamed: C31.2, C34.1, L10.2, L11.1, U15.5 (IN)
unnamed: R47.2, R48.1, U16.3 (FB)
unnamed: C29.2, C37.1, L8.2, U16.5 (VIN)
unnamed: R39.2, R40.1, U17.3 (FB)
unnamed: C30.2, C35.1, L9.2, L12.1, U17.5 (IN)
unnamed: C39.1, L14.2, R41.1, R49.1, U18.4 (+)
unnamed: U18.6, U24.2
unnamed: C38.1, L13.2, R43.1, R50.1, U19.4 (+)
unnamed: U19.6, U25.2
unnamed: U20.6, U26.2
unnamed: C40.1, L15.2, R45.1, R52.1, U21.4 (+)
unnamed: U21.6, U27.2
unnamed: C41.1, L16.2, R47.1, R53.1, U22.4 (+)
unnamed: U22.6, U28.2
unnamed: U23.6, U29.2
unnamed: U24.4, U30.1
unnamed: U25.4, U31.1
unnamed: U26.4, U32.1
unnamed: U27.4, U30.8
unnamed: U28.4, U31.8
unnamed: U29.4, U32.8
unnamed: U33.1 (COM), U34.40 (PA0)
unnamed: U33.10 (S0), U34.39 (PA1)
unnamed: U33.11 (S1), U34.38 (PA2)
unnamed: U33.14 (S2), U34.37 (PA3)
unnamed: U33.13 (S3), U34.36 (PA4)
unnamed: U33.15 (~E), U34.35 (PA5)
unnamed: C64.2, U34.13 (XTAL1), Y1.1
unnamed: C65.2, U34.12 (XTAL2), Y1.2
Ov_Current_+3.3V: U31.3, U31.5, U34.5 (PB4)
Ov_Current_+3.3V_Bis: U31.10, U31.12, U34.6 (PB5)
Ov_Current_+5V: U30.3, U30.5, U34.3 (PB2)
Ov_Current_+5V_Bis: U30.10, U30.12, U34.4 (PB3)
Ov_Current_+12V: U32.10, U32.12, U34.2 (PB1)
Ov_Current_+24V: U32.3, U32.5, U34.1 (PB0)
RxD: J4.4
SCL: H1.41, U7.12 (SCL), U34.23 (PC1)
SDA: H1.43, U7.13 (SDA), U34.22 (PC0)
Termistor: U7.8 (TS1)
TxD: J4.3
VccMCU: C62.2, C63.2, D25.1 (K), D26.1 (K), D27.1 (K), D28.1 (K), D29.1 (K), U33.24 (VCC), U34.9 (~RESET), U34.10 (VCC), U34.30 (AVCC)
VregAux: C19.2, D29.2 (A), U11.3 (VO)
Vregout: D28.2 (A), U7.15 (REGOUT)
X_X´_Solar_Cell: D1.2 (A), D4.2 (A), D25.2 (A), J1.3, J1.4
Y_Y´_Solar_Cell: D2.2 (A), D5.2 (A), D26.2 (A), J2.3, J2.4
Z_Z´_Solar_Cell: D3.2 (A), D6.2 (A), D27.2 (A), J3.3, J3.4

Notes on the sheet:
BMS
PDU
FF-SR
MPPT Block

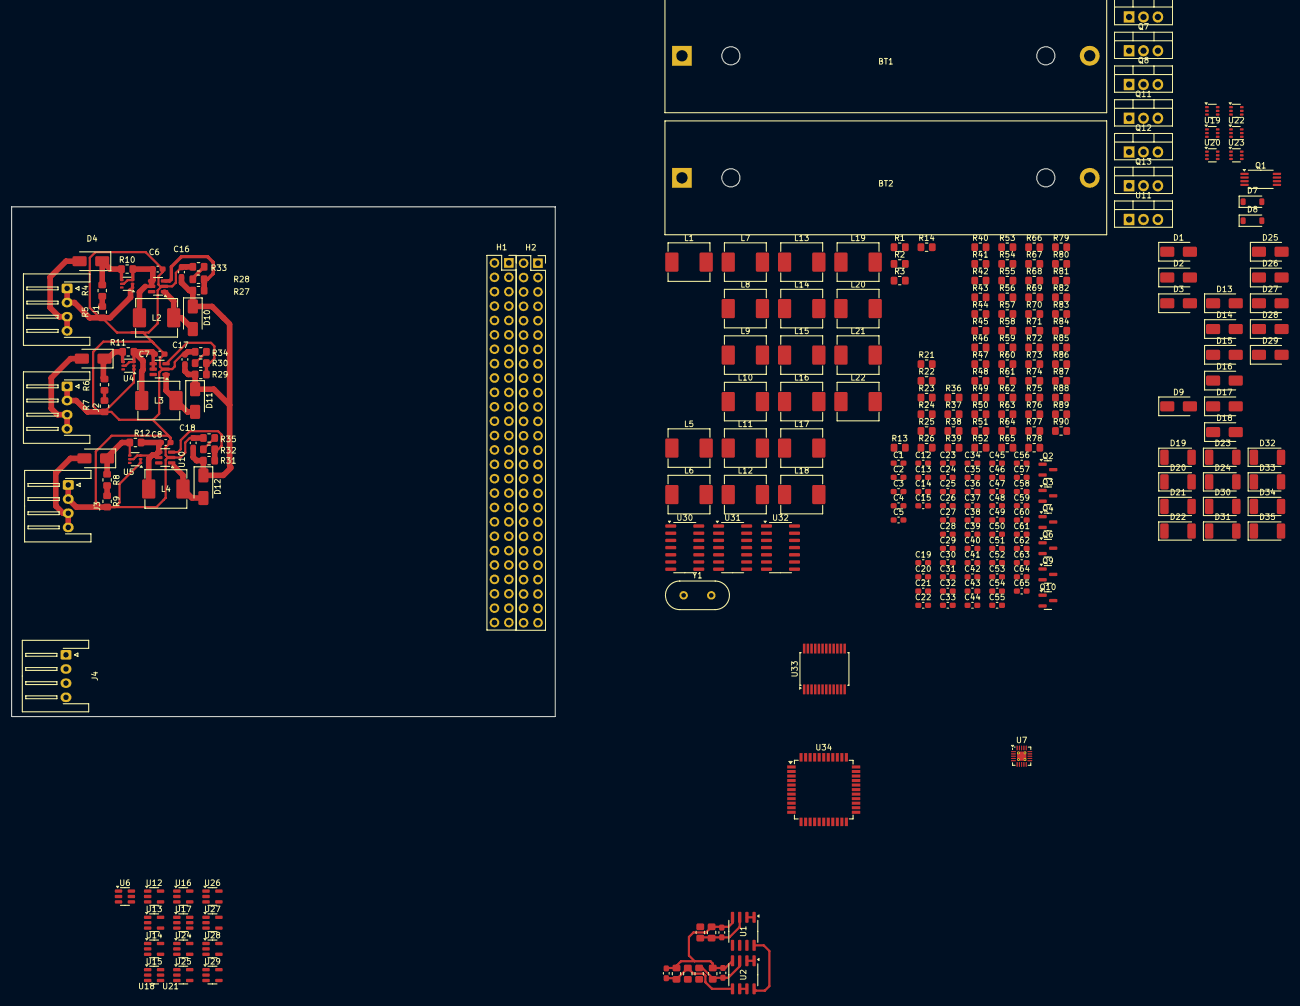
[picture p182: board hardware/power sistem/superados/PowerSis-V0.0/TPP.kicad_pcb from above]

Board: 2 copper layers, 96.0 x 90.0 mm, 268 parts (0 on the bottom side), 169 nets.
