juan-LARRAYA/TPP/hardware/power sistem/superados/referencias/LittleBrain-STM32F4/RBoard.kicad_pcb

## KiCad design hardware/power sistem/superados/referencias/LittleBrain-STM32F4/RBoard.kicad_pcb (2024-11-17)

Schematic: RBoard.sch

Parts:
H1, H2, H3, H4: MountingHole; MountingHole_3.2mm_M3

Notes on the sheet:
Little Brain
Power
Microcontroller
Sensors
Connectors

Schematic: Power.sch

Parts:
C100, C102, C103: 10u; C_1206_3216Metric; LCSC Part # C13585
C101: 10n; C_0603_1608Metric; LCSC Part # C57112
D100, D101: B5819W; D_SOD-123; LCSC Part # C8598
D102: GREEN; LED_0603_1608Metric; LCSC Part # C72043
F100: 250mA; Fuse_1206_3216Metric; LCSC Part # C70068
FB100: 600 @ 600 MHz; L_0805_2012Metric; LCSC Part # C1017
L101: 10u; L_Sunlord_MWSA0518_5.4x5.2mm; LCSC Part # C139506
Q100: AO3401A; SOT-23; LCSC Part # C15127
R100: 100k; R_0603_1608Metric; LCSC Part # C25803
R101: 68k; R_0603_1608Metric; LCSC Part # C23231
R102: 47k; R_0603_1608Metric; LCSC Part # C25819
R103: 15k; R_0603_1608Metric; LCSC Part # C22809
R104: 270; R_0603_1608Metric; LCSC Part # C22966
R105: 1k5; R_0603_1608Metric; LCSC Part # C22843
U100: MP2359DJ-LF-Z; SOT-23-6; LCSC Part # C14259

Connections:
+3V3: C102.1, C103.1, D102.2, L101.2, R102.1; also elsewhere on the board
+5V: D100.2; also elsewhere on the board
GND: C100.2, C102.2, C103.2, D101.2, Q100.1, R101.2, R104.2, R105.2, U100.2; also elsewhere on the board
unnamed: C100.1, FB100.1, R100.1, U100.5
unnamed: C101.1, D101.1, L101.1, U100.6
unnamed: C101.2, U100.1
unnamed: D100.1, F100.2, Q100.2
unnamed: D102.1, R105.1
unnamed: F100.1, FB100.2
unnamed: R100.2, R101.1, U100.4
unnamed: R102.2, R103.1, U100.3
unnamed: R103.2, R104.1
VCC: Q100.3; also elsewhere on the board

Notes on the sheet:
Power
Step-Down Converter (3V3)
Pwr LED

Schematic: MCU.sch

Parts:
C200: 4u7; C_0603_1608Metric; LCSC Part # C19666
C201, C202, C203, C204, C205, C212, C213: 100n; C_0402_1005Metric; LCSC Part # C1525
C206: 1u; C_0402_1005Metric; LCSC Part # C52923
C207: 10n; C_0402_1005Metric; LCSC Part # C15195
C208, C209: 2u2; C_0603_1608Metric; LCSC Part # C23630
C210, C211: 12p; C_0402_1005Metric; LCSC Part # C1547
D200: RED; LED_0603_1608Metric; LCSC Part # C2286
D201: 19-237/R6GHBHC-A01/2T; 19-237-R6GHBHC-A01-2T; LCSC Part # C60105
FB200: 600 @ 600 MHz; L_0805_2012Metric; LCSC Part # C1017
R200: 47; R_0402_1005Metric; LCSC Part # C25118
R201, R203, R209, R210: 10k; R_0402_1005Metric; LCSC Part # C25744
R202: 1k; R_0603_1608Metric; LCSC Part # C21190
R204, R205: 2k2; R_0402_1005Metric; LCSC Part # C25879
R206, R207, R208: 1k; R_0402_1005Metric; LCSC Part # C11702
SW200: SW_SPDT; SW_SPDT_PCM12
U200: STM32F405RGT6; LQFP-64_10x10mm_P0.5mm; LCSC Part # C15742
U201: W25N01GVZEIG; LCSC Part # C88868
Y200: 16MHz; Crystal_SMD_3225-4Pin_3.2x2.5mm; LCSC Part # C13738

Connections:
+3.3VA: C206.1, C207.1, FB200.1, U200.13
+3V3: C200.1, C201.1, C202.1, C203.1, C204.1, C205.1, C212.1, C213.1, D201.4, FB200.2, R204.1, R205.1, R209.1, R210.1, SW200.1, U200.1, U200.19, U200.32, U200.48, U200.64, U201.8 (VCC); also elsewhere on the board
ADC1_IN0: U200.14; also elsewhere on the board
ADC1_IN1: U200.15; also elsewhere on the board
ADC1_IN2: U200.16; also elsewhere on the board
ADC1_IN3: U200.17; also elsewhere on the board
BOOT0: R201.2, U200.60
BOOT1: R203.1, U200.28
FLASH_!HOLD: R210.2, U200.37, U201.7 (~HOLD)
FLASH_!WP: R209.2, U200.38, U201.3 (~WP)
GND: C200.2, C201.2, C202.2, C203.2, C204.2, C205.2, C206.2, C207.2, C208.2, C209.2, C210.2, C211.2, C212.2, C213.2, R202.1, R203.2, SW200.3, U200.12, U200.18, U200.63, U201.4 (GND), U201.9 (EP), Y200.2, Y200.4; also elsewhere on the board
HSE_IN: C210.1, U200.5, Y200.1
HSE_OUT: R200.1, U200.6
I2C1_SCL: R204.2, U200.61; also elsewhere on the board
I2C1_SDA: R205.2, U200.62; also elsewhere on the board
INT_ACC: U200.10; also elsewhere on the board
INT_GYR: U200.11; also elsewhere on the board
NRST: U200.7; also elsewhere on the board
unnamed: C208.1, U200.31
unnamed: C209.1, U200.47
unnamed: C211.1, R200.2, Y200.3
unnamed: D200.1, R202.2
unnamed: D200.2, R201.1, SW200.2
unnamed: D201.1, R206.1
unnamed: D201.2, R207.1
unnamed: D201.3, R208.1
SPI1_!CS_ACC: U200.20; also elsewhere on the board
SPI1_!CS_GYR: U200.24; also elsewhere on the board
SPI1_MISO: U200.22; also elsewhere on the board
SPI1_MOSI: U200.23; also elsewhere on the board
SPI1_SCK: U200.21; also elsewhere on the board
SPI2_!CS: U200.33, U201.1 (~CS)
SPI2_MISO: U200.35, U201.2 (DO(IO1))
SPI2_MOSI: U200.36, U201.5 (DI(IO0))
SPI2_SCK: U200.34, U201.6 (CLK)
SPI3_!CS: U200.50; also elsewhere on the board
SPI3_MISO: U200.52; also elsewhere on the board
SPI3_MOSI: U200.53; also elsewhere on the board
SPI3_SCK: U200.51; also elsewhere on the board
SWCLK: U200.49; also elsewhere on the board
SWDIO: U200.46; also elsewhere on the board
SWO: U200.55; also elsewhere on the board
TIM2_CH3: U200.29; also elsewhere on the board
TIM2_CH4: U200.30; also elsewhere on the board
TIM3_CH1: R206.2, U200.56
TIM3_CH2: R207.2, U200.57
TIM3_CH3: U200.26; also elsewhere on the board
TIM3_CH4: U200.27; also elsewhere on the board
TIM4_CH1: R208.2, U200.58
USART1_RX: U200.43; also elsewhere on the board
USART1_TX: U200.42; also elsewhere on the board
USB_D+: U200.45; also elsewhere on the board
USB_D-: U200.44; also elsewhere on the board

Notes on the sheet:
Microcontroller
STM32 MCU
Decoupling
HSE
FLASH Memory
BOOT0 Switch
RGB LED
I2C Pull-Ups

Schematic: Sensors.sch

Parts:
C300, C301, C302, C303: 100n; C_0402_1005Metric; LCSC Part # C1525
U300: BMP280; Bosch_LGA-8_2x2.5mm_P0.65mm_ClockwisePinNumbering; LCSC Part # C233787
U301: BMI088; LCSC Part # C194919

Connections:
+3V3: C300.1, C301.1, C302.1, C303.1, U300.6, U300.8, U301.3, U301.11; also elsewhere on the board
GND: C300.2, C301.2, C302.2, C303.2, U300.1, U300.7, U301.2, U301.4, U301.6, U301.7; also elsewhere on the board
INT_ACC: U301.16; also elsewhere on the board
INT_GYR: U301.12; also elsewhere on the board
SPI1_!CS_ACC: U301.14; also elsewhere on the board
SPI1_!CS_GYR: U301.5; also elsewhere on the board
SPI1_MISO: U301.10, U301.15; also elsewhere on the board
SPI1_MOSI: U301.9; also elsewhere on the board
SPI1_SCK: U301.8; also elsewhere on the board
SPI3_!CS: U300.2; also elsewhere on the board
SPI3_MISO: U300.5; also elsewhere on the board
SPI3_MOSI: U300.3; also elsewhere on the board
SPI3_SCK: U300.4; also elsewhere on the board

Notes on the sheet:
Sensors
Barometric Pressure Sensor
Inertial Measurement Unit

Schematic: Connectors.sch

Parts:
C400: 100n; C_0402_1005Metric; LCSC Part # C1525
J400: Conn_01x02; Molex_PicoBlade_53048-0210_1x02_P1.25mm_Horizontal
J401: SWD; PinHeader_2x05_P1.27mm_Vertical_SMD
J402: USB_B_Micro; USB_Micro-B_Wuerth_629105150521
J403, J404, J405, J406, J407, J408: Conn_01x04; Molex_PicoBlade_53048-0410_1x04_P1.25mm_Horizontal
R400, R401, R402, R403, R404, R405, R406, R407, R408, R409, R410, R411, R412, R413, R414, R415: 22; R_0402_1005Metric; LCSC Part # C25092

Connections:
+3V3: J401.1, J403.1, J404.1, J405.1, J406.1, J407.1, J408.1; also elsewhere on the board
+5V: J402.1 (VBUS); also elsewhere on the board
ADC1_IN0: R412.2; also elsewhere on the board
ADC1_IN1: R413.2; also elsewhere on the board
ADC1_IN2: R414.2; also elsewhere on the board
ADC1_IN3: R415.2; also elsewhere on the board
GND: C400.2, J400.2, J401.3, J401.5, J401.9, J402.5 (GND), J403.4, J404.4, J405.4, J406.4, J407.4, J408.4; also elsewhere on the board
I2C1_SCL: R404.2; also elsewhere on the board
I2C1_SDA: R405.2; also elsewhere on the board
NRST: C400.1, R403.1; also elsewhere on the board
unnamed: J401.2, R400.2
unnamed: J401.4, R401.2
unnamed: J401.6, R402.2
unnamed: J401.10, R403.2
unnamed: J403.2, R404.1
unnamed: J403.3, R405.1
unnamed: J404.2, R406.1
unnamed: J404.3, R407.1
unnamed: J405.2, R408.1
unnamed: J405.3, R409.1
unnamed: J406.2, R410.1
unnamed: J406.3, R411.1
unnamed: J407.2, R412.1
unnamed: J407.3, R413.1
unnamed: J408.2, R414.1
unnamed: J408.3, R415.1
SWCLK: R401.1; also elsewhere on the board
SWDIO: R400.1; also elsewhere on the board
SWO: R402.1; also elsewhere on the board
TIM2_CH3: R408.2; also elsewhere on the board
TIM2_CH4: R409.2; also elsewhere on the board
TIM3_CH3: R410.2; also elsewhere on the board
TIM3_CH4: R411.2; also elsewhere on the board
USART1_RX: R407.2; also elsewhere on the board
USART1_TX: R406.2; also elsewhere on the board
USB_D+: J402.3 (D+); also elsewhere on the board
USB_D-: J402.2 (D-); also elsewhere on the board
VCC: J400.1; also elsewhere on the board

Notes on the sheet:
Connectors
USB
Peripherals
Power
SWD

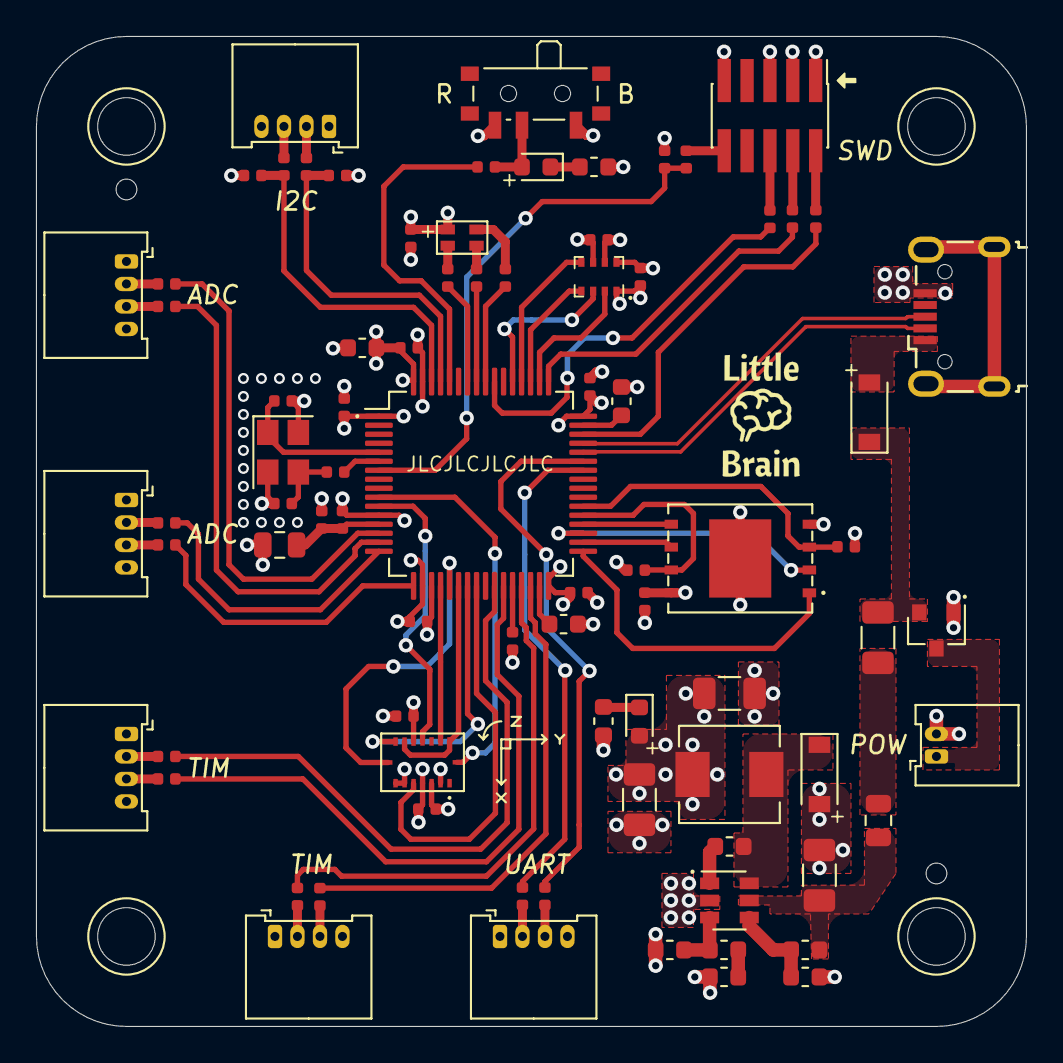
[picture p183: board RBoard.kicad_pcb from above]

Board: 4 copper layers, 55.0 x 55.0 mm, 86 parts (0 on the bottom side), 80 nets.
