juan-LARRAYA/TPP/hardware/power sistem/superados/referencias/bluephil-old/STM32F4_REV2.kicad_pcb

## KiCad design hardware/power sistem/superados/referencias/bluephil-old/STM32F4_REV2.kicad_pcb (2024-11-17, an earlier design)

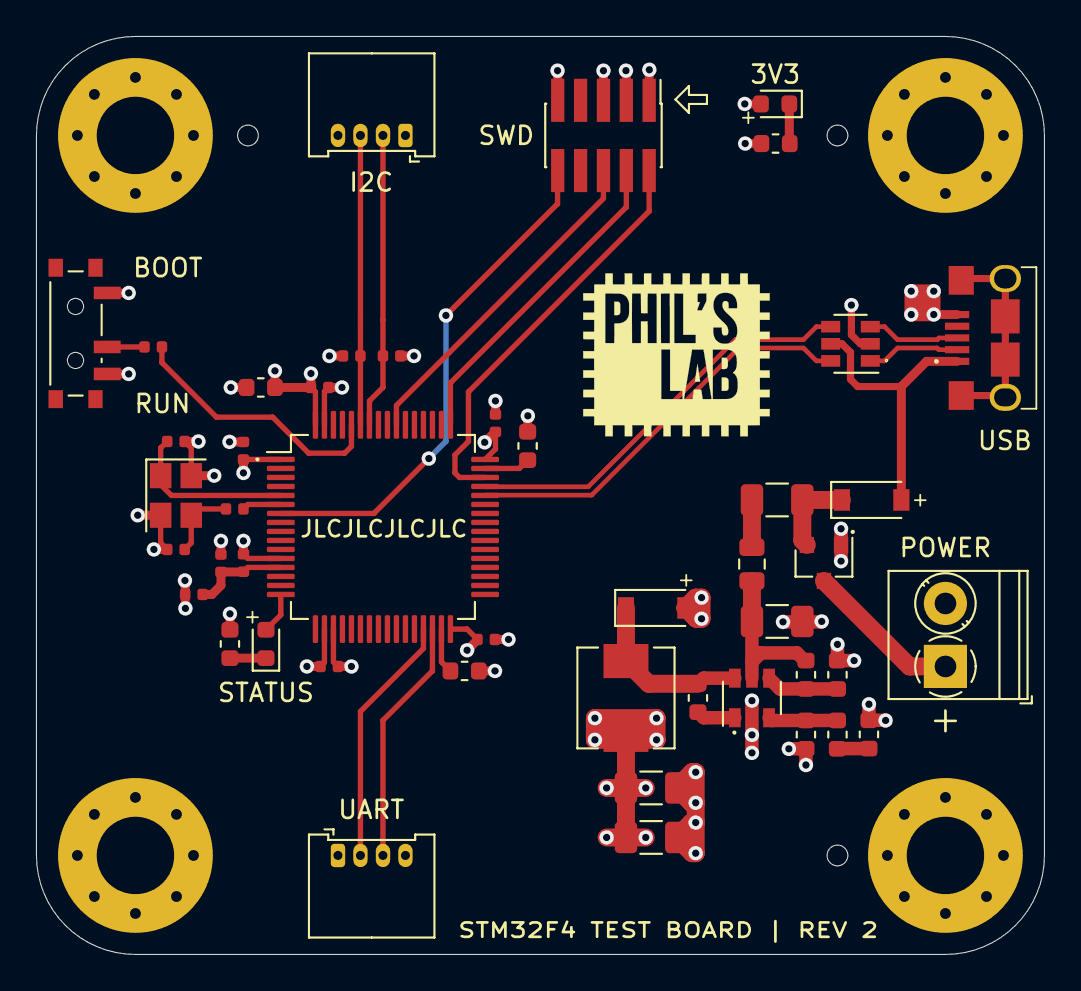
[picture p184: board STM32F4_REV2.kicad_pcb from above]

Board: 4 copper layers, 56.0 x 51.0 mm, 50 parts (0 on the bottom side), 35 nets.

Parts:
C1, C2, C3: 10u; C_1206_3216Metric
C4: 10n; C_0603_1608Metric
C5: 4u7; C_0603_1608Metric
C6, C7, C8, C9, C10: 100n; C_0402_1005Metric
C11: 1u; C_0402_1005Metric
C12: 10n; C_0402_1005Metric
C13, C14: 2u2; C_0603_1608Metric
C15, C16: 12p; C_0402_1005Metric
D1, D2: B5819W; D_SOD-123
D3: RED; LED_0603_1608Metric
D4: BLUE; LED_0603_1608Metric
F1: 250mA; Fuse_1206_3216Metric
FB1: 600 @ 600MHz; L_0805_2012Metric
H1, H2, H3, H4: MountingHole_Pad; MountingHole_4.3mm_M4_Pad_Via
J1: Screw_Terminal_01x02; TerminalBlock_Phoenix_PT-1,5-2-3.5-H_1x02_P3.50mm_Horizontal
J2: SWD; PinHeader_2x05_P1.27mm_Vertical_SMD
J3, J4: Conn_01x04; Molex_PicoBlade_53048-0410_1x04_P1.25mm_Horizontal
J5: USB_B_Micro; USB_MICRO_B_101181930001LF
L1: 10u; L_Sunlord_MWSA0518_5.4x5.2mm
L2: 39n; L_0402_1005Metric
Q1: AO3401A; SOT-23
R1: 100k; R_0603_1608Metric
R2: 68k; R_0603_1608Metric
R3: 47k; R_0603_1608Metric
R4: 15k; R_0603_1608Metric
R5: 270; R_0603_1608Metric
R6: 1k; R_0603_1608Metric
R7: 10k; R_0402_1005Metric
R8: 47; R_0402_1005Metric
R9: 1k5; R_0603_1608Metric
R10, R11: 2k2; R_0402_1005Metric
SW1: SW_SPDT; SW_SPDT_PCM12
U1: MP2359DJ-LF-Z; SOT-23-6
U2: STM32F405RGT6; LQFP-64_10x10mm_P0.5mm
U3: USBLC6-2SC6; SOT-23-6
Y1: 16MHz; Crystal_SMD_3225-4Pin_3.2x2.5mm

Connections:
+3.3VA: C11.1, C12.1, L2.2, U2.13
+3V3: C2.1, C3.1, C5.1, C6.1, C7.1, C8.1, C9.1, C10.1, D3.2, J2.1, J3.1, J4.1, L1.2, L2.1, R3.1, R10.1, R11.1, SW1.1, U2.1, U2.19, U2.32, U2.48, U2.64
+5V: D1.2, J5.1, U3.5
+12V: J1.1, Q1.3
BOOT0: R7.2, U2.60
BUCK_BST: C4.2, U1.1
BUCK_EN: R1.2, R2.1, U1.4
BUCK_FB: R3.2, R4.1, U1.3
BUCK_IN: C1.1, FB1.1, R1.1, U1.5
BUCK_SW: C4.1, D2.1, L1.1, U1.6
GND: C1.2, C2.2, C3.2, C5.2, C6.2, C7.2, C8.2, C9.2, C10.2, C11.2, C12.2, C13.2, C14.2, C15.2, C16.2, D2.2, H1.1, H2.1, H3.1, H4.1, J1.2, J2.3, J2.5, J2.9, J3.4, J4.4, J5.5, Q1.1, R2.2, R5.2, R6.1, R9.1, SW1.3, U1.2, U2.12, U2.18, U2.63, U3.2, Y1.2, Y1.4
HSE_IN: C15.1, U2.5, Y1.1
HSE_OUT: R8.1, U2.6
I2C1_SCL: J3.2, R10.2, U2.58
I2C1_SDA: J3.3, R11.2, U2.59
LED_STATUS: D4.2, U2.16
NRST: J2.10, U2.7
unnamed: C13.1, U2.31
unnamed: C14.1, U2.47
unnamed: C16.1, R8.2, Y1.3
unnamed: D1.1, F1.2, Q1.2
unnamed: D3.1, R6.2
unnamed: D4.1, R9.2
unnamed: F1.1, FB1.2
unnamed: R4.2, R5.1
unnamed: R7.1, SW1.2
SWCLK: J2.4, U2.49
SWDIO: J2.2, U2.46
SWO: J2.6, U2.55
USART3_RX: J4.3, U2.30
USART3_TX: J4.2, U2.29
USB_CONN_D+: J5.3, U3.3
USB_CONN_D-: J5.2, U3.1
USB_D+: U2.45, U3.4
USB_D-: U2.44, U3.6
