juan-LARRAYA/TPP/hardware/power sistem/superados/referencias/BluePhil-main/BluePhil.kicad_pcb

## KiCad design hardware/power sistem/superados/referencias/BluePhil-main/BluePhil.kicad_pcb (2024-11-17)

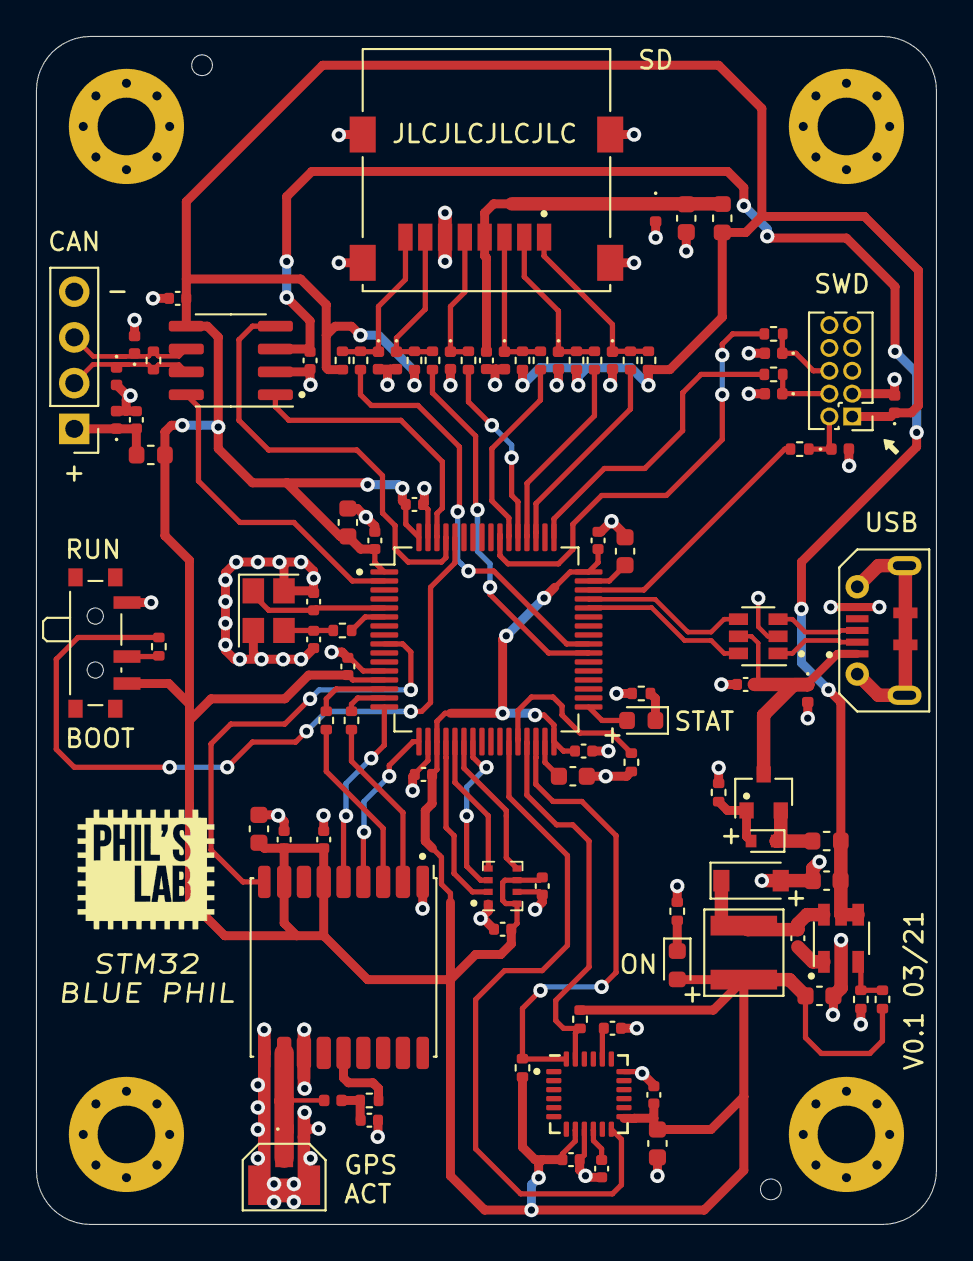
[picture p185: board BluePhil.kicad_pcb from above]

Board: 2 copper layers, 50.0 x 66.0 mm, 103 parts (0 on the bottom side), 68 nets.

Parts:
C100, C207, C208: 2u2; C_0603_1608Metric
C101, C201, C202, C203, C204, C205, C206, C212, C301, C302, C400, C401, C403, C404, C405, C501, C502, C503, C504: 100n; C_0402_1005Metric
C102, C200, C300, C402, C500: 10u; C_0603_1608Metric
C209, C210: 10p; C_0402_1005Metric
C303: 10n; C_0402_1005Metric
C406: 2n2; C_0402_1005Metric
D100: LM5Z2V7T1G; D_SOD-523
D101: B5819W; D_SOD-123
D102: GREEN; LED_0603_1608Metric
D200: BLUE; LED_0603_1608Metric
D201, D202, D203, D204, D205, D300, D500, D501, D502, D503, D504, D505, D506, D507, D508, D509: RCLAMP0521P-N; D_0402_1005Metric
FB100, FB500, FB501: 100R; L_0603_1608Metric
H500, H501, H502, H503: MountingHole_Pad; MountingHole_3.2mm_M3_Pad_Via
J200: SWD; PinHeader_2x05_P1.27mm_Vertical
J201: USB_B_Micro; MicroXNJ
J300: U.FL; BWIPX-1-001E
J500: Micro_SD_Card; TF-102-15
J501: Conn_01x04; PinHeader_1x04_P2.54mm_Vertical
L1: 15u; MPIT4018-150M-LF
L300: 100n; L_0402_1005Metric
Q100: AO3401A; SOT-23
R100: 470R; R_0402_1005Metric
R101: 3k4; R_0402_1005Metric
R102: 1k02; R_0402_1005Metric
R103, R205: 1k; R_0402_1005Metric
R200, R202: 10k; R_0402_1005Metric
R201, R301, R302, R500, R501, R502, R503, R504, R505: 0R; R_0402_1005Metric
R203, R204: 2k2; R_0402_1005Metric
R206, R207, R208: 22R; R_0402_1005Metric
R300: 10R; R_0402_1005Metric
R506, R507, R508, R509, R510: 47k; R_0402_1005Metric
R511: 120R; R_0402_1005Metric
SW200: SW_SPDT; SW_SPDT_PCM12
U100: LM2842X; TSOT-23-6
U200: STM32F405RGT6; LQFP-64_10x10mm_P0.5mm
U201: USBLC6-2SC6; SOT-23-6
U300: MAX-M8Q; ublox_MAX
U400: SPL06-007; Bosch_LGA-8_2x2.5mm_P0.65mm_ClockwisePinNumbering
U401: MPU-6050; InvenSense_QFN-24_4x4mm_P0.5mm
U500: TJA1051T-3; SOIC-8_3.9x4.9mm_P1.27mm
Y200: 16MHz; Crystal_SMD_3225-4Pin_3.2x2.5mm

Connections:
+3V3: C102.1, C200.1, C201.1, C202.1, C203.1, C204.1, C205.1, C206.1, C300.1, C301.1, C302.1, C400.1, C401.1, C402.1, C403.1, C404.1, C503.2, D102.2, D201.1, FB500.2, FB501.2, J200.1, L1.2, R101.1, R203.1, R204.1, R506.1, R507.1, R508.1, R509.1, R510.1, SW200.3, U200.1, U200.13, U200.19, U200.32, U200.48, U200.64, U300.6, U300.8, U400.6, U400.8, U401.8, U401.13, U500.5
+5V: C100.1, C502.2, FB100.1, U100.4, U100.5, U500.3
/GPS/GPS_RX: R301.1, U300.3
/GPS/GPS_TX: R302.1, U300.2
/Microcontroller/CONN_SWCLK: D203.1, J200.4, R207.2
/Microcontroller/CONN_SWDIO: D204.1, J200.2, R206.2
/Microcontroller/CONN_SWO: D202.1, J200.6, R208.2
/Microcontroller/MCU_BOOT0: R200.1, U200.60
/Microcontroller/MCU_BOOT1: R202.1, U200.28
/Microcontroller/MCU_HSE_IN: C209.1, U200.5, Y200.1
/Microcontroller/MCU_HSE_OUT: R201.1, U200.6
/Microcontroller/MCU_HSE_OUT_R: C210.1, R201.2, Y200.3
/Microcontroller/MCU_LED_A: D200.2, U200.33
/Microcontroller/MCU_LED_K: D200.1, R205.1
/Microcontroller/MCU_VCAP1: C207.1, U200.31
/Microcontroller/MCU_VCAP2: C208.1, U200.47
/Microcontroller/SW_BOOT0: R200.2, SW200.2
/Miscellaneous/3V3_CAN: C504.1, D509.1, FB501.1, J501.1
/Miscellaneous/CAN+: D508.1, J501.2, R511.1, U500.7
/Miscellaneous/CAN-: D507.1, J501.3, R511.2, U500.6
/Miscellaneous/SD_CLK: D503.1, J500.5, R503.1
/Miscellaneous/SD_CMD: D502.1, J500.3, R502.1, R508.2
/Miscellaneous/SD_DAT0: D504.1, J500.7, R504.1, R507.2
/Miscellaneous/SD_DAT1: D505.1, J500.8, R505.1, R506.2
/Miscellaneous/SD_DAT2: D500.1, J500.1, R500.1, R510.2
/Miscellaneous/SD_DAT3: D501.1, J500.2, R501.1, R509.2
/Miscellaneous/SD_VDD: C500.2, C501.2, D506.1, FB500.1, J500.4
/Sensors/IMU_CPOUT: C406.1, U401.20
/Sensors/IMU_REGOUT: C405.1, U401.10
CAN_SILENT: U200.2, U500.8
CONN_USB_D+: J201.3, U201.3
CONN_USB_D-: J201.2, U201.1
GND: C100.2, C102.2, C200.2, C201.2, C202.2, C203.2, C204.2, C205.2, C206.2, C207.2, C208.2, C209.2, C210.2, C212.1, C300.2, C301.2, C302.2, C303.2, C400.2, C401.2, C402.2, C403.2, C404.2, C405.2, C406.2, C500.1, C501.1, C502.1, C503.1, C504.2, D101.2, D201.2, D202.2, D203.2, D204.2, D205.2, D300.2, D500.2, D501.2, D502.2, D503.2, D504.2, D505.2, D506.2, D507.2, D508.2, D509.2, H500.1, H501.1, H502.1, H503.1, J200.3, J200.5, J200.9, J201.5, J300.2, J500.6, J500.9, J501.4, R100.2, R102.2, R103.2, R202.2, R205.2, SW200.1, U100.2, U200.12, U200.18, U200.63, U201.2, U300.1, U300.10, U300.12, U400.1, U400.7, U401.9, U401.18, U500.2, Y200.2, Y200.4
GPS_NRST: U200.9, U300.9
GPS_ONOFF: U200.16, U300.5
GPS_PPS: U200.17, U300.4
IMU_INTERRUPT: U200.27, U401.12
MCU_CAN1_RX: U200.61, U500.4
MCU_CAN1_TX: U200.62, U500.1
MCU_I2C2_SCL: R203.2, U200.29, U401.23
MCU_I2C2_SDA: R204.2, U200.30, U401.24
MCU_SDIO_CK: R503.2, U200.53
MCU_SDIO_CMD: R502.2, U200.54
MCU_SDIO_D0: R504.2, U200.39
MCU_SDIO_D1: R505.2, U200.40
MCU_SDIO_D2: R500.2, U200.51
MCU_SDIO_D3: R501.2, U200.52
MCU_SPI1_MISO: U200.22, U400.5
MCU_SPI1_MOSI: U200.23, U400.3
MCU_SPI1_NSS: U200.20, U400.2
MCU_SPI1_SCK: U200.21, U400.4
MCU_SWCLK: R207.1, U200.49
MCU_SWDIO: R206.1, U200.46
MCU_SWO: R208.1, U200.55
MCU_UART4_RX: R302.2, U200.15
MCU_UART4_TX: R301.2, U200.14
MCU_USB_D+: U200.45, U201.4
MCU_USB_D-: U200.44, U201.6
unnamed: C101.1, D101.1, L1.1, U100.6
unnamed: C101.2, U100.1
unnamed: C303.1, L300.1, R300.1
unnamed: D100.1, FB100.2, Q100.2
unnamed: D100.2, Q100.1, R100.1
unnamed: D102.1, R103.1
unnamed: D300.1, J300.1, L300.2, U300.11
unnamed: R101.2, R102.1, U100.3
unnamed: R300.2, U300.14
VBUS: C212.2, D205.1, J201.1, Q100.3, U201.5
