juan-LARRAYA/TPP/firmware/demos/TPP STM/STM/workspace_1.16.1/STM32F405_EPS/STM32F405_EPS.ioc

Mcu.UserName=STM32F405RGTx
PA0-WKUP.GPIO_Label=MPPTYControl
PA0-WKUP.Signal=S_TIM2_CH1_ETR
PA1.GPIO_Label=MPPZ_CUR
PA1.Signal=ADCx_IN1
PA13.GPIO_Label=SWDIO
PA13.Signal=SYS_JTMS-SWDIO
PA14.GPIO_Label=SWCLK
PA14.Signal=SYS_JTCK-SWCLK
PA2.GPIO_Label=MPPZ_VOL
PA2.Signal=ADCx_IN2
PA3.GPIO_Label=MPPTZControl
PA3.Signal=S_TIM5_CH4
PA4.GPIO_Label=CUR_5BIS
PA4.Signal=ADCx_IN4
PA5.GPIO_Label=VOL_5BIS
PA5.Signal=ADCx_IN5
PA6.GPIO_Label=VOL_3.3V
PA6.Signal=ADCx_IN6
PA7.GPIO_Label=CUR_3.3V
PA7.Signal=ADCx_IN7
PA8.GPIO_Label=SCL_I2C_COM
PA8.Signal=I2C3_SCL
PA9.GPIO_Label=EnableBatOut
PA9.Signal=GPIO_Output
PB0.GPIO_Label=CELL_MENOS
PB0.Signal=ADCx_IN8
PB11.GPIO_Label=Enable3.3V
PB11.Signal=GPIO_Output
PB12.GPIO_Label=Enable5VBis
PB12.Signal=GPIO_Output
PB14.GPIO_Label=EnableCalefactor 
PB14.Signal=GPIO_Output
PB6.GPIO_Label=SCL_I2C_BMS
PB6.Signal=I2C1_SCL
PB7.GPIO_Label=SDA_I2C_BMS
PB7.Signal=I2C1_SDA
PB8.GPIO_Label=BMS-Alert
PB8.Signal=GPIO_Input
PB9.GPIO_Label=MPPTXControl
PB9.Signal=S_TIM4_CH4
PC0.GPIO_Label=MPPX_CUR
PC0.Signal=ADCx_IN10
PC1.GPIO_Label=MPPX_VOL
PC1.Signal=ADCx_IN11
PC10.GPIO_Label=TX
PC10.Signal=UART4_TX
PC11.GPIO_Label=RX
PC11.Signal=UART4_RX
PC2.GPIO_Label=MPPY_CUR
PC2.Signal=ADCx_IN12
PC3.GPIO_Label=MPPY_VOL
PC3.Signal=ADCx_IN13
PC4.GPIO_Label=CELL_MAS
PC4.Signal=ADCx_IN14
PC5.GPIO_Label=CURR_BQ29330
PC5.Signal=ADCx_IN15
PC6.Signal=S_TIM3_CH1
PC9.GPIO_Label=SDA_I2C_COM
PC9.Signal=I2C3_SDA
PH0-OSC_IN.Signal=RCC_OSC_IN
PH1-OSC_OUT.Signal=RCC_OSC_OUT
