juan-LARRAYA/TPP/firmware/demos/TPP STM/STM/workspace_1.16.1/STM32F405_EPS/Core/Inc/main.h

#define MPPX_CUR_Pin GPIO_PIN_0
#define MPPX_CUR_GPIO_Port GPIOC
#define MPPX_VOL_Pin GPIO_PIN_1
#define MPPX_VOL_GPIO_Port GPIOC
#define MPPY_CUR_Pin GPIO_PIN_2
#define MPPY_CUR_GPIO_Port GPIOC
#define MPPY_VOL_Pin GPIO_PIN_3
#define MPPY_VOL_GPIO_Port GPIOC
#define MPPTYControl_Pin GPIO_PIN_0
#define MPPTYControl_GPIO_Port GPIOA
#define MPPZ_CUR_Pin GPIO_PIN_1
#define MPPZ_CUR_GPIO_Port GPIOA
#define MPPZ_VOL_Pin GPIO_PIN_2
#define MPPZ_VOL_GPIO_Port GPIOA
#define MPPTZControl_Pin GPIO_PIN_3
#define MPPTZControl_GPIO_Port GPIOA
#define CUR_5BIS_Pin GPIO_PIN_4
#define CUR_5BIS_GPIO_Port GPIOA
#define VOL_5BIS_Pin GPIO_PIN_5
#define VOL_5BIS_GPIO_Port GPIOA
#define VOL_3_3V_Pin GPIO_PIN_6
#define VOL_3_3V_GPIO_Port GPIOA
#define CUR_3_3V_Pin GPIO_PIN_7
#define CUR_3_3V_GPIO_Port GPIOA
#define CELL_MAS_Pin GPIO_PIN_4
#define CELL_MAS_GPIO_Port GPIOC
#define CURR_BQ29330_Pin GPIO_PIN_5
#define CURR_BQ29330_GPIO_Port GPIOC
#define CELL_MENOS_Pin GPIO_PIN_0
#define CELL_MENOS_GPIO_Port GPIOB
#define Enable3_3V_Pin GPIO_PIN_11
#define Enable3_3V_GPIO_Port GPIOB
#define Enable5VBis_Pin GPIO_PIN_12
#define Enable5VBis_GPIO_Port GPIOB
#define EnableCalefactor_Pin GPIO_PIN_14
#define EnableCalefactor_GPIO_Port GPIOB
#define SDA_I2C_COM_Pin GPIO_PIN_9
#define SDA_I2C_COM_GPIO_Port GPIOC
#define SCL_I2C_COM_Pin GPIO_PIN_8
#define SCL_I2C_COM_GPIO_Port GPIOA
#define EnableBatOut_Pin GPIO_PIN_9
#define EnableBatOut_GPIO_Port GPIOA
#define SWDIO_Pin GPIO_PIN_13
#define SWDIO_GPIO_Port GPIOA
#define SWCLK_Pin GPIO_PIN_14
#define SWCLK_GPIO_Port GPIOA
#define TX_Pin GPIO_PIN_10
#define TX_GPIO_Port GPIOC
#define RX_Pin GPIO_PIN_11
#define RX_GPIO_Port GPIOC
#define SCL_I2C_BMS_Pin GPIO_PIN_6
#define SCL_I2C_BMS_GPIO_Port GPIOB
#define SDA_I2C_BMS_Pin GPIO_PIN_7
#define SDA_I2C_BMS_GPIO_Port GPIOB
#define BMS_Alert_Pin GPIO_PIN_8
#define BMS_Alert_GPIO_Port GPIOB
#define MPPTXControl_Pin GPIO_PIN_9
#define MPPTXControl_GPIO_Port GPIOB
#define ARDUINO_I2C_ADDRESS 0x08  		// Dirección I2C del Arduino
#define ARDUINO_I2C_ADDRESS 0x08  		// Dirección I2C del Arduino
#define BMS_I2C_ADDRESS (0x20 << 1)			// Dirección I2C del BMS
#define STR_LEN 200
#define BUFFER_SIZE 64  				// Tamaño del buffer de transmisión
#define NUM_SAMPLES 200
#define JUAN_NICOLS 0.89
