juan-LARRAYA/TPP/firmware/demos/TPP STM/STM/otros STM32/BLUEPILL_CHINA/Core/Src/main.c

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
/* Includes ------------------------------------------------------------------*/
#include "main.h"

/* USER CODE BEGIN Includes */
#include "stdio.h"
#include "string.h"

/* USER CODE END Includes */

/* USER CODE BEGIN PTD */
//Aquí defines nuevos tipos de datos (typedef)
/* USER CODE END PTD */

/* USER CODE BEGIN PD */
//definir macros #define
#define ACTIVADOR_PIN GPIO_PIN_13
#define ACTIVADOR_PORT GPIOC

#define VPANEL_CHANNEL ADC_CHANNEL_1
#define IPANEL_CHANNEL ADC_CHANNEL_6

#define PWM_TIMER &htim1

/* USER CODE END PD */

ADC_HandleTypeDef hadc1;

TIM_HandleTypeDef htim1;

UART_HandleTypeDef huart1;

/* USER CODE BEGIN PV */
//defini aca las varaibles privadas
const int PWM_MPPT_Pin = PWM_Pin;    // Cambia por el pin que estés usando
const int pinVoltageInput = V_panel_Pin; // Entrada analógica para medir el voltaje de entrada A0
const int pinCurrentInput = I_panel_Pin; // Entrada analógica para medir la corriente de entrada A1

// Variables globales

/* USER CODE END PV */
float V_in = 0;
float I_in = 0;
float power = 0;
float previousPower = 0;
int dutyCycle = 255 * 0.5; // Valor inicial del Duty Cycle (50% para PWM de 8 bits)


void SystemClock_Config(void);
static void MX_GPIO_Init(void);
static void MX_ADC1_Init(void);
static void MX_TIM1_Init(void);
static void MX_USART1_UART_Init(void);
/* USER CODE BEGIN PFP */
uint32_t readADC(ADC_HandleTypeDef *hadc, uint32_t channel);

void mppt(int *dutyCycle, float *power, float *previousPower);
/* USER CODE END PFP */

/* USER CODE BEGIN 0 */

uint32_t readADC(ADC_HandleTypeDef *hadc, uint32_t channel) {
	ADC_ChannelConfTypeDef sConfig = { 0 };

	// Configurar el canal que se desea leer
	sConfig.Channel = channel;
	sConfig.Rank = ADC_REGULAR_RANK_1;
	sConfig.SamplingTime = ADC_SAMPLETIME_1CYCLE_5;

	if (HAL_ADC_ConfigChannel(hadc, &sConfig) != HAL_OK) {
		Error_Handler(); // Maneja errores de configuración
	}

	// Inicia la conversión del ADC
	HAL_ADC_Start(hadc);

	// Espera hasta que la conversión termine
	if (HAL_ADC_PollForConversion(hadc, HAL_MAX_DELAY) == HAL_OK) {
		// Retorna el valor convertido
		return HAL_ADC_GetValue(hadc);
	}

	return 0; // Retorna 0 en caso de error
}

void mppt(int *dutyCycle, float *power, float *previousPower) {
	const int deltaDuty = 10;    // Incremento o decremento del Duty Cycle
	if (*power > *previousPower) {
		if (*dutyCycle < 255)
			*dutyCycle += deltaDuty; // Si la potencia ha aumentado, continuar ajustando en la misma dirección
	} else {
		if (*dutyCycle > 0)
			*dutyCycle -= deltaDuty; // Si la potencia ha disminuido, invertir la dirección del ajuste
	}

	if (*dutyCycle < 0)
		*dutyCycle = 0; // Asegurar que el Duty Cycle esté dentro de los límites permitidos (0-255)
	if (*dutyCycle > 255)
		*dutyCycle = 255;

	*previousPower = *power; // Actualizar `previousPower` con el valor actual de `power`
}

/* USER CODE END 0 */

/**
  * @brief  The application entry point.
  * @retval int
  */
int main(void)
{

  /* MCU Configuration--------------------------------------------------------*/

  /* Reset of all peripherals, Initializes the Flash interface and the Systick. */
  HAL_Init();

  /* Configure the system clock */
  SystemClock_Config();

  /* Initialize all configured peripherals */
  MX_GPIO_Init();
  MX_ADC1_Init();
  MX_TIM1_Init();
  MX_USART1_UART_Init();
  /* USER CODE BEGIN 2 */
	// Iniciar PWM
	HAL_TIM_PWM_Start(&htim1, TIM_CHANNEL_1);
	//HAL_TIM_PWM_Start(&htim1, TIM_CHANNEL_1);
  /* USER CODE END 2 */

  /* Infinite loop */
  /* USER CODE BEGIN WHILE */
	while (1) {
		// Leer voltaje y corriente usando ADC
		V_in = readADC(&hadc1, VPANEL_CHANNEL) * (3.3 / 4095.0);
		I_in = readADC(&hadc1, IPANEL_CHANNEL) * (3.3 / 4095.0);

		// Calcular potencia
		power = V_in * I_in;

		// Algoritmo MPPT
		int i =0;
		if(i==0) power = 0.5;
		if(i==10) power = 1.5;
		if(i>10) i = 0;
		i++;

		mppt(&dutyCycle, &power, &previousPower);


		// Ajustar ciclo de trabajo del PWM
		//dutyCycle = 150;
		__HAL_TIM_SET_COMPARE(&htim1, TIM_CHANNEL_1, dutyCycle);
		// Imprimir datos al puerto serie
		char buffer[100];
		sprintf(buffer, "V_in: %.2f V, I_in: %.2f A, Power: %.2f W\n", V_in,
				I_in, power); // @suppress("Float formatting support")
		HAL_UART_Transmit(&huart1, (uint8_t*) buffer, strlen(buffer),
				HAL_MAX_DELAY);

		// Guardar la potencia anterior
		previousPower = power;

		//char prueba[27]="welcome to the jungle! \n\r";
		//HAL_UART_Transmit(&huart1, (uint8_t *)prueba, 27, 1000);
//
////		Para prender y apagar el led que viene en la bluepil
//      HAL_GPIO_WritePin(GPIOC, ACTIVADOR_PIN, GPIO_PIN_SET);
//      HAL_Delay(1000); // 1 segundo de delay
//      HAL_GPIO_WritePin(GPIOC, ACTIVADOR_PIN, GPIO_PIN_RESET);
      HAL_Delay(500); // 1 segundo de delay
    /* USER CODE END WHILE */

    /* USER CODE BEGIN 3 */
	}
  /* USER CODE END 3 */
}

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
