juan-LARRAYA/TPP/firmware/demos/TPP STM/STM/workspace_1.16.1/STM32F405_EPS/Core/Src/usart.c

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
/* Includes ------------------------------------------------------------------*/
#include "usart.h"

UART_HandleTypeDef huart4;

/* UART4 init function */
void MX_UART4_Init(void)
{

  huart4.Instance = UART4;
  huart4.Init.BaudRate = 115200;
  huart4.Init.WordLength = UART_WORDLENGTH_8B;
  huart4.Init.StopBits = UART_STOPBITS_1;
  huart4.Init.Parity = UART_PARITY_NONE;
  huart4.Init.Mode = UART_MODE_TX_RX;
  huart4.Init.HwFlowCtl = UART_HWCONTROL_NONE;
  huart4.Init.OverSampling = UART_OVERSAMPLING_16;
  if (HAL_UART_Init(&huart4) != HAL_OK)
  {
    Error_Handler();
  }
}

void HAL_UART_MspInit(UART_HandleTypeDef* uartHandle)
{

  GPIO_InitTypeDef GPIO_InitStruct = {0};
  if(uartHandle->Instance==UART4)
  {
    /* UART4 clock enable */
    __HAL_RCC_UART4_CLK_ENABLE();

    __HAL_RCC_GPIOC_CLK_ENABLE();
    /**UART4 GPIO Configuration
    PC10     ------> UART4_TX
    PC11     ------> UART4_RX
    */
    GPIO_InitStruct.Pin = TX_Pin|RX_Pin;
    GPIO_InitStruct.Mode = GPIO_MODE_AF_PP;
    GPIO_InitStruct.Pull = GPIO_PULLUP;
    GPIO_InitStruct.Speed = GPIO_SPEED_FREQ_VERY_HIGH;
    GPIO_InitStruct.Alternate = GPIO_AF8_UART4;
    HAL_GPIO_Init(GPIOC, &GPIO_InitStruct);

  }
}

void HAL_UART_MspDeInit(UART_HandleTypeDef* uartHandle)
{

  if(uartHandle->Instance==UART4)
  {
    /* Peripheral clock disable */
    __HAL_RCC_UART4_CLK_DISABLE();

    /**UART4 GPIO Configuration
    PC10     ------> UART4_TX
    PC11     ------> UART4_RX
    */
    HAL_GPIO_DeInit(GPIOC, TX_Pin|RX_Pin);

  }
}

/* USER CODE BEGIN 1 */
void sendUsartMsgLongUint(const char* label, int32_t value) {
	char buffer[BUFFER_SIZE];
	snprintf(buffer, BUFFER_SIZE, "%s %li \n", label, value);
	HAL_UART_Transmit(&huart4, (uint8_t*)buffer, strlen(buffer), HAL_MAX_DELAY);
}

void sendUsartMsgInt(const char* label, int16_t value) {
    char buffer[BUFFER_SIZE];
    snprintf(buffer, BUFFER_SIZE, "%s %i \n", label, value);
	HAL_UART_Transmit(&huart4, (uint8_t*)buffer, strlen(buffer), HAL_MAX_DELAY);
}

void sendUsartMsg(const char* label, uint16_t value) {
    char buffer[BUFFER_SIZE];
    snprintf(buffer, BUFFER_SIZE, "%s %u \n", label, value);
	HAL_UART_Transmit(&huart4, (uint8_t*)buffer, strlen(buffer), HAL_MAX_DELAY);
}




/* USER CODE END 1 */
