juan-LARRAYA/TPP/(commit log)

2024-09-26 Agregados archivos desde la carpeta 'folder'
2024-10-26 Add files via upload
    Primera version del diseño realizado, previo a ordenar los componentes y a rutear
    [BH24DW.step, DW01A--3DModel-STEP-56544.STEP, DW01A.step, TPP.kicad_pcb, TPP.kicad_sch]
2024-11-17 Añadir tres carpetas desde rutas diferentes
    [BH24DW.step, BMS+CONECTORS.kicad_sch, BluePhil-BOM.csv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]
2024-11-17 cambio en las estructuras de los directorios
    [BluePhil-BOM.csv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]
2025-12-02 feat: Finalizar la reorganización del repositorio y mover todo el código a la carpeta firmware
2025-12-07 docs: Update README with project images and failure analysis section
    - Added project prototype images (photos 1 and 5) showcasing final development
    - Included new section "Fallos Encontrados y Soluciones Implementadas"
    - Documented monolithic prototype failure and modular solution approach
    - Explained ADC acquisition inefficiency and I²C migration with INA219 sensors
    - Added photos 2 and 3 illustrating the challenges and initial designs
    - Reorganized repository structure (Hardware -> hardware case normalization)
    - Updated .gitignore for better project organization
    [BH24DW.step, BLUEPILL Debug.cfg, BLUEPILL_CHINA_128k Debug.cfg, BMS+CONECTORS.kicad_sch, BluePhil-BOM.csv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]
2025-12-07 filmware final
    [BLUEPILL Debug.cfg, BLUEPILL_CHINA_128k Debug.cfg, STM32F405_EPS.cfg, sensor_carga_samsung_20250707.csv, sensor_data-0.2C-DESCARGA-20250628-2031.xlsx, sensor_data-CARGA-20250622_1735.csv, sensor_data-CARGA-20250622_1735.xlsx, sensor_data-CARGA-20250624-0042.xlsx]
