juan-LARRAYA/TPP/(notices)

Notices in the files:
firmware/demos/TPP STM/STM/otros STM32/BLUEPILL ORIGINAL/Core/Src/usart.c:
Copyright (c) 2024 STMicroelectronics.
All rights reserved.
This software is licensed under terms that can be found in the LICENSE file
firmware/demos/TPP STM/STM/workspace_1.16.1/STM32F405_EPS/Core/Src/usart.c:
Copyright (c) 2025 STMicroelectronics.
